koboshchan/pcbai/renders/full_stack_v2/full_stack_top.png

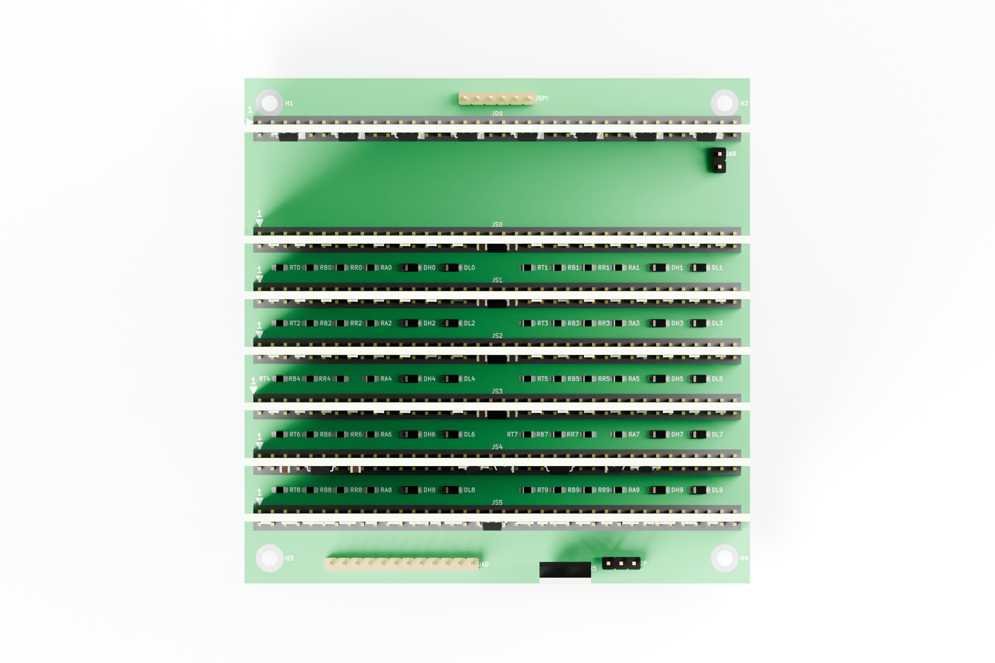
renders/full_stack_v2/full_stack_top.png
