koboshchan/pcbai/renders/ads_carrier/3d_top.png

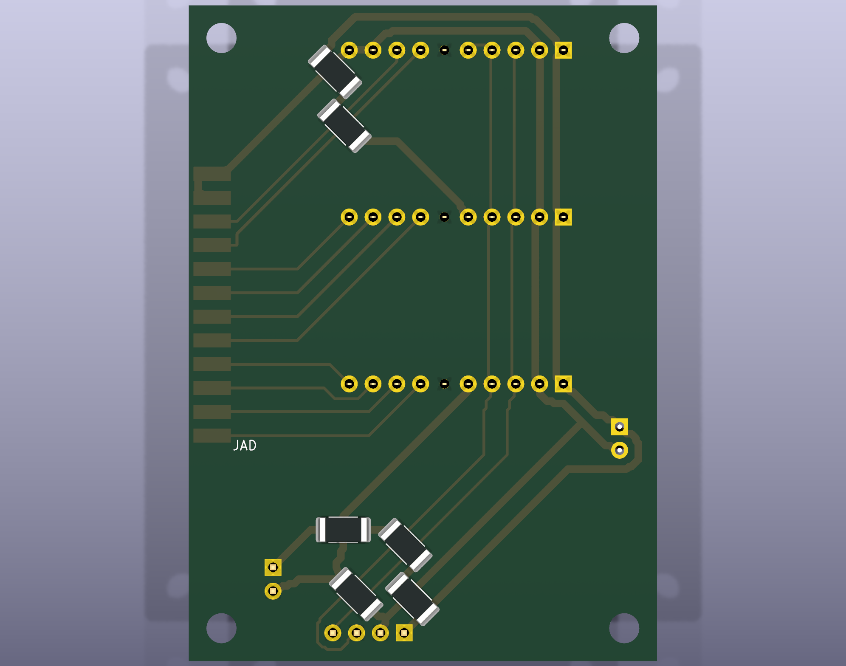
renders/ads_carrier/3d_top.png
