koboshchan/pcbai/training/fixed_model_basic/STATUS.md

Candidate complete. Official test94.54%, existing95.01%, rounded-only92.60%. All1034 resistors use21 Basic0805 values;0Extended. Save186USD assumed62x3USD Extended resistor setup fees. Fixed neural connectivity and component count unchanged. Old fixed_model and all PCB/routing files untouched. New value maps need CAD-owner integration and fresh audit, not automatic promotion. Static model only; rerun PWM dynamics and qualify real opamp/driver/regulator behavior before fabrication. See RESULT.md, metrics.json, checks.json and export_audit.json.
