koboshchan/pcbai/pdfs/motherboard_placement.pdf

# pcbai motherboard · TOP side (F.Cu), viewed from above

source post_crb.kicad_pcb sha256 4932b44c…d1ba · 76 parts on this side · board 100.0 × 100.0 mm · 1 mm = 4.66 pt Reminder: mandatory JS1 B7 → JS2 B7 bodge wire goes on the BOTTOM (see page 2).

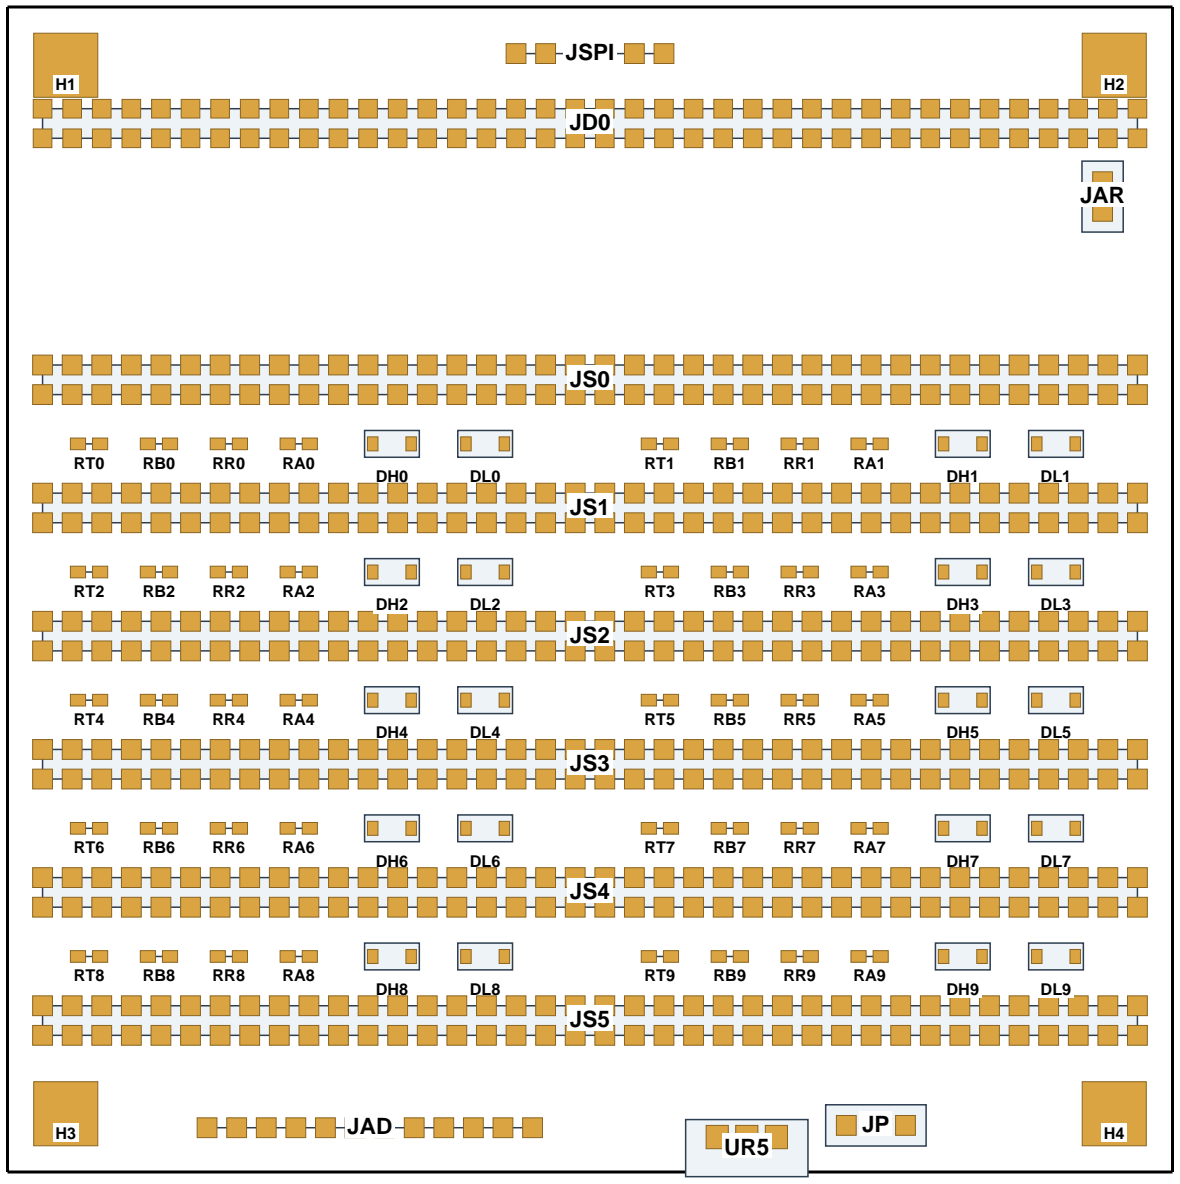
[picture p3: figure]
JAD; JAR; JSPI

pads (gold) and outlines from KiCad footprint pads/CrtYd/Fab geometry; no coordinates invented

# pcbai motherboard · BOTTOM side (B.Cu), MIRRORED: viewed from below

source post_crb.kicad_pcb sha256 4932b44c…d1ba · 9 parts on this side · board 100.0 × 100.0 mm · 1 mm = 4.66 pt
MANDATORY BOTTOM BODGE: wire JS1 pad B7 to JS2 pad B7 (red). Grey dashed = top-mounted THT parts, pins seen through.

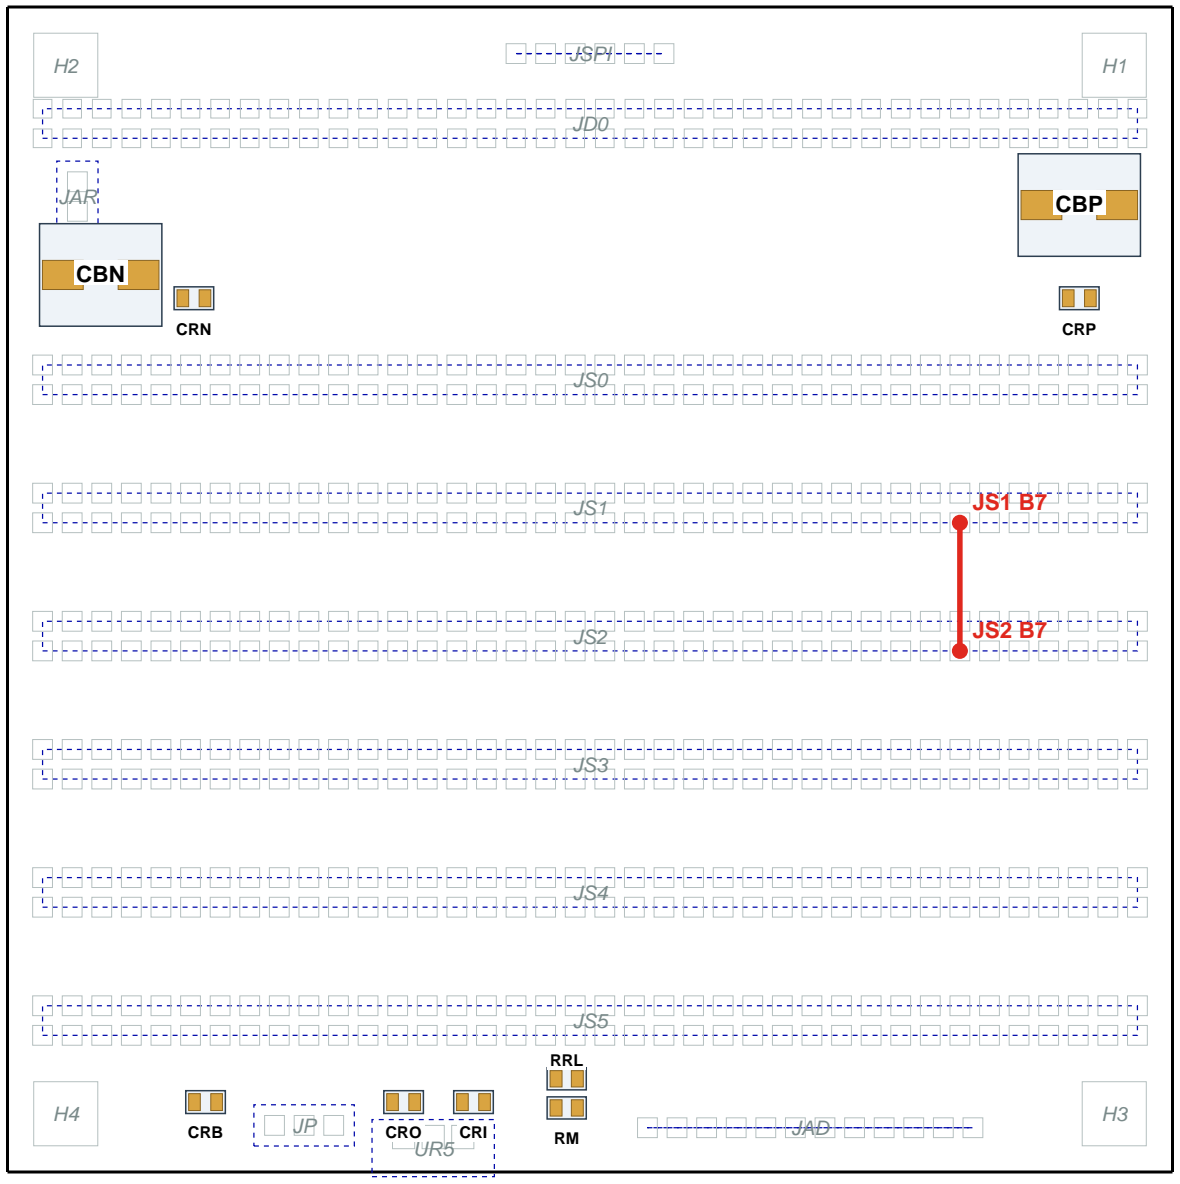
[picture p4: figure]
JAD; JAR; JSPI; RRL; CRP; CBP; CRI; CRN; CRB; CRO; CBN

Bodge endpoints (board mm, KiCad coords): JS1 B7 at (18.25, 44.27), JS2 B7 at (18.25, 55.27). Straight line shown is schematic; route the wire neatly. pads (gold) and outlines from KiCad footprint pads/CrtYd/Fab geometry; no coordinates invented
