koboshchan/pcbai/pdfs/ads_carrier_etch_mirrored_negative.pdf

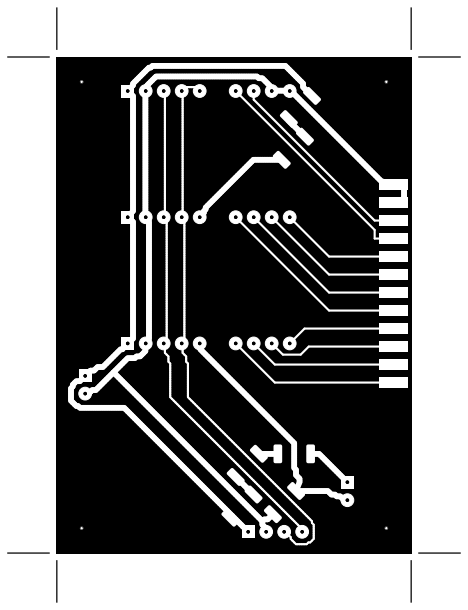
[picture p5: figure]

### SCALE CHECK: bar = exactly 10.0 mm | board = 50.0 x 70.0 mm

## MIRRORED NEGATIVE 1:1, print at 100% / no fit-to-page

ADS carrier v3 F.Cu | copper = clear/white, etch = black | dots = drill centers | src sha256 1405b457...bfd74
Note: 4 white 0.35 mm marks = 3.2 mm mounting-hole centers; they lie inside the drilled holes (intentional).
