koboshchan/pcbai/renders/ads_carrier/3d_bottom.png

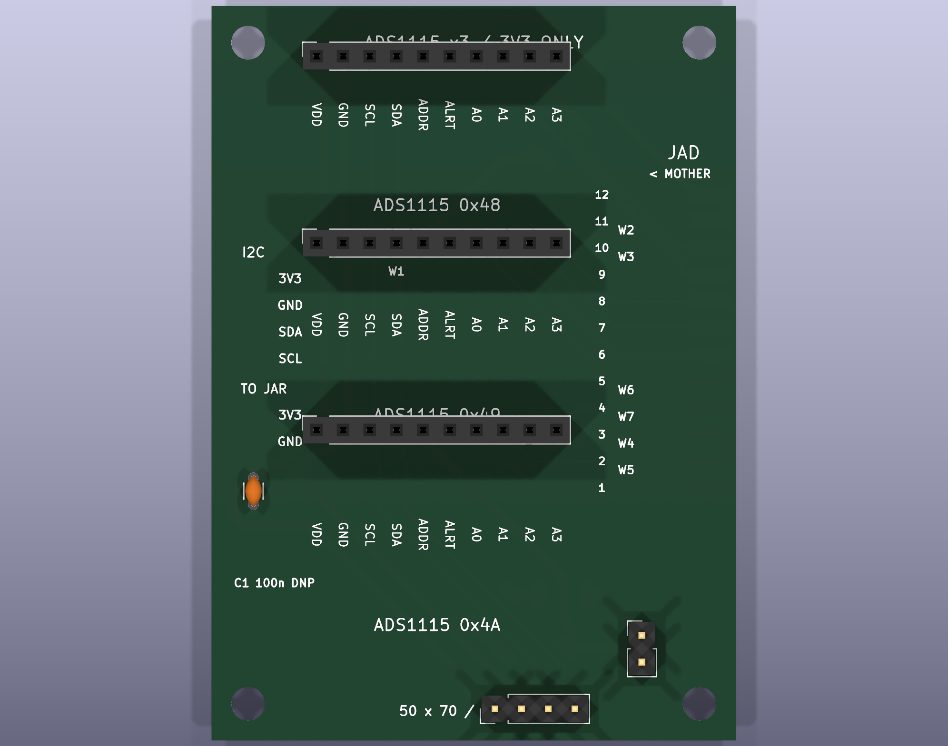
renders/ads_carrier/3d_bottom.png
