koboshchan/pcbai/renders/ads_carrier/copper.png

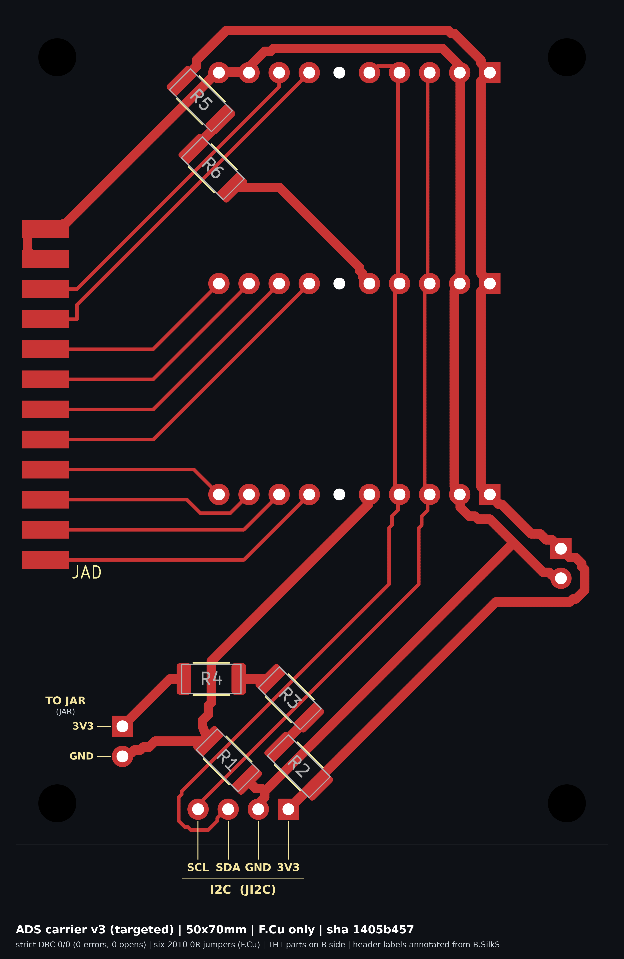
renders/ads_carrier/copper.png
