koboshchan/pcbai/renders/ads_carrier/etch_preview.png

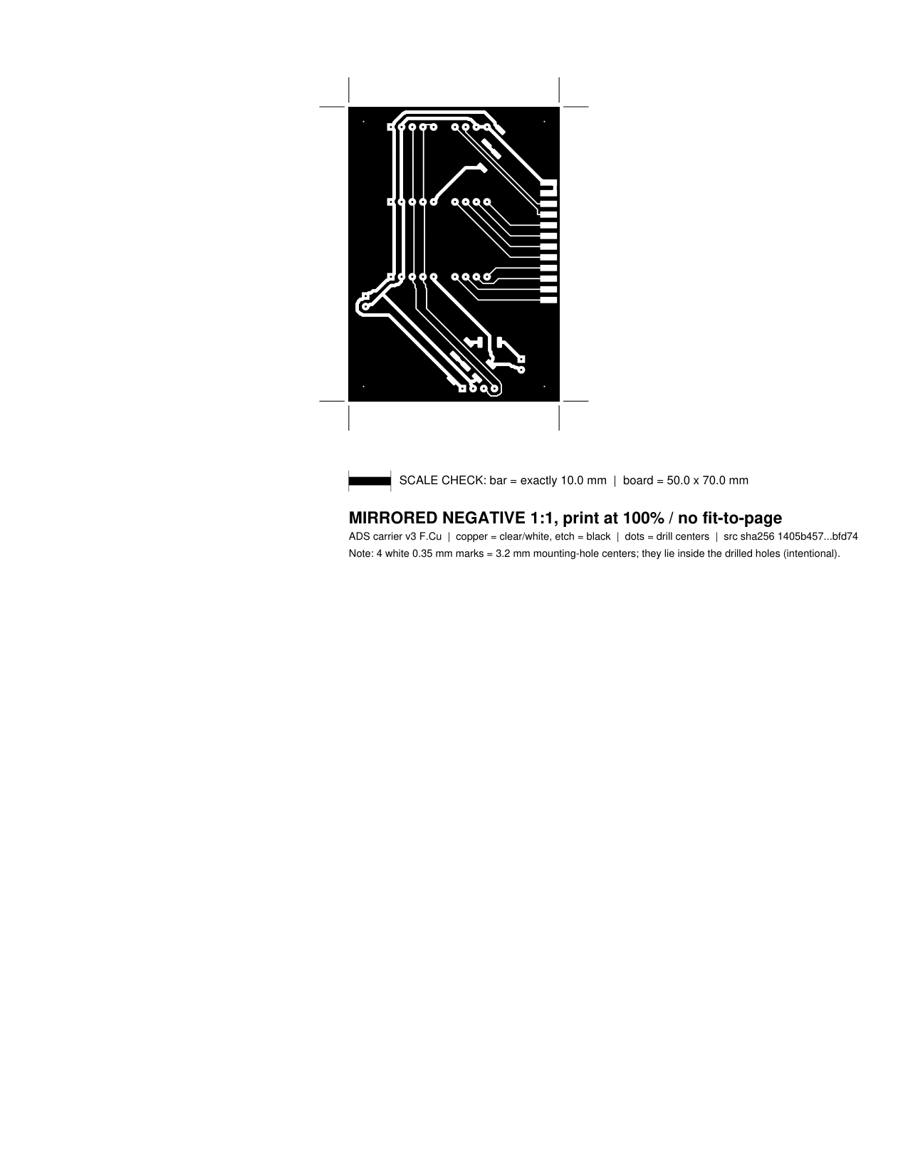
renders/ads_carrier/etch_preview.png
