koboshchan/pcbai/renders/dc0_v2_top.png

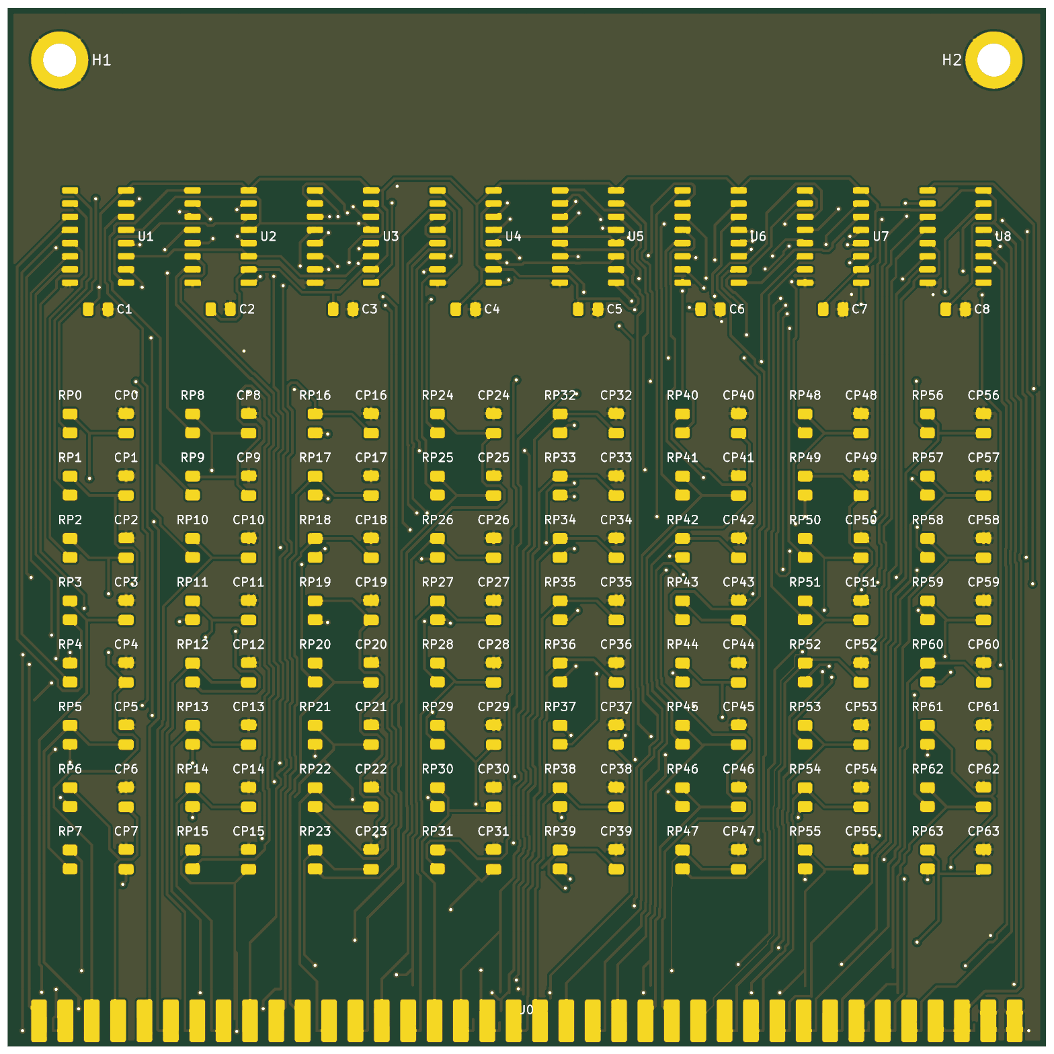
renders/dc0_v2_top.png
