koboshchan/pcbai/renders/dc1/dc1_final_in1_plane.png

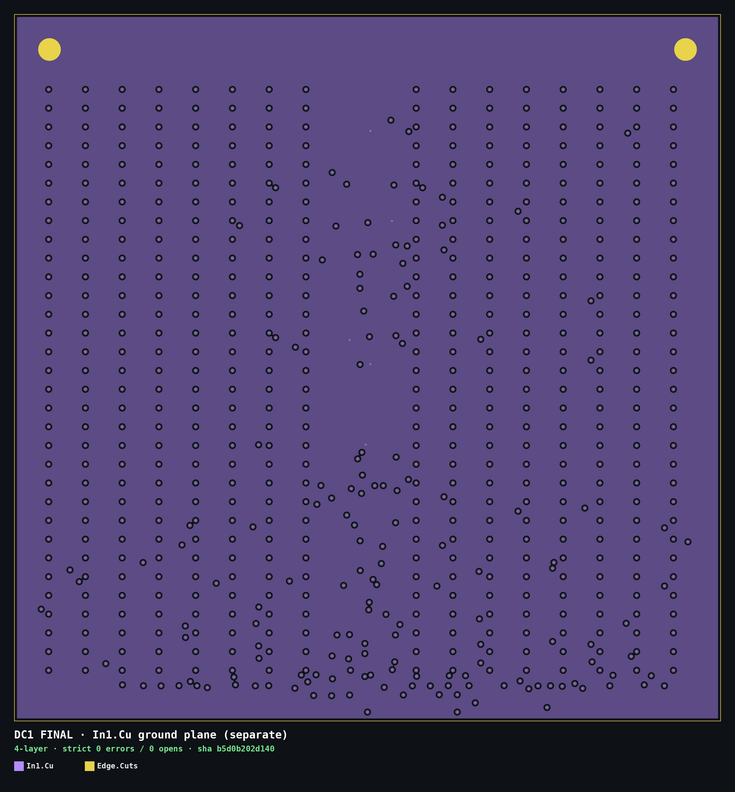
renders/dc1/dc1_final_in1_plane.png
