koboshchan/pcbai/renders/dc1/dc1_final_in2_overlay.png

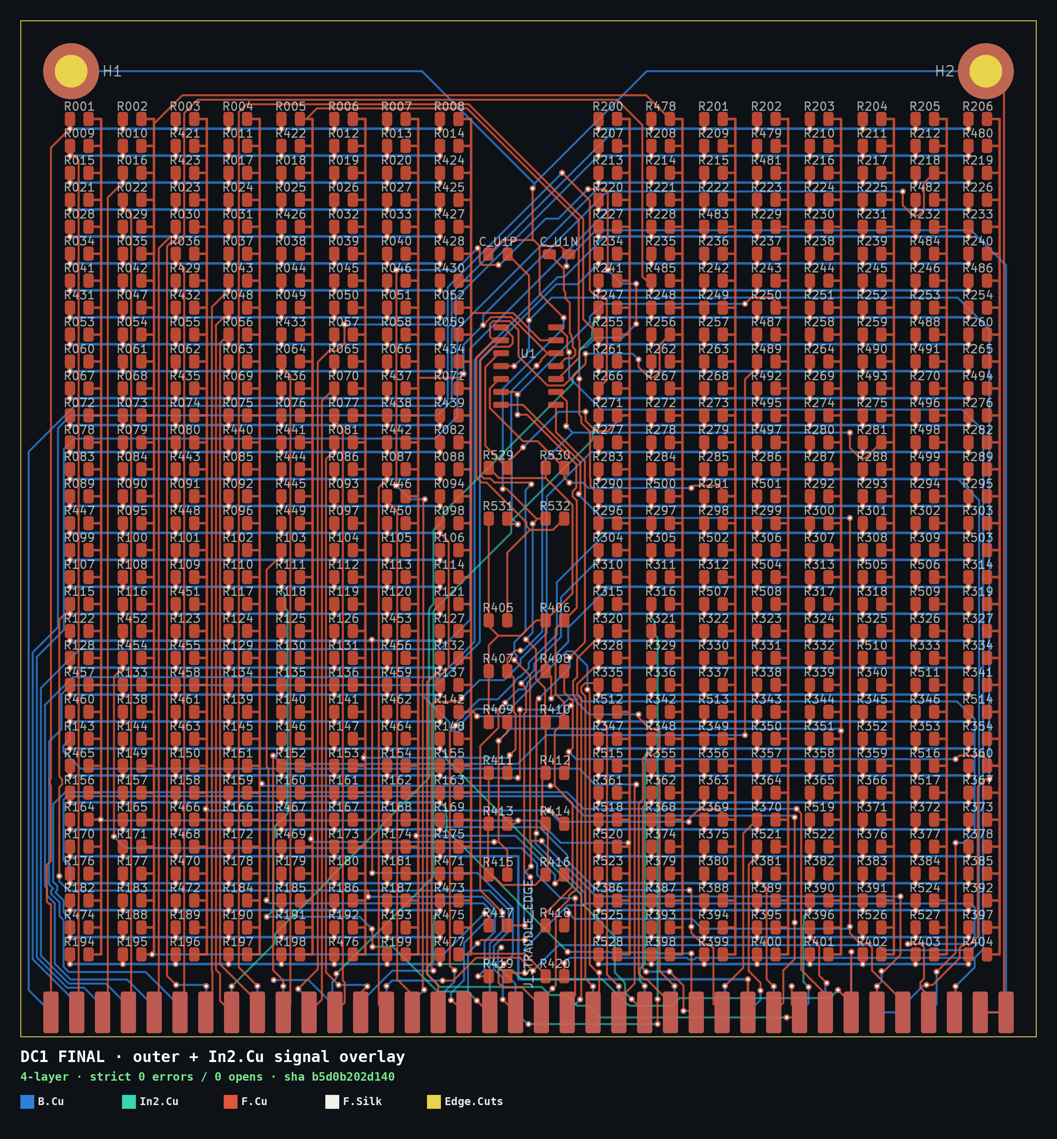
renders/dc1/dc1_final_in2_overlay.png
