koboshchan/pcbai/renders/dc1/dc1_final_outer.png

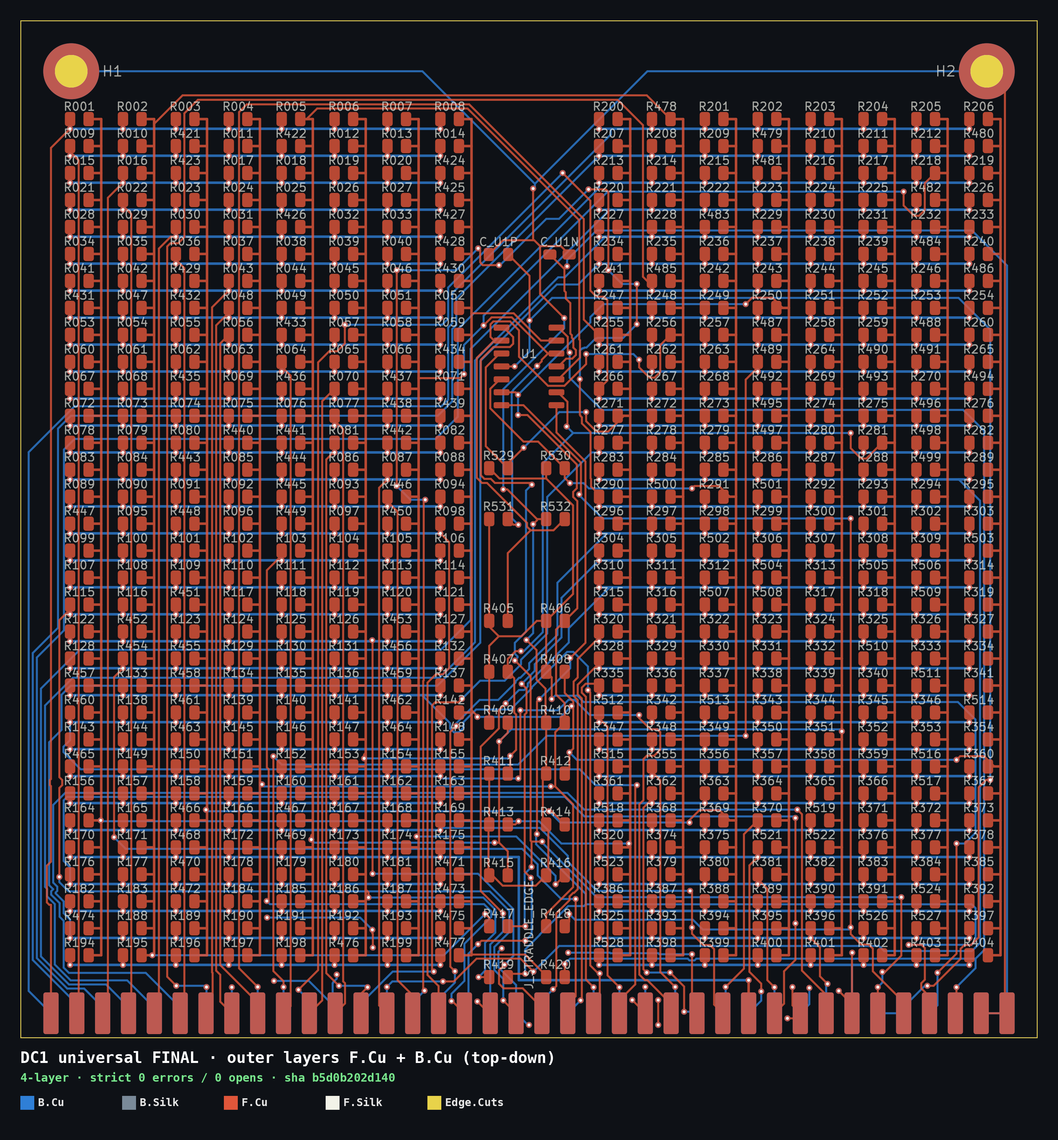
renders/dc1/dc1_final_outer.png
