koboshchan/pcbai/renders/dc3_v2_top.png

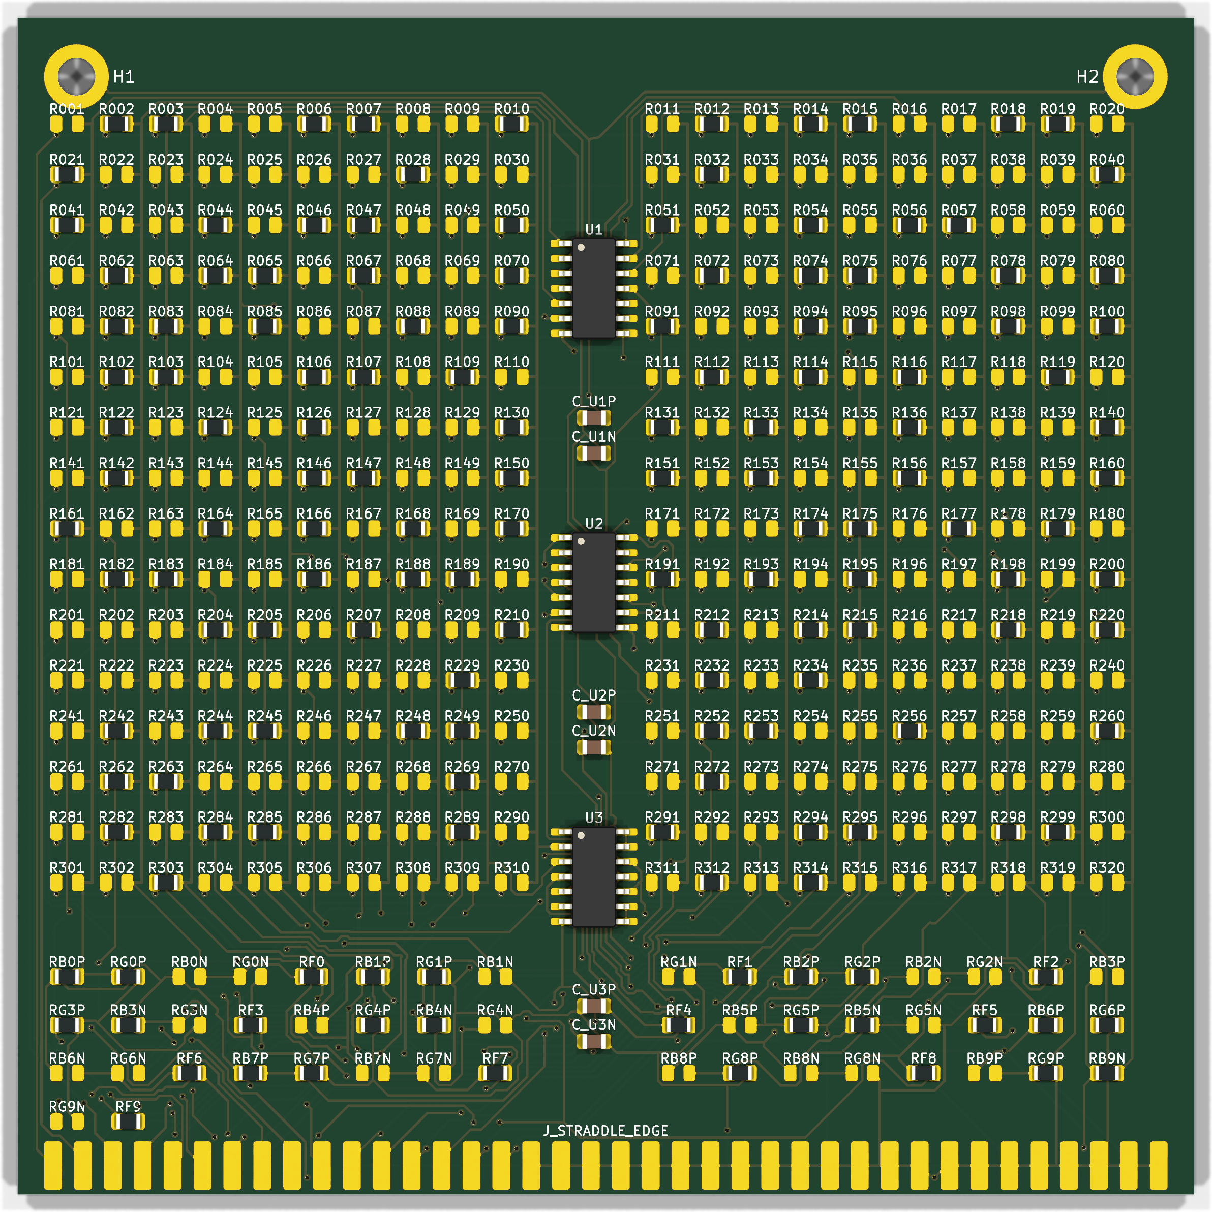
renders/dc3_v2_top.png
