koboshchan/pcbai/renders/full_stack_v2/full_stack_front.png

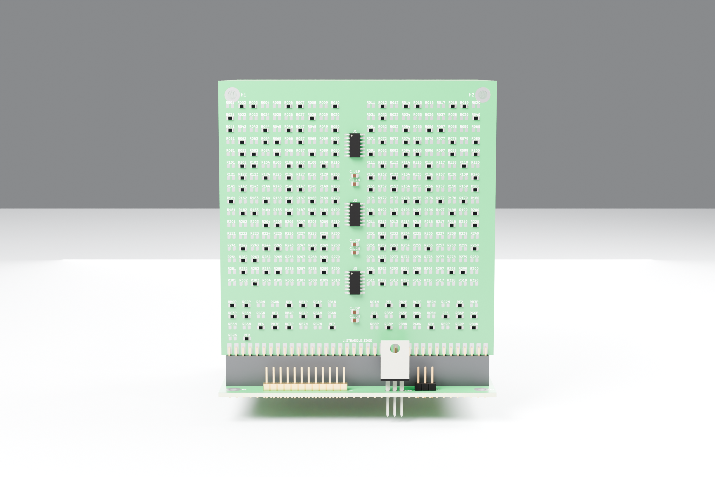
renders/full_stack_v2/full_stack_front.png
