koboshchan/pcbai/renders/full_stack_v2/full_stack_hero_34.png

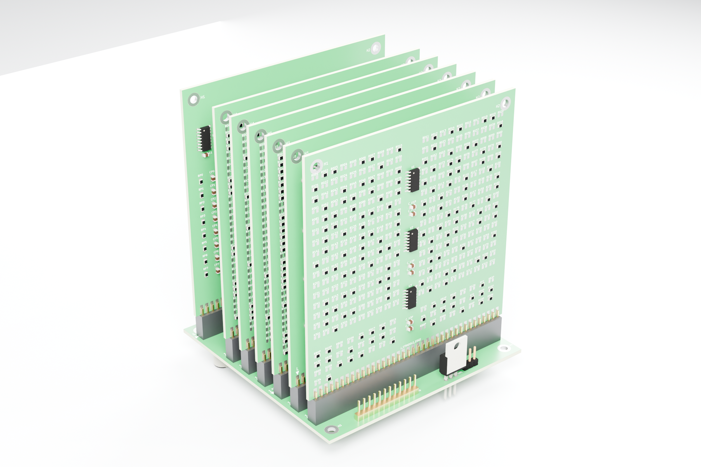
renders/full_stack_v2/full_stack_hero_34.png
