koboshchan/pcbai/renders/mb_v2_top.png

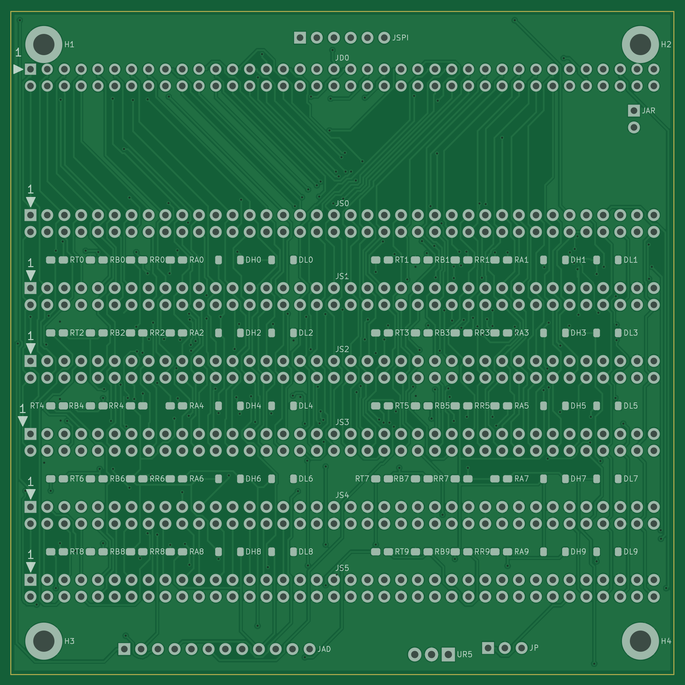
renders/mb_v2_top.png
