koboshchan/pcbai/boards/bom/DC2.csv

reference | value | package | footprint | side | status | tolerance_percent | x_mm | y_mm | source_value | original_reference
C_U1N | 0.1uF | C_0805_2012Metric | Capacitor_SMD:C_0805_2012Metric | F | FIT |  | 72.32 | 20.0 | 0.1uF
C_U1P | 0.1uF | C_0805_2012Metric | Capacitor_SMD:C_0805_2012Metric | F | FIT |  | 52.32 | 20.0 | 0.1uF
C_U2N | 0.1uF | C_0805_2012Metric | Capacitor_SMD:C_0805_2012Metric | F | FIT |  | 72.32 | 40.0 | 0.1uF
C_U2P | 0.1uF | C_0805_2012Metric | Capacitor_SMD:C_0805_2012Metric | F | FIT |  | 52.32 | 40.0 | 0.1uF
C_U3N | 0.1uF | C_0805_2012Metric | Capacitor_SMD:C_0805_2012Metric | F | FIT |  | 72.32 | 60.0 | 0.1uF
C_U3P | 0.1uF | C_0805_2012Metric | Capacitor_SMD:C_0805_2012Metric | F | FIT |  | 52.32 | 60.0 | 0.1uF
C_U4N | 0.1uF | C_0805_2012Metric | Capacitor_SMD:C_0805_2012Metric | F | FIT |  | 72.32 | 80.0 | 0.1uF
C_U4P | 0.1uF | C_0805_2012Metric | Capacitor_SMD:C_0805_2012Metric | F | FIT |  | 52.32 | 80.0 | 0.1uF
C_U_BUF1N | 0.1uF | C_0805_2012Metric | Capacitor_SMD:C_0805_2012Metric | F | FIT |  | 22.0 | 15.0 | 0.1uF
C_U_BUF1P | 0.1uF | C_0805_2012Metric | Capacitor_SMD:C_0805_2012Metric | F | FIT |  | 8.0 | 15.0 | 0.1uF
C_U_BUF2N | 0.1uF | C_0805_2012Metric | Capacitor_SMD:C_0805_2012Metric | F | FIT |  | 22.0 | 35.0 | 0.1uF
C_U_BUF2P | 0.1uF | C_0805_2012Metric | Capacitor_SMD:C_0805_2012Metric | F | FIT |  | 8.0 | 35.0 | 0.1uF
C_U_BUF3N | 0.1uF | C_0805_2012Metric | Capacitor_SMD:C_0805_2012Metric | F | FIT |  | 22.0 | 55.0 | 0.1uF
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
R_FB_11 | 10k | R_0805_2012Metric | Resistor_SMD:R_0805_2012Metric | F | FIT |  | 77.32 | 63.81 | 10k
R_FB_12 | 10k | R_0805_2012Metric | Resistor_SMD:R_0805_2012Metric | F | FIT |  | 47.32 | 76.19 | 10k
R_FB_13 | 10k | R_0805_2012Metric | Resistor_SMD:R_0805_2012Metric | F | FIT |  | 77.32 | 76.19 | 10k
R_FB_14 | 10k | R_0805_2012Metric | Resistor_SMD:R_0805_2012Metric | F | FIT |  | 47.32 | 83.81 | 10k
R_FB_15 | 10k | R_0805_2012Metric | Resistor_SMD:R_0805_2012Metric | F | FIT |  | 77.32 | 83.81 | 10k
R_IN_0 | 10k | R_0805_2012Metric | Resistor_SMD:R_0805_2012Metric | F | FIT |  | 43.32 | 16.19 | 10k
R_IN_1 | 10k | R_0805_2012Metric | Resistor_SMD:R_0805_2012Metric | F | FIT |  | 81.32 | 16.19 | 10k
R_IN_2 | 10k | R_0805_2012Metric | Resistor_SMD:R_0805_2012Metric | F | FIT |  | 43.32 | 23.81 | 10k
R_IN_3 | 10k | R_0805_2012Metric | Resistor_SMD:R_0805_2012Metric | F | FIT |  | 81.32 | 23.81 | 10k
R_IN_4 | 10k | R_0805_2012Metric | Resistor_SMD:R_0805_2012Metric | F | FIT |  | 43.32 | 36.19 | 10k
R_IN_5 | 10k | R_0805_2012Metric | Resistor_SMD:R_0805_2012Metric | F | FIT |  | 81.32 | 36.19 | 10k
R_IN_6 | 10k | R_0805_2012Metric | Resistor_SMD:R_0805_2012Metric | F | FIT |  | 43.32 | 43.81 | 10k
R_IN_7 | 10k | R_0805_2012Metric | Resistor_SMD:R_0805_2012Metric | F | FIT |  | 81.32 | 43.81 | 10k
R_IN_8 | 10k | R_0805_2012Metric | Resistor_SMD:R_0805_2012Metric | F | FIT |  | 43.32 | 56.19 | 10k
R_IN_9 | 10k | R_0805_2012Metric | Resistor_SMD:R_0805_2012Metric | F | FIT |  | 81.32 | 56.19 | 10k
R_IN_10 | 10k | R_0805_2012Metric | Resistor_SMD:R_0805_2012Metric | F | FIT |  | 43.32 | 63.81 | 10k
R_IN_11 | 10k | R_0805_2012Metric | Resistor_SMD:R_0805_2012Metric | F | FIT |  | 81.32 | 63.81 | 10k
R_IN_12 | 10k | R_0805_2012Metric | Resistor_SMD:R_0805_2012Metric | F | FIT |  | 43.32 | 76.19 | 10k
R_IN_13 | 10k | R_0805_2012Metric | Resistor_SMD:R_0805_2012Metric | F | FIT |  | 81.32 | 76.19 | 10k
R_IN_14 | 10k | R_0805_2012Metric | Resistor_SMD:R_0805_2012Metric | F | FIT |  | 43.32 | 83.81 | 10k
R_IN_15 | 10k | R_0805_2012Metric | Resistor_SMD:R_0805_2012Metric | F | FIT |  | 81.32 | 83.81 | 10k
U1 | TL074 | SOIC-14_3.9x8.7mm_P1.27mm | Package_SO:SOIC-14_3.9x8.7mm_P1.27mm | F | FIT |  | 62.32 | 20.0 | TL074
U2 | TL074 | SOIC-14_3.9x8.7mm_P1.27mm | Package_SO:SOIC-14_3.9x8.7mm_P1.27mm | F | FIT |  | 62.32 | 40.0 | TL074
U3 | TL074 | SOIC-14_3.9x8.7mm_P1.27mm | Package_SO:SOIC-14_3.9x8.7mm_P1.27mm | F | FIT |  | 62.32 | 60.0 | TL074
U4 | TL074 | SOIC-14_3.9x8.7mm_P1.27mm | Package_SO:SOIC-14_3.9x8.7mm_P1.27mm | F | FIT |  | 62.32 | 80.0 | TL074
U_BUF1 | TL074 | SOIC-14_3.9x8.7mm_P1.27mm | Package_SO:SOIC-14_3.9x8.7mm_P1.27mm | F | FIT |  | 15.0 | 15.0 | TL074
U_BUF2 | TL074 | SOIC-14_3.9x8.7mm_P1.27mm | Package_SO:SOIC-14_3.9x8.7mm_P1.27mm | F | FIT |  | 15.0 | 35.0 | TL074
U_BUF3 | TL074 | SOIC-14_3.9x8.7mm_P1.27mm | Package_SO:SOIC-14_3.9x8.7mm_P1.27mm | F | FIT |  | 15.0 | 55.0 | TL074
U_BUF4 | TL074 | SOIC-14_3.9x8.7mm_P1.27mm | Package_SO:SOIC-14_3.9x8.7mm_P1.27mm | F | FIT |  | 15.0 | 75.0 | TL074
