koboshchan/pcbai/boards/bom/motherboard_TOP.csv

reference | value | footprint | side | status | x_mm | y_mm
DH0 | 1N4148W | D_SOD-123 | F | FIT | 33.0 | 37.5
DH1 | 1N4148W | D_SOD-123 | F | FIT | 82.0 | 37.5
DH2 | 1N4148W | D_SOD-123 | F | FIT | 33.0 | 48.5
DH3 | 1N4148W | D_SOD-123 | F | FIT | 82.0 | 48.5
DH4 | 1N4148W | D_SOD-123 | F | FIT | 33.0 | 59.5
DH5 | 1N4148W | D_SOD-123 | F | FIT | 82.0 | 59.5
DH6 | 1N4148W | D_SOD-123 | F | FIT | 33.0 | 70.5
DH7 | 1N4148W | D_SOD-123 | F | FIT | 82.0 | 70.5
DH8 | 1N4148W | D_SOD-123 | F | FIT | 33.0 | 81.5
DH9 | 1N4148W | D_SOD-123 | F | FIT | 82.0 | 81.5
DL0 | 1N4148W | D_SOD-123 | F | FIT | 41.0 | 37.5
DL1 | 1N4148W | D_SOD-123 | F | FIT | 90.0 | 37.5
DL2 | 1N4148W | D_SOD-123 | F | FIT | 41.0 | 48.5
DL3 | 1N4148W | D_SOD-123 | F | FIT | 90.0 | 48.5
DL4 | 1N4148W | D_SOD-123 | F | FIT | 41.0 | 59.5
DL5 | 1N4148W | D_SOD-123 | F | FIT | 90.0 | 59.5
DL6 | 1N4148W | D_SOD-123 | F | FIT | 41.0 | 70.5
DL7 | 1N4148W | D_SOD-123 | F | FIT | 90.0 | 70.5
DL8 | 1N4148W | D_SOD-123 | F | FIT | 41.0 | 81.5
DL9 | 1N4148W | D_SOD-123 | F | FIT | 90.0 | 81.5
JAD | Scores_DIV_3V3_Out | Connector_PinHeader_2.54mm:PinHeader_1x12_P2.54mm_Vertical | F | FIT | 31.1 | 96.2
JAR | 3V3_GND_FROM_MCU | PinHeader_1x02_P2.54mm_Vertical | F | FIT | 94.0 | 15.0
JD0 | 2x38_2.54mm_GENERIC_MANUAL_SOCKET | DC0_Isolated:Socket2x38 | F | FIT | 50.0 | 10.0
JP | +15V_GND_-15V | PinHeader_1x03_P2.54mm_Vertical | F | FIT | 72.0 | 96.0
JS0 | Slot0: DC1A (L1 Neurons 0..3) | Connector_PinSocket_2.54mm:PinSocket_2x38_P2.54mm_Vertical | F | FIT | 50.0 | 32.0
JS1 | Slot1: DC1B (L1 Neurons 4..7) | Connector_PinSocket_2.54mm:PinSocket_2x38_P2.54mm_Vertical | F | FIT | 50.0 | 43.0
JS2 | Slot2: DC1C (L1 Neurons 8..11) | Connector_PinSocket_2.54mm:PinSocket_2x38_P2.54mm_Vertical | F | FIT | 50.0 | 54.0
JS3 | Slot3: DC1D (L1 Neurons 12..15) | Connector_PinSocket_2.54mm:PinSocket_2x38_P2.54mm_Vertical | F | FIT | 50.0 | 65.0
JS4 | Slot4: DC2 (16x Active Precision ReLU) | Connector_PinSocket_2.54mm:PinSocket_2x38_P2.54mm_Vertical | F | FIT | 50.0 | 76.0
JS5 | Slot5: DC3 (L2 Weights + 10-Way WTA) | Connector_PinSocket_2.54mm:PinSocket_2x38_P2.54mm_Vertical | F | FIT | 50.0 | 87.0
JSPI | MCU_3V3_SPI_PIN1_NC | Connector_PinHeader_2.54mm:PinHeader_1x06_P2.54mm_Vertical | F | FIT | 50.0 | 4.0
RA0 | 1k | Resistor_SMD:R_0805_2012Metric | F | FIT | 25.0 | 37.5
RA1 | 1k | Resistor_SMD:R_0805_2012Metric | F | FIT | 74.0 | 37.5
RA2 | 1k | Resistor_SMD:R_0805_2012Metric | F | FIT | 25.0 | 48.5
RA3 | 1k | Resistor_SMD:R_0805_2012Metric | F | FIT | 74.0 | 48.5
RA4 | 1k | Resistor_SMD:R_0805_2012Metric | F | FIT | 25.0 | 59.5
RA5 | 1k | Resistor_SMD:R_0805_2012Metric | F | FIT | 74.0 | 59.5
RA6 | 1k | Resistor_SMD:R_0805_2012Metric | F | FIT | 25.0 | 70.5
RA7 | 1k | Resistor_SMD:R_0805_2012Metric | F | FIT | 74.0 | 70.5
RA8 | 1k | Resistor_SMD:R_0805_2012Metric | F | FIT | 25.0 | 81.5
RA9 | 1k | Resistor_SMD:R_0805_2012Metric | F | FIT | 74.0 | 81.5
RB0 | 22k | Resistor_SMD:R_0805_2012Metric | F | FIT | 13.0 | 37.5
RB1 | 22k | Resistor_SMD:R_0805_2012Metric | F | FIT | 62.0 | 37.5
RB2 | 22k | Resistor_SMD:R_0805_2012Metric | F | FIT | 13.0 | 48.5
RB3 | 22k | Resistor_SMD:R_0805_2012Metric | F | FIT | 62.0 | 48.5
RB4 | 22k | Resistor_SMD:R_0805_2012Metric | F | FIT | 13.0 | 59.5
RB5 | 22k | Resistor_SMD:R_0805_2012Metric | F | FIT | 62.0 | 59.5
RB6 | 22k | Resistor_SMD:R_0805_2012Metric | F | FIT | 13.0 | 70.5
RB7 | 22k | Resistor_SMD:R_0805_2012Metric | F | FIT | 62.0 | 70.5
RB8 | 22k | Resistor_SMD:R_0805_2012Metric | F | FIT | 13.0 | 81.5
RB9 | 22k | Resistor_SMD:R_0805_2012Metric | F | FIT | 62.0 | 81.5
RR0 | 22k | Resistor_SMD:R_0805_2012Metric | F | FIT | 19.0 | 37.5
RR1 | 22k | Resistor_SMD:R_0805_2012Metric | F | FIT | 68.0 | 37.5
RR2 | 22k | Resistor_SMD:R_0805_2012Metric | F | FIT | 19.0 | 48.5
RR3 | 22k | Resistor_SMD:R_0805_2012Metric | F | FIT | 68.0 | 48.5
RR4 | 22k | Resistor_SMD:R_0805_2012Metric | F | FIT | 19.0 | 59.5
RR5 | 22k | Resistor_SMD:R_0805_2012Metric | F | FIT | 68.0 | 59.5
RR6 | 22k | Resistor_SMD:R_0805_2012Metric | F | FIT | 19.0 | 70.5
RR7 | 22k | Resistor_SMD:R_0805_2012Metric | F | FIT | 68.0 | 70.5
RR8 | 22k | Resistor_SMD:R_0805_2012Metric | F | FIT | 19.0 | 81.5
RR9 | 22k | Resistor_SMD:R_0805_2012Metric | F | FIT | 68.0 | 81.5
RT0 | 220k | Resistor_SMD:R_0805_2012Metric | F | FIT | 7.0 | 37.5
RT1 | 220k | Resistor_SMD:R_0805_2012Metric | F | FIT | 56.0 | 37.5
RT2 | 220k | Resistor_SMD:R_0805_2012Metric | F | FIT | 7.0 | 48.5
RT3 | 220k | Resistor_SMD:R_0805_2012Metric | F | FIT | 56.0 | 48.5
RT4 | 220k | Resistor_SMD:R_0805_2012Metric | F | FIT | 7.0 | 59.5
RT5 | 220k | Resistor_SMD:R_0805_2012Metric | F | FIT | 56.0 | 59.5
RT6 | 220k | Resistor_SMD:R_0805_2012Metric | F | FIT | 7.0 | 70.5
RT7 | 220k | Resistor_SMD:R_0805_2012Metric | F | FIT | 56.0 | 70.5
RT8 | 220k | Resistor_SMD:R_0805_2012Metric | F | FIT | 7.0 | 81.5
RT9 | 220k | Resistor_SMD:R_0805_2012Metric | F | FIT | 56.0 | 81.5
UR5 | L7805CV | TO-220-3_Vertical | F | FIT | 66.0 | 97.0
