koboshchan/pcbai/training/fixed_model_basic/RESULT.md

Basic-only resistor candidate, not promoted to CAD or fabrication.

The official 10,000-image MNIST test gives 94.54% (9,454 correct), versus the existing 95.01% (9,501 correct). This loses 0.47 percentage points. Simply rounding the old circuit to nearest Basic values without retraining gives 92.60% (9,260 correct).

Retrained 1,000-board Monte Carlo, with all 10,000 images on each physical realization, gives 94.39979% mean and 93.92% worst at the historical 5% weight/filter tolerance stress. At 1% weight/filter tolerance, matching the selected resistor specifications, mean is 94.46549% and worst is 94.05%. Feedback, balance, rectifier ratios and ADC parts remain 1% in both cases. Components are independently drawn uniformly once per board; correlated source loading and shared components are retained. Rounded-only comparison gives 92.46074% mean / 91.28% worst at 5%, and 92.56772% mean / 91.46% worst at 1%. Existing 5% baseline mean/worst was 94.90848% / 94.47%.

There are 1,034 resistor placements, 21 unique values, and zero Extended resistors in the exported complete resistor map. 799 values change, with all 896 neural component placements, reference names, signs, balance legs and exact pad nets preserved. Existing motherboard and rectifier resistors are also covered. Every part is Basic, 0805 and individually API-verified in stock; stock exceeds complete-board quantities with 10% margin. The requested 62 Extended resistor types at $3/type therefore save $186 USD in assumed setup fees. Other Extended IC/capacitor fees, assembly labor, PCB price, shipping, taxes and part-price changes are not included in that saving.

The catalog query returned 57 in-stock Basic 0805 resistor values, all specified ±1%, including 0Ω. Its maximum is 1MΩ. High-value old weights up to 6.2MΩ necessarily change. The only non-neural change is regulator minimum-load R_REG_MINLOAD from 820Ω to 680Ω. At 5V it draws 7.353mA and dissipates 36.765mW, below its selected 125mW rating; at 15V input the regulator dissipation increases approximately 12.554mW. This is not a rail/thermal hardware qualification.

Training directly optimizes physical log-resistances with straight-through nearest-log-value snapping. The architecture stays 64 grayscale 6-bit PWM inputs with 10k/1uF RC, 16 signed summers, precision ReLU and followers, ten L2 score summers, 12-bit ADC and MCU argmax. No analog WTA. RF is fixed at 100k. Input source is 10,050Ω, ideal summer clip is ±13.5V, ReLU clip is 12.7V and rails are ±15V. Training uses 55,000 samples and validation uses 5,000 with the original seed42064 split and original crop/BOX8x8 preprocessing. Best validation accuracy is 94.32%. The 320-epoch schedule and checkpoint were selected using validation only. The official test was first read after training completed and is not used for epoch selection.

NumPy and float64 CUDA agree on nominal and three seeded physical realizations. Exported physical scores and float32 QAT scores agree within 24.402uV. Conservative 10V-swing nominal accuracy is 94.41%, versus rounded-only 92.62%. ADC divider corners, unchanged from the existing design, are 0.75614..2.38679V at ±15V scores with 1% resistor corners and ±5% 3V3. Power-off possible clamp/backfeed is 62.973uA per pin. External silicon clamps do not establish ADC absolute-voltage guarantees; MCU3V3/GND first, analog last remains required.

The static ideal model is not a loaded TL074 output-swing, commonmode, current or transient guarantee. PWM ripple/settling must be rerun for the new conductances before hardware acceptance. Nominal test-set driver peak is 0.20738mA per input and ACT follower load peak is 0.88633mA. No KiCad board, routed board, authoritative old model, router directory or shared placement was changed. These files are a candidate value map, not a fabrication release.

Use circuit.json and desired_netlist.json for the proposed electrical values. value_map.json covers every resistor, value_changes.csv and value_changes.json list old/new values, basic_resistor_bom.json groups the 21 values with LCSC IDs, and basic_catalog.json records the verified palette. metrics.json includes rounded/trained results and baseline provenance; checks.json and export_audit.json record independent checks. train_basic.py, evaluate.py, export.py, checks.py and catalog.py reproduce the workflow in the repo. Dataset cache remains in the unchanged fixed_model/data folder on kat-box. best.pt is a small checkpoint. Evaluation ran on NVIDIA GeForce RTX 4070 SUPER.
