koboshchan/pcbai/training/hct_vs_ahct/RESULT.md

Genuine 74HCT595 is acceptable for this candidate's analog input drive. There is no meaningful modeled accuracy penalty versus AHCT. This is conditional engineering approval of the logic family, not authentication of the cheap AliExpress chips or a complete board qualification. Ordinary 74HC595 is not an equivalent 3.3V-input substitute at 5V.

The official 10000-example test is unchanged. Every Monte Carlo entry uses 1000 physical boards and the same 10000 examples, seed51005, with paired physical resistor draws between driver cases. Weight/bias and input-filter resistors vary uniformly by the listed tolerance. Feedback, balancing, rectifier and ADC resistors remain1%. No network retraining, CAD, routing, BOM or cart modifications occurred. Historical50ohm simulation is reproduced and checked against the existing evaluator.

| Driver | High/low resistance ohms | Official | 5% MC mean | 5% MC worst | 1% MC mean | 1% MC worst |
| --- | --- | --- | --- | --- | --- | --- |
| ideal | 0/0 | 94.55% | 94.40184% | 93.92% | 94.46770% | 94.06% |
| historical_50ohm | 50/50 | 94.54% | 94.39979% | 93.92% | 94.46549% | 94.05% |
| AHCT_typ_estimate | 50/17 | 94.52% | 94.40183% | 93.92% | 94.46727% | 94.07% |
| AHCT_worst_secant | 87.5/55 | 94.52% | 94.40070% | 93.92% | 94.46644% | 94.05% |
| HCT_typ_graph | 28/29 | 94.54% | 94.40072% | 93.91% | 94.46665% | 94.06% |
| HCT_worst_secant | 110/55 | 94.52% | 94.40138% | 93.93% | 94.46697% | 94.05% |
| Diodes_AHCT_worst_secant | 100/68.75 | 94.52% | not run | not run | not run | not run |

The model solves the shared 64-input KCL, including coupling through positive summer legs, rather than attenuating pixels independently. Each pin drives one 10k series resistor, then one1uF capacitor to ground and the post-filter L1 fanout. There are 8 to 14 L1 resistor branches per filtered input. Those branches do not multiply the output load by their count because the same10k input filter is in series with the whole network. The1uF is not directly connected to the595 output. Source output load is set primarily by10k, so even100ohm driver impedance only changes it by about1%.

For duty d, the averaged output term is g=d/(Rf+Rh)+(1-d)/(Rf+Rl), and its forcing term is d*VCC/(Rf+Rh). High/low asymmetry therefore changes both effective source voltage and impedance. The implementation uses three small fixed-point corrections against a low-state KCL solve, checks residuals below1e-7V, and verifies asymmetric nodes against direct NumPy solves. Driver values are fixed and coherent across64 pins for each case; they are not additional random per-pin draws.

TI HCT at4.5V and6mA specifies minimum VOH3.98V and maximum VOL0.26V at25C, and3.84V/0.33V over-40..125C. Full-temperature secants are110ohm high and55ohm low. Figure6-2/6-3 around4mA gives approximately28ohm high and29ohm low at25C, used for the typical HCT run. TI's current HCT datasheet lists a TSSOP package, not the anonymous cheap SOP16 product, so use this as a family comparison until the actual vendor is known.

TI AHCT at4.5V and8mA specifies minimum VOH3.94V and maximum VOL0.36V at25C, and3.80V/0.44V over-40..125C. Full-temperature secants are87.5ohm high and55ohm low. TI's5V typical low-state graph suggests about17ohm. Its high-state typical curve is not supplied here, so the AHCT typical case is explicitly an estimate retaining the existing conservative50ohm high assumption, not a measured manufacturer typical50ohm value. It is intentionally not a claim that AHCT has weaker typical high drive than HCT.

Diodes74AHCT595 has the same25C3.94V/0.36V points but over-40..125C specifies3.70V/0.55V at8mA, yielding100ohm/68.75ohm secants. This additional nominal case is included because that manufacturer was originally approved. The secant-derived worst cases are sensitivity models, NOT guaranteed sub-mA output resistance or rigorous worst-case accuracy bounds. Extrapolation is stated explicitly; real nonlinear I/V and pin variation require bench measurement.

At5.5V with10k-5%=9.5k, a capacitor initially at the opposite rail gives at most0.5789mA per pin, and4.6316mA for all8 pins on one chip. This conservative charging/discharging bound assumes the RC node remains between ground and VCC during normal powered operation. It does not bound power sequencing, faults, switching shoot-through, or an unpowered opamp feeding the RC node. The source branch current bypasses the uncertainty about detailed fanout and remains far below6mA HCT characterization current and8mA AHCT recommended current.

TI HCT absolute maximum is35mA per output and70mA through VCC/GND. The above analog load uses1.65% of the per-pin maximum and6.62% of the rail maximum, leaving34.421mA and65.368mA respectively before the IC's own consumption. TI/Diodes AHCT limits are25mA and75mA, leaving24.421mA per pin and70.368mA on the supply rail. These absolute maximum margins are stress comparisons, not operating targets.

Across the official test, HCT worst-secant nominal averaged branch peak is0.2069mA. Hypothetical high-phase and low-phase peaks using the averaged RC node are0.4925mA and0.4357mA. Per-eight-input-group average source peaks in mA are[0.7827811465443483, 1.1767489131546234, 1.2418558531907196, 1.0846531477199812, 1.1200734457312613, 1.1221409778385187, 1.1603367174280594, 0.6559029839872895]; sink peaks are[0.6779938747234404, 0.7188794372081229, 0.6194163619820316, 0.6925188262491485, 0.6971343050035321, 0.6879528567695735, 0.6958181921810922, 0.6722350268972156]. The generator maps U_SR1..8 to group starts0,8,16,24,56,48,40,32, so the last four current groups correspond to U_SR8,7,6,5, not U_SR5,6,7,8. QH' only drives the next SER logic input, not another analog channel.

IC supply consumption is additional to output load. TI HCT lists80uA rail-input quiescent ICC plus up to2.9mA per input under its unfavorable0.5V/2.4V test condition. With SER,SRCLK,RCLK,OE conservatively treated as four MCU-level inputs, this illustrative static budget is16.312mA, still below70mA. This2.9mA point is not a guaranteed3.3V supply-current bound. TI AHCT gives40uA ICC and1.5mA per input at3.4V, Diodes gives80uA and1.5mA atVCC-2.1V. Actual clock-frequency-dependent dynamic current must also be allowed for. The tiny analog load is not the reason to select AHCT, and a complete all-condition supply-current guarantee cannot be extracted for anonymous chips from these specs alone.

Both families have2.0V VIH and0.8V VIL at their stated5V operating conditions, so3.3V Pico logic is compatible. HCT is slower. The TI HCT datasheet gives25MHz full-temperature clock characterization at4.5V plus20ns minimum clock/latch pulse widths. Do not silently reuse an AHCT-rate firmware clock above the actual HCT vendor's guaranteed chained-register timing. Capacitor settling, actual PWM frequency, startup, simultaneous switching, PCB supply noise and TL074 nonidealities remain outside this static family comparison.

Rail sensitivity uses common595 VCC and BOTH layers'5V-referenced bias terms together, while retaining3.3V ADC reference. It covers4.5,4.75,5.0,5.25,5.5V on nominal resistors rather than incorrectly moving only the pixels while holding the bias reference fixed. The full results are in metrics.json. This is a sensitivity sweep, not an assertion that the regulator has10% tolerance.

Sources are https://www.ti.com/lit/gpn/SN74HCT595 pages4,5,8; https://www.ti.com/lit/gpn/SN74AHCT595 pages4,5,7; and https://www.diodes.com/datasheet/download/74AHCT595.pdf page4. Manufacturer documents were retrieved and read directly.

Reproduce on a CUDA machine with NumPy and PyTorch using OPENBLAS_NUM_THREADS=1 python3 two_layer/hct_vs_ahct/evaluate.py --boards 1000. Run python3 two_layer/hct_vs_ahct/report.py after evaluation. The project candidate and official dataset must be present. The recorded circuit SHA256 isfeee09c5f0c0d7bbf1811672390111615ae2f70df384ad71d0942f1b8033d278 and test archive SHA256 is798e36a021bca440a162a51b461b9b72c68eb376ec20f743925ef0f53e22cc45.

The plain decision is to use genuine HCT if the cheap listing really contains HCT in the correct footprint and the firmware clock respects its timing. AHCT's higher price is not justified by modeled accuracy or analog current headroom on this10k-filtered design. No cart change or fabrication approval is made by this report.
