koboshchan/pcbai/pdfs/pcbai_value_overlay_overview.pdf

# pcbai value overlay assembly guide

Values shown directly on footprints, exact source precision (not rounded purchase values).

Each board side: full overview page, then 2x2 zoomed tiles (50 x 50 mm each) for printing.

DC1: four population variants a/b/c/d on identical bare PCB. Only fitted parts get values; DNP dimmed.

DC3: DNP sites dimmed. Back sides are MIRRORED (as seen when you flip the board over).

Motherboard: MANDATORY red bodge wire JS1 B7 (18.25, 44.27) to JS2 B7 (18.25, 55.27), back side.

DC0: source value 74AHCT595S16-13; the part actually ordered is 74HCT595 (5V-tolerant HCT, works as drop-in).

Source hashes: DC0_v2 899da15d, DC1 b5d0b202, DC2 04167d23, DC3_v2 d7c2393f, motherboard_v2 4932b44c

# DC0 v2 TOP overview

## source sha 899da15d | 145 fitted | board 100.05 x 100.05 mm

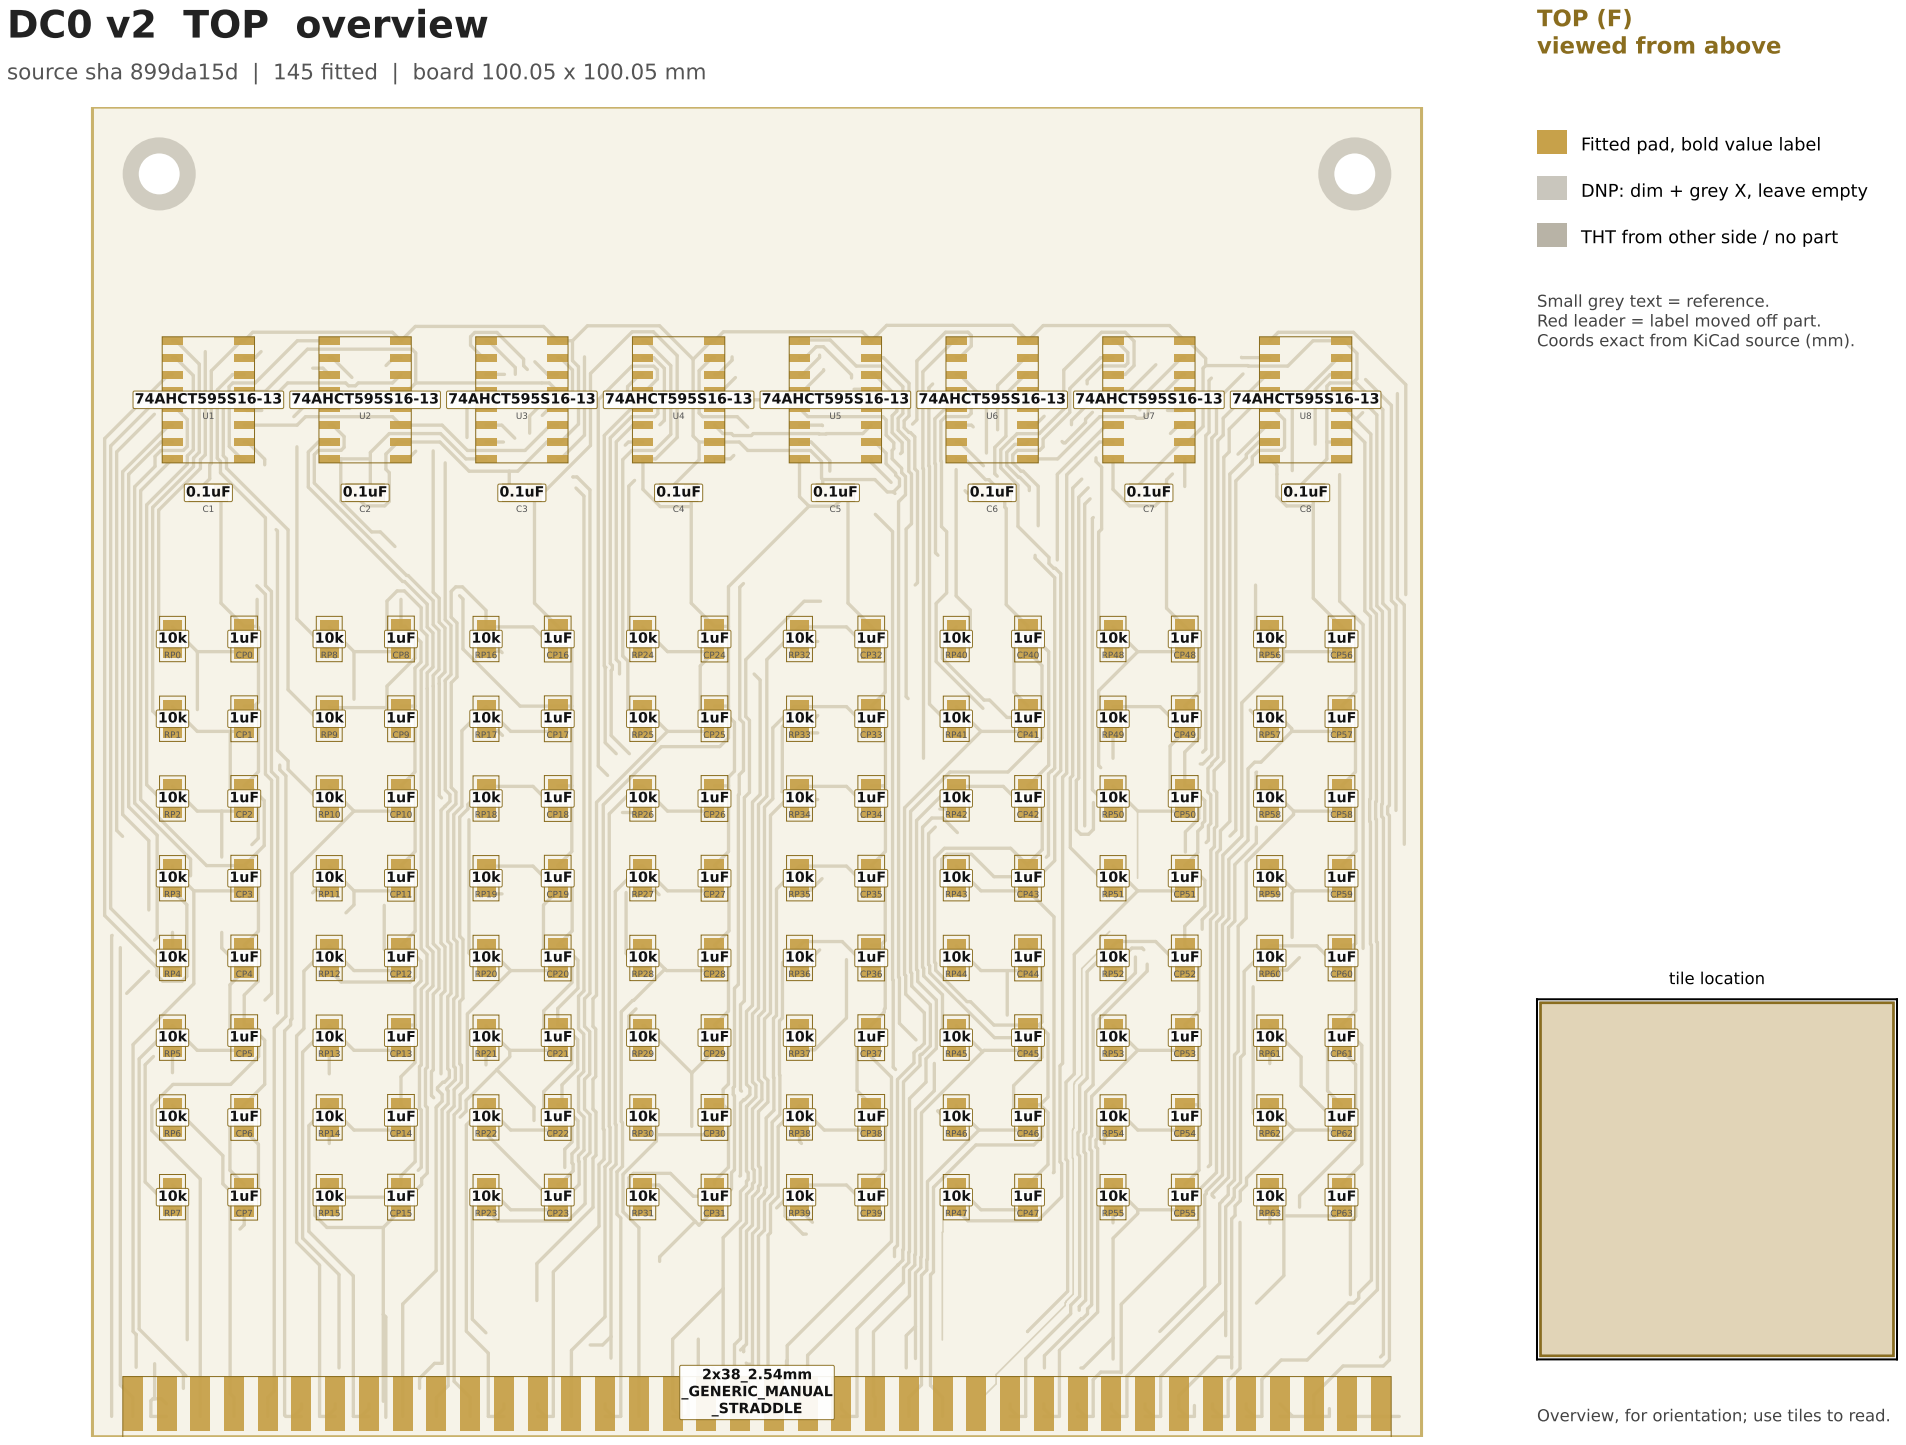
[picture p17: page 2]

Fitted pad, bold value label

DNP: dim + grey X, leave empty

THT from other side / no part

Small grey text = reference.
Red leader = label moved off part.
Coords exact from KiCad source (mm).

Overview, for orientation; use tiles to read.

# DC1 variant a TOP overview

## source sha b5d0b202 | 195 fitted, 341 DNP | board 100.15 x 100.15 mm

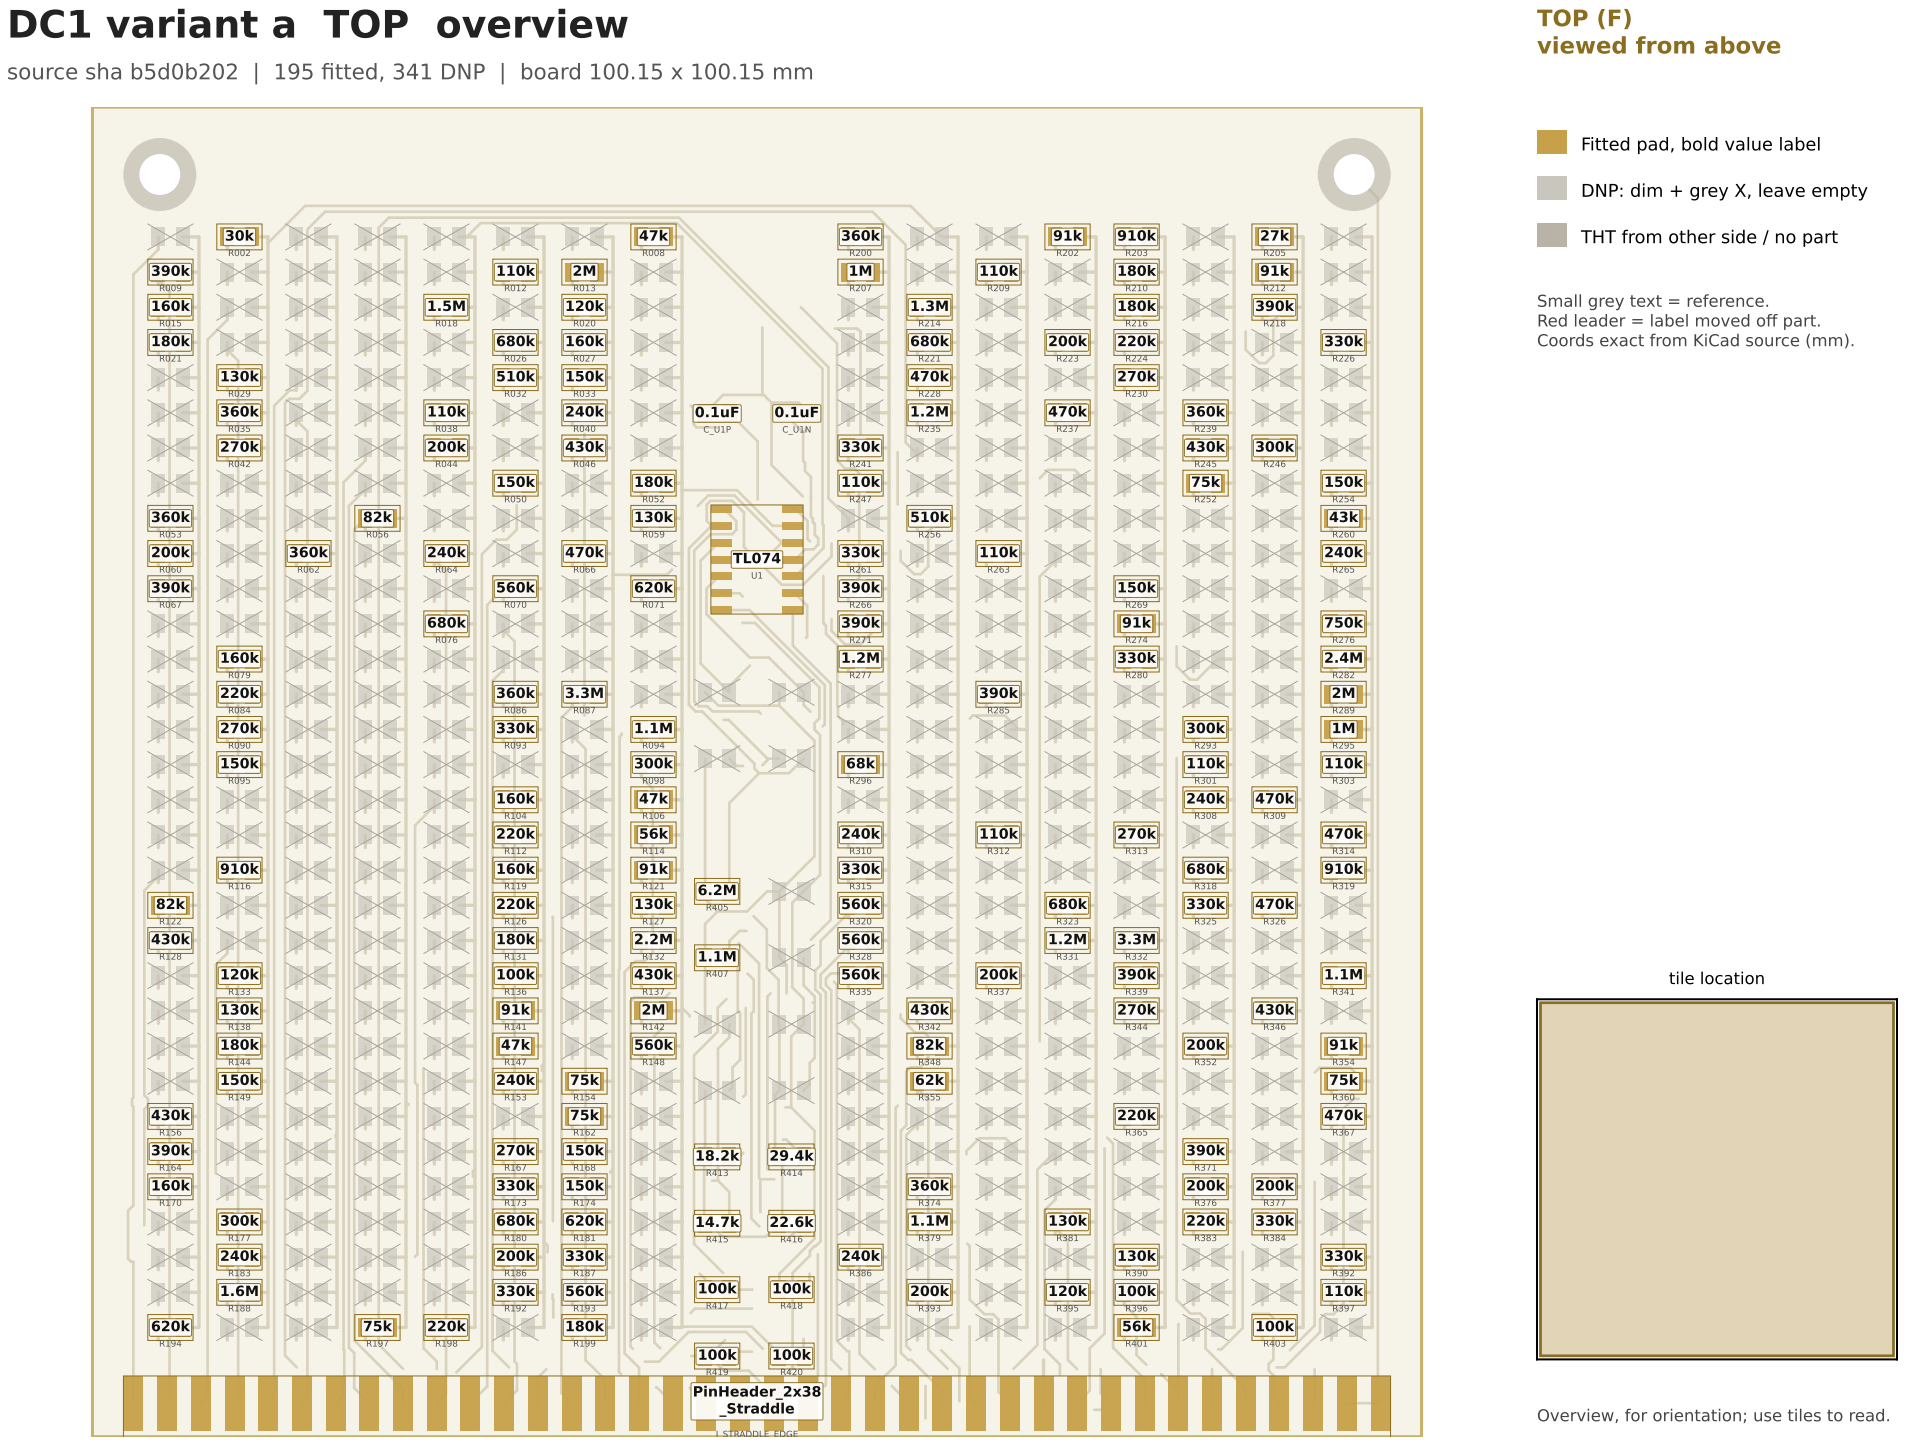
[picture p18: page 3]

Fitted pad, bold value label

DNP: dim + grey X, leave empty

THT from other side / no part

Small grey text = reference.
Red leader = label moved off part.
Coords exact from KiCad source (mm).

# DC1 variant b TOP overview

## source sha b5d0b202 | 234 fitted, 302 DNP | board 100.15 x 100.15 mm

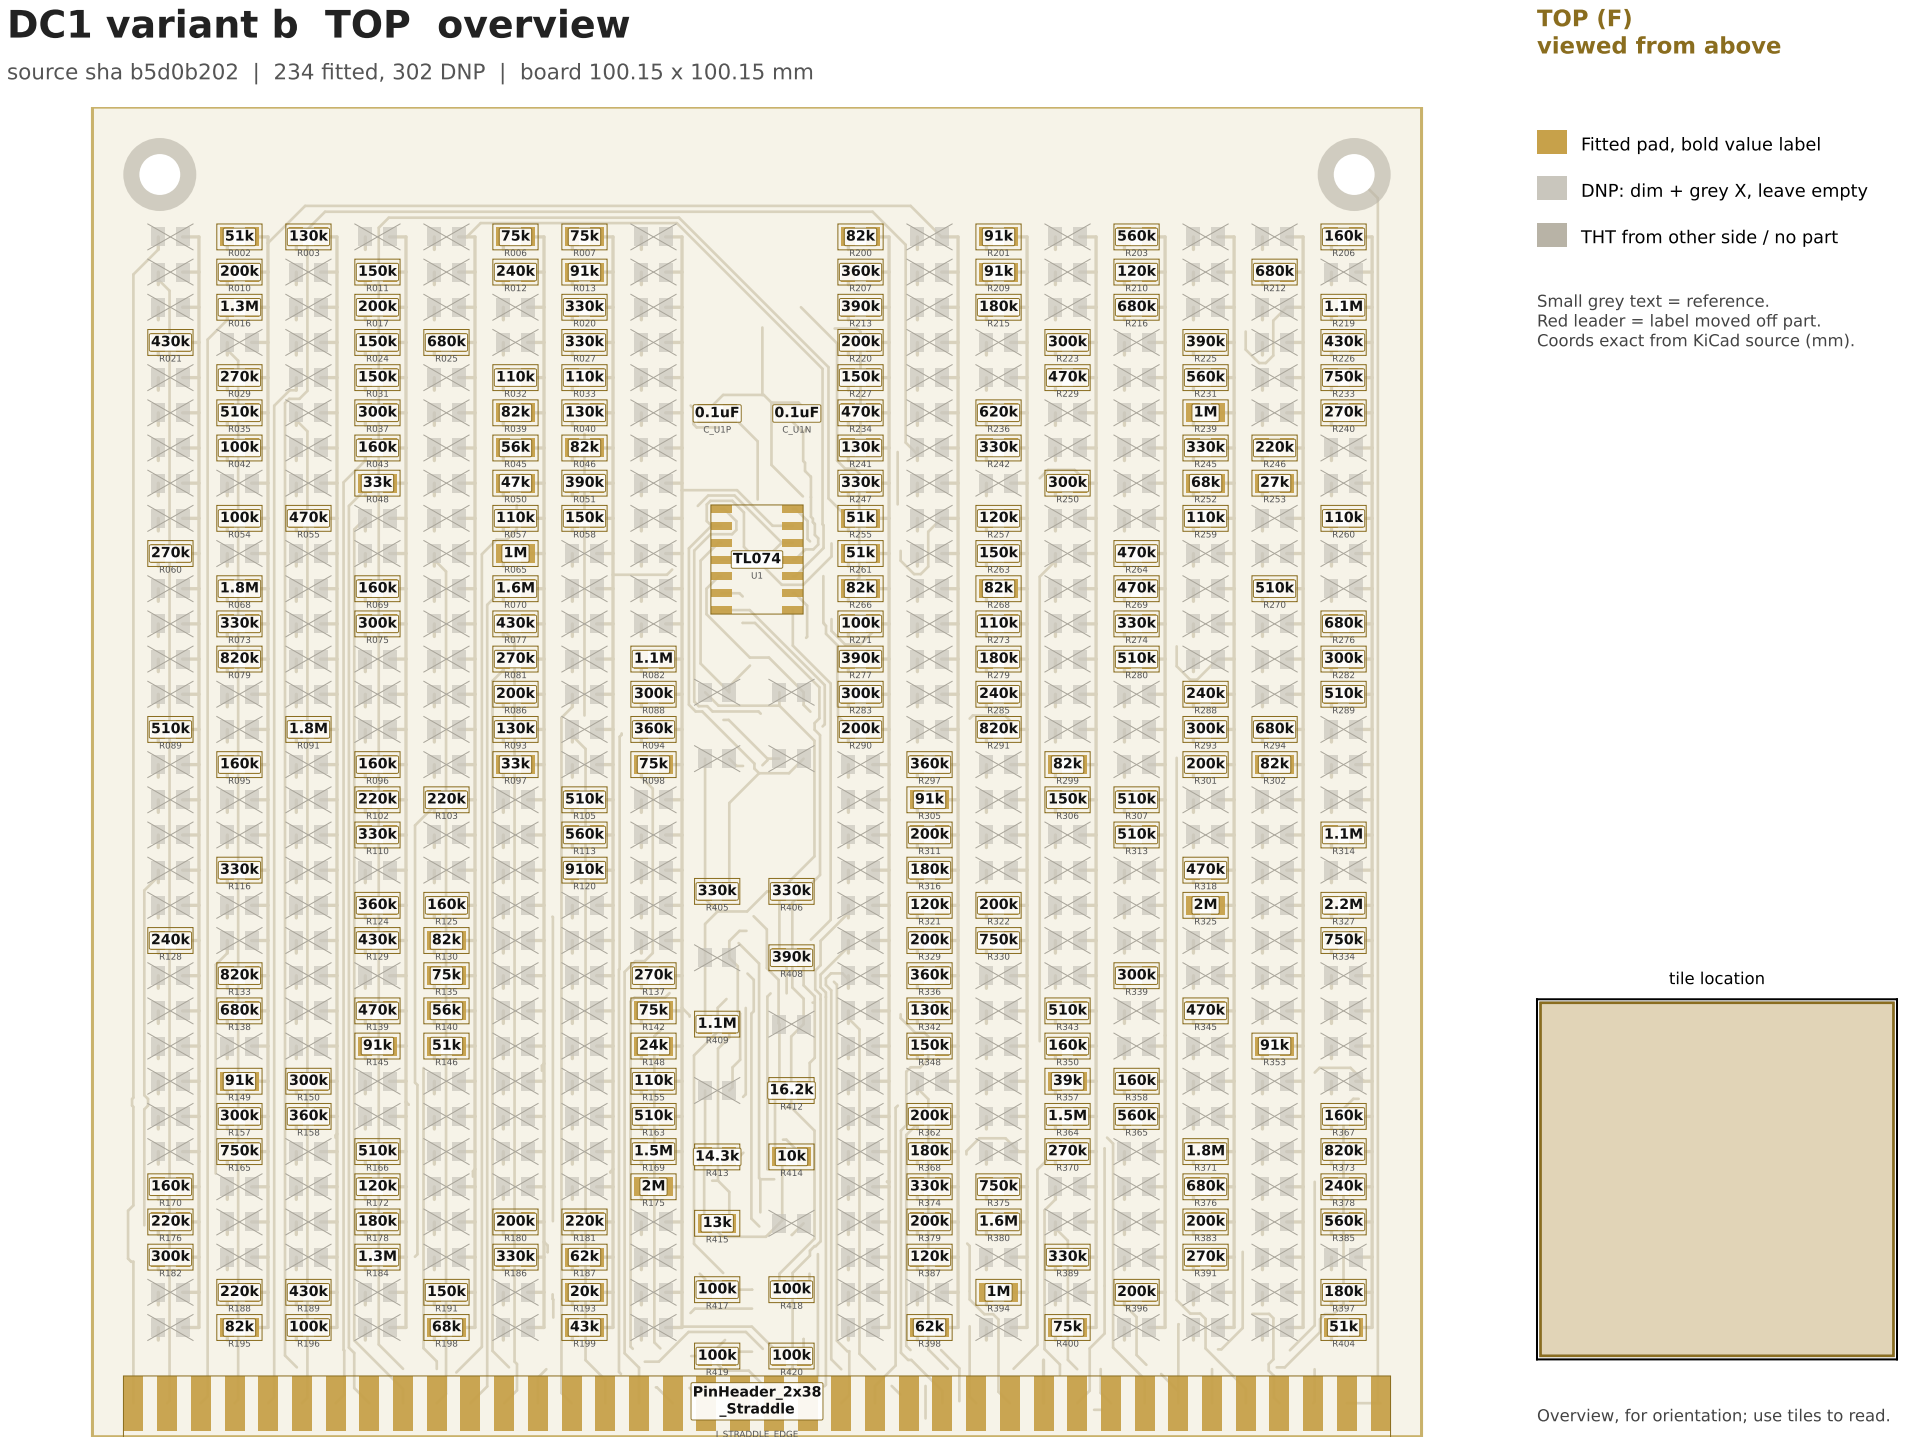
[picture p19: page 4]

Fitted pad, bold value label

DNP: dim + grey X, leave empty

THT from other side / no part

Small grey text = reference.
Red leader = label moved off part.
Coords exact from KiCad source (mm).

# DC1 variant c TOP overview

## source sha b5d0b202 | 185 fitted, 351 DNP | board 100.15 x 100.15 mm

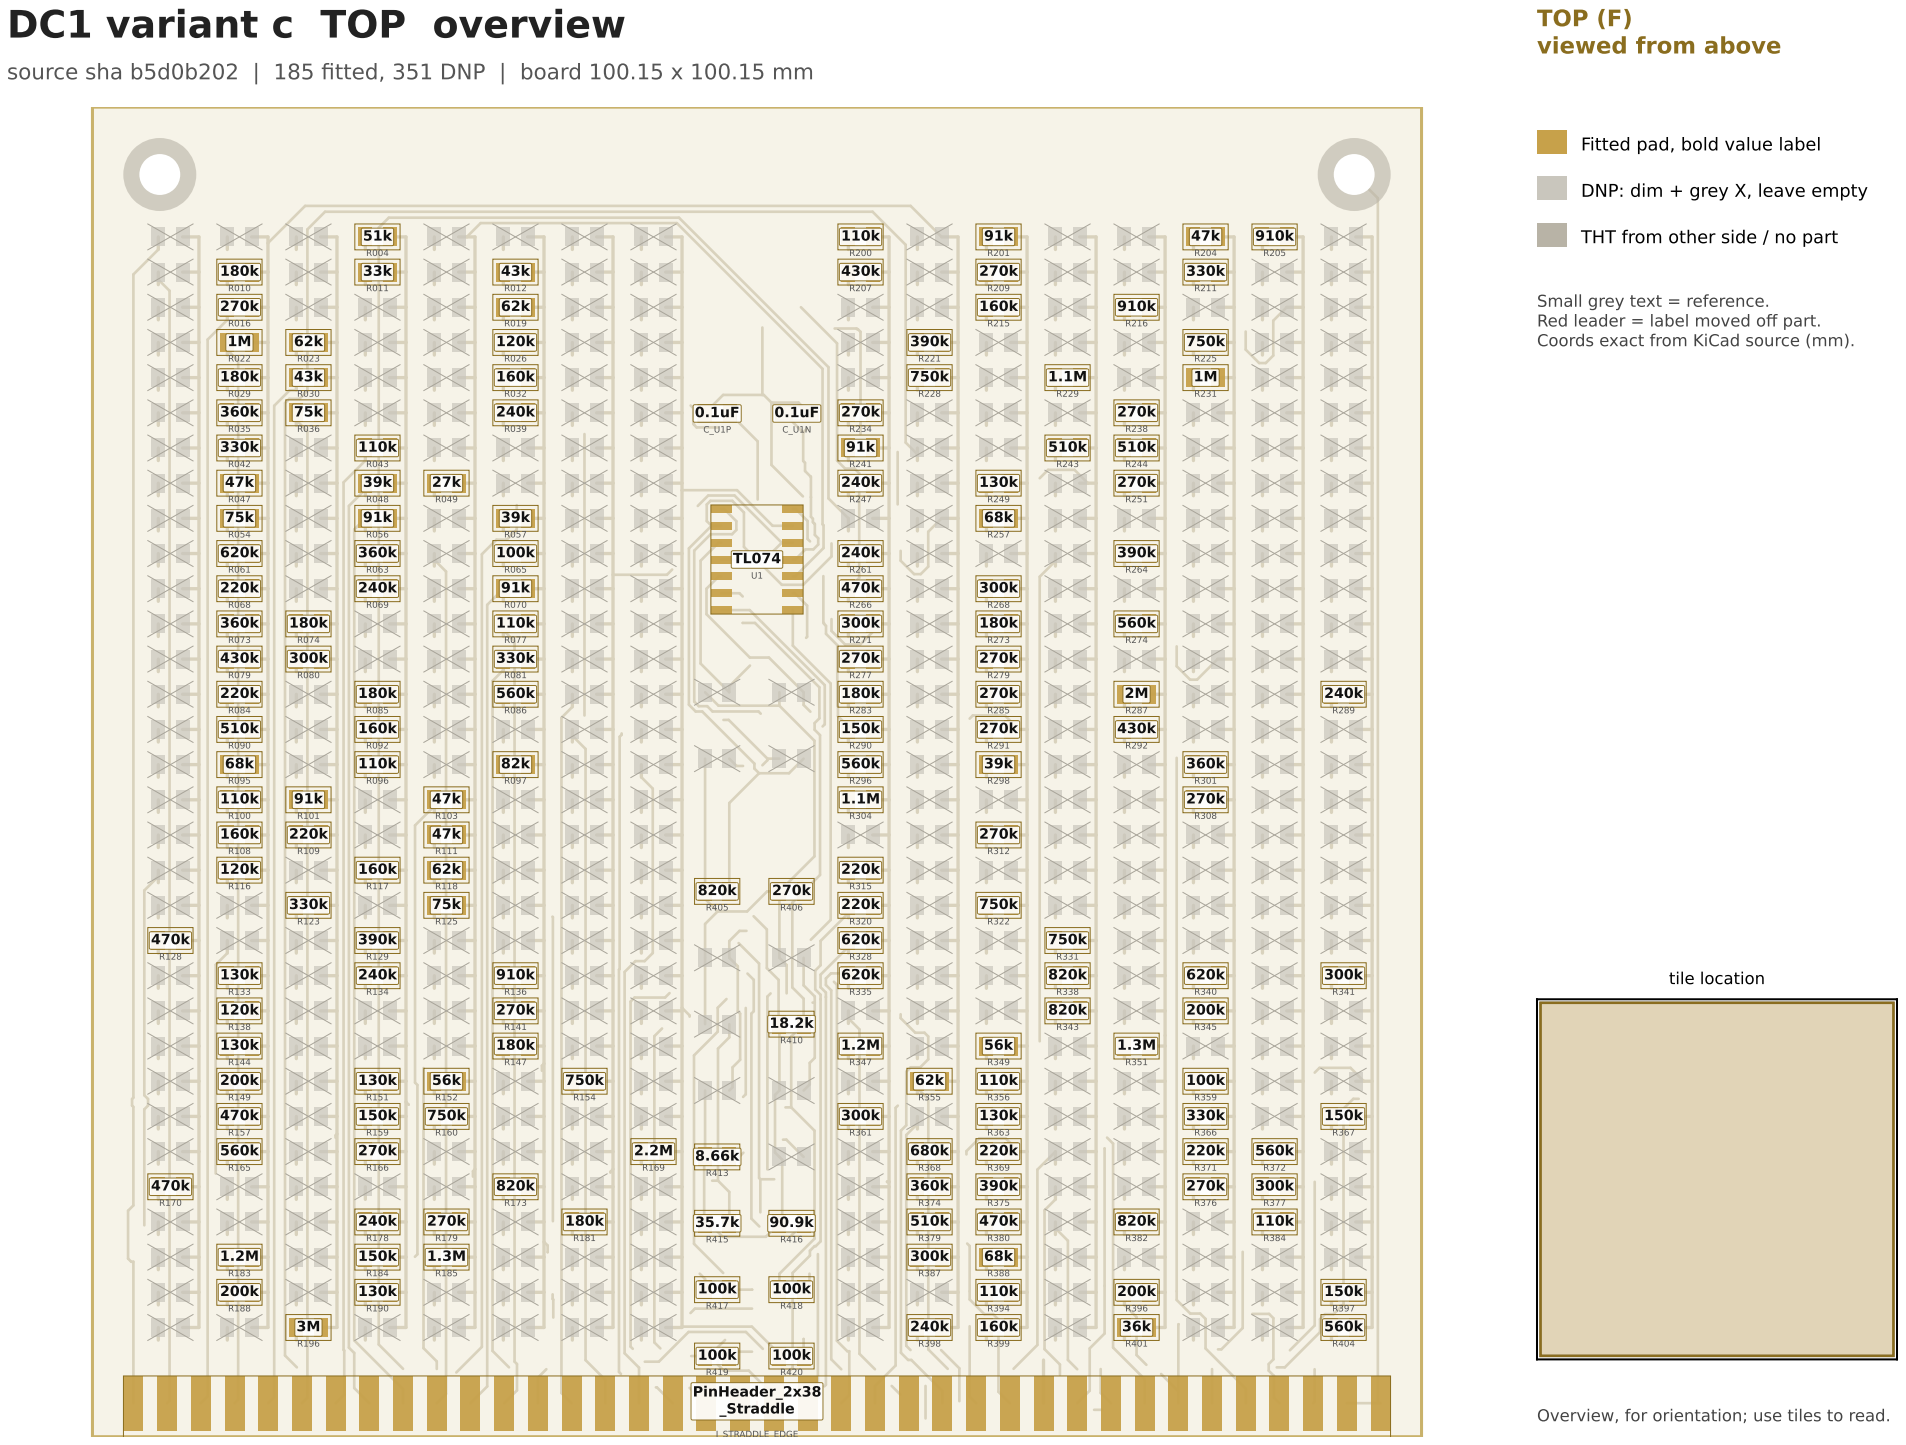
[picture p20: page 5]

Fitted pad, bold value label

DNP: dim + grey X, leave empty

THT from other side / no part

Small grey text = reference.
Red leader = label moved off part.
Coords exact from KiCad source (mm).

# DC1 variant d TOP overview

## source sha b5d0b202 | 145 fitted, 391 DNP | board 100.15 x 100.15 mm

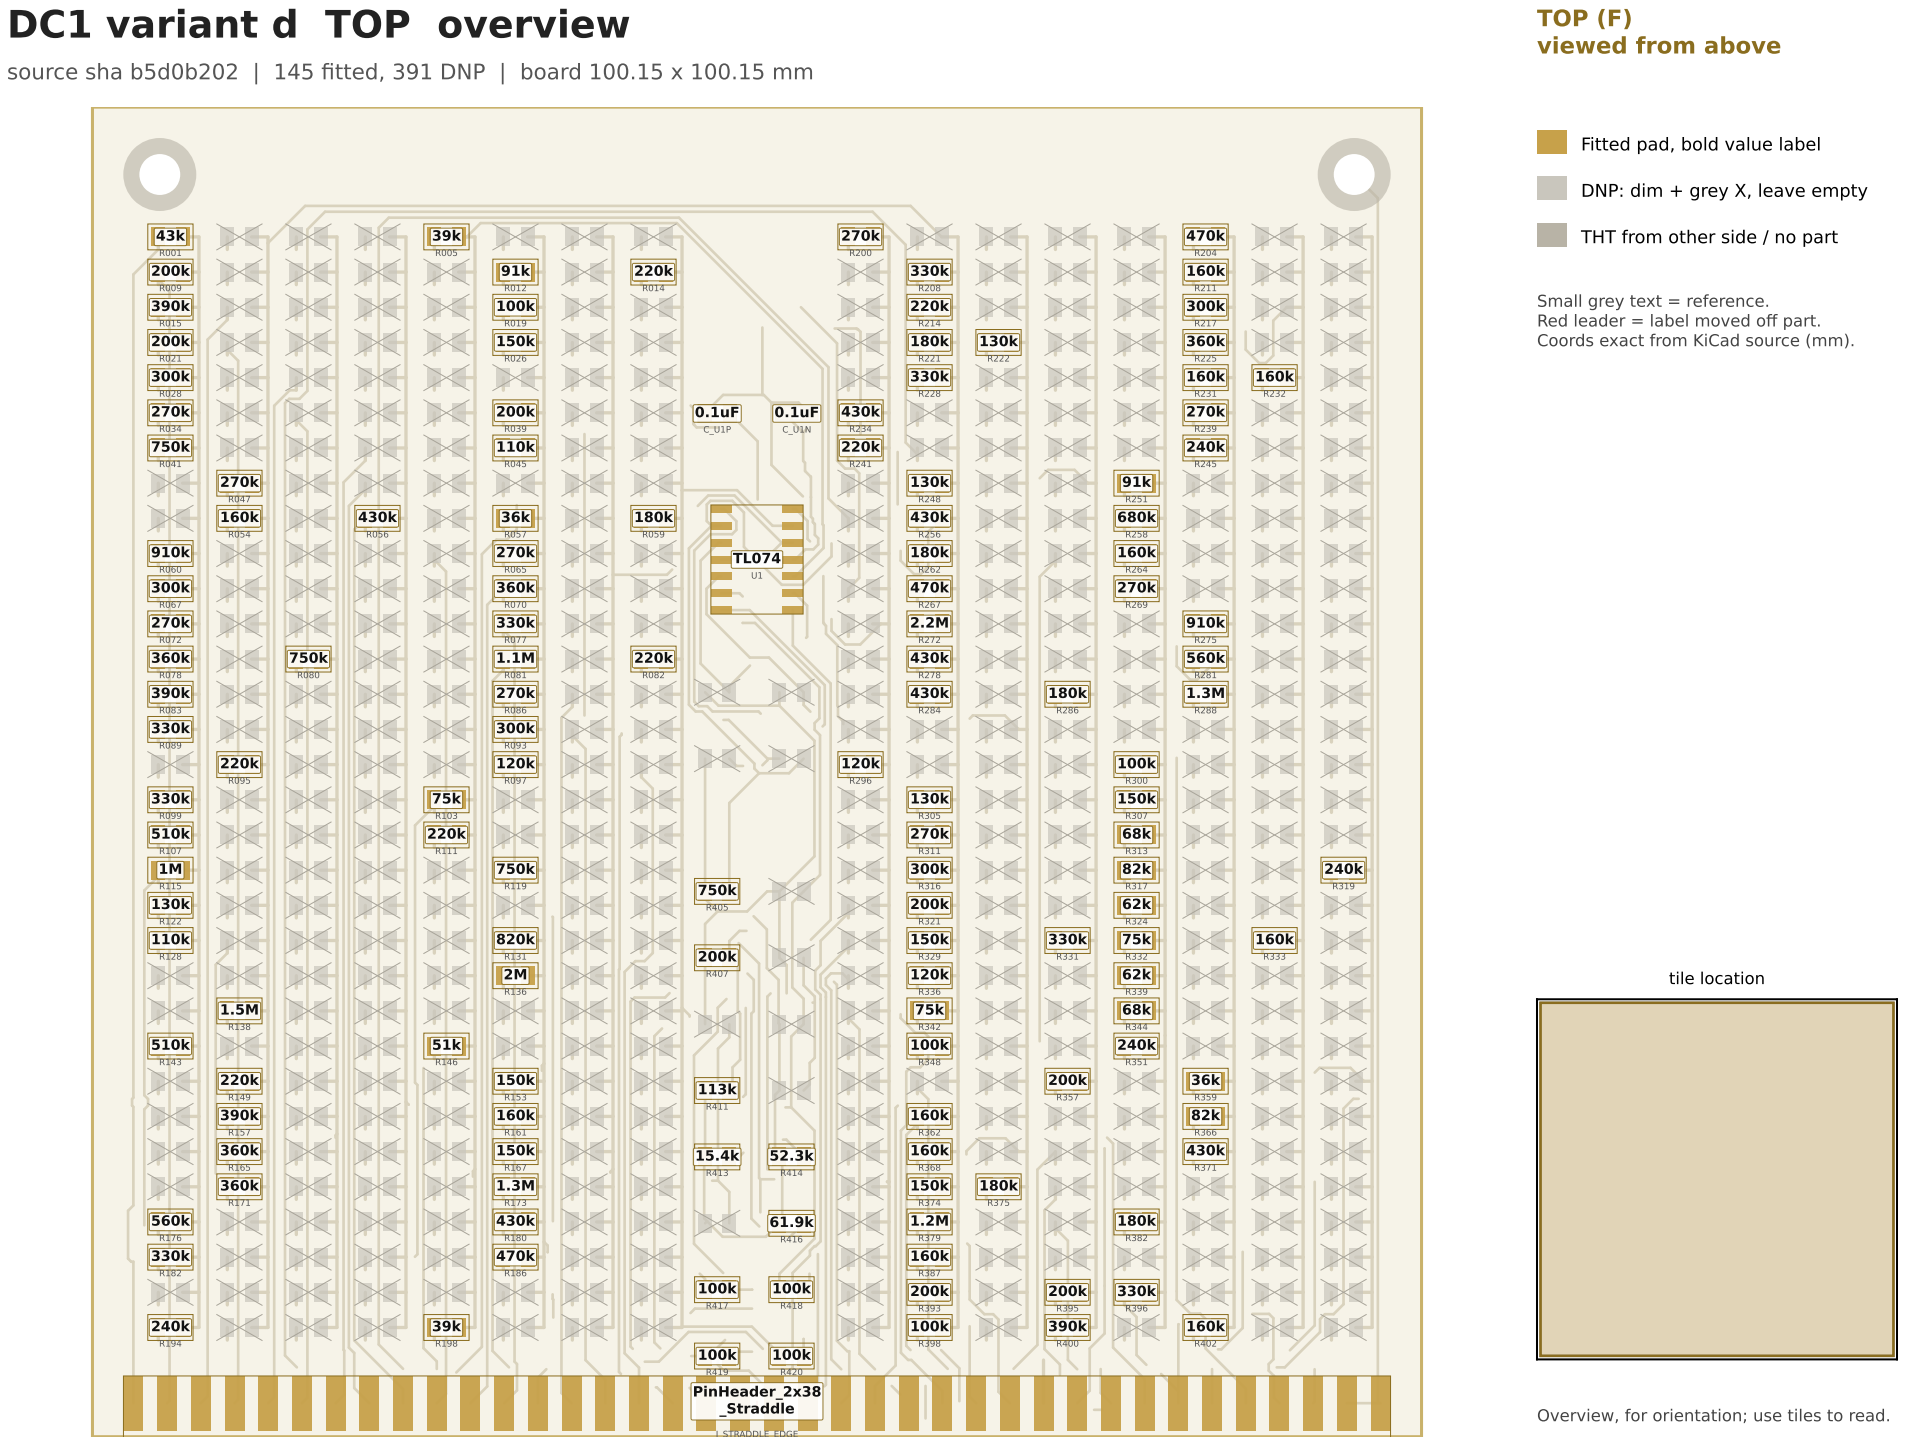
[picture p21: page 6]

Fitted pad, bold value label

DNP: dim + grey X, leave empty

THT from other side / no part

Small grey text = reference.
Red leader = label moved off part.
Coords exact from KiCad source (mm).

# DC2 TOP overview

## source sha 04167d23 | 89 fitted | board 100.15 x 100.15 mm

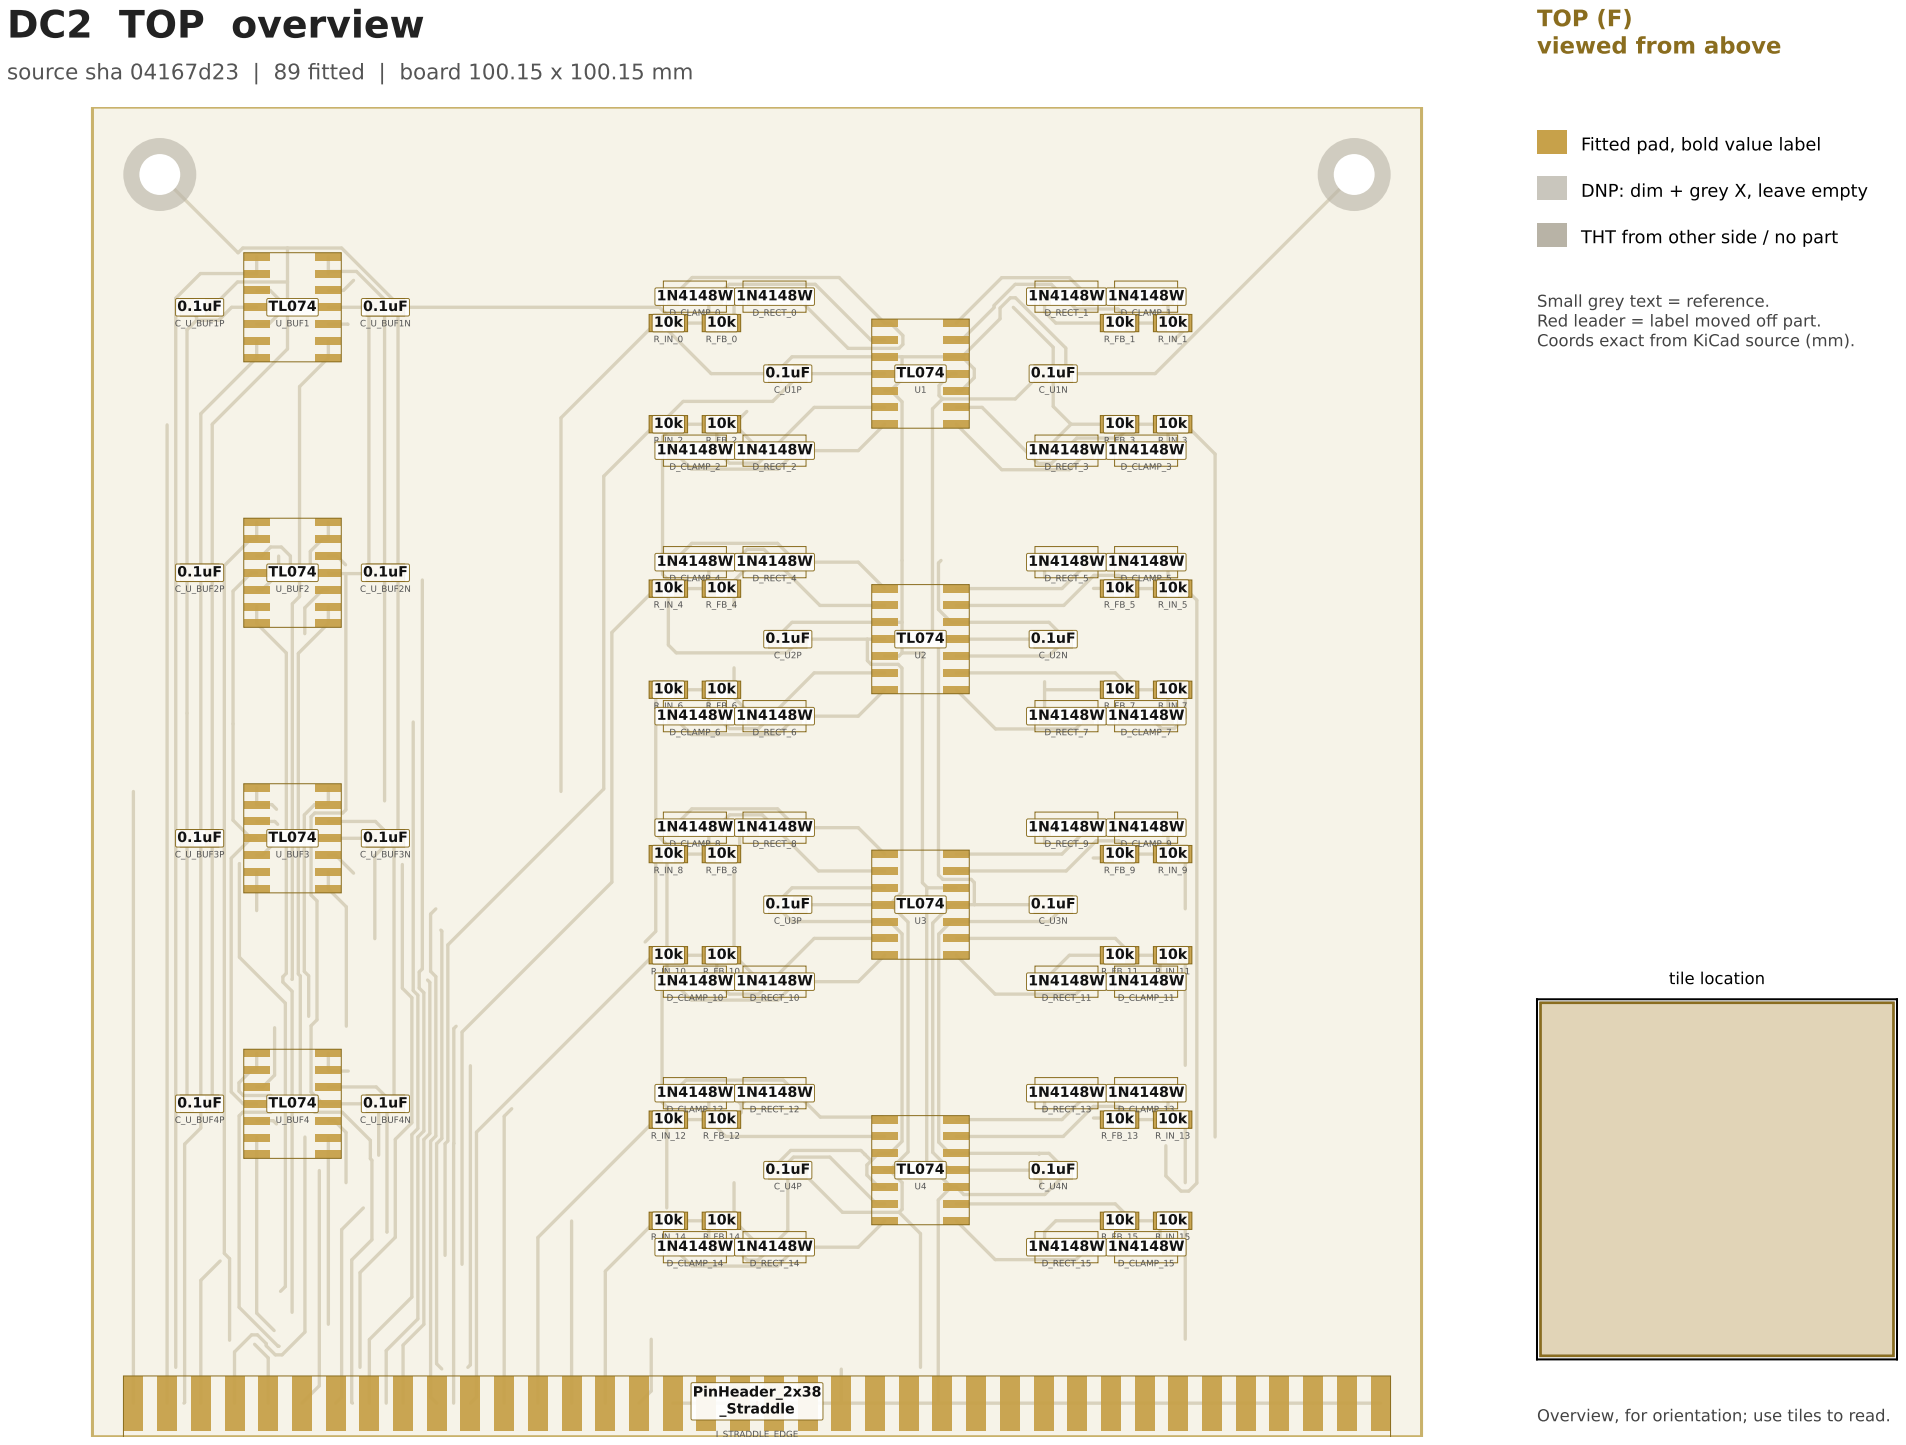
[picture p22: page 7]
C_U_BUF1P; C_U_BUF2P; C_U_BUF3P; C_U_BUF4P; U_BUF1; U_BUF2; U_BUF3; U_BUF4; C_U_BUF1N; C_U_BUF2N; C_U_BUF3N; C_U_BUF4N; D_CLAMP_0; D_CLAMP_2; D_CLAMP_4; D_CLAMP_6; D_CLAMP_8; D_CLAMP_10; D_CLAMP_12; D_CLAMP_14; D_RECT_0; D_RECT_2; D_RECT_4; D_RECT_6; D_RECT_8; D_RECT_10; D_RECT_12; D_RECT_14; D_RECT_1; D_RECT_3; D_RECT_5; D_RECT_7; D_RECT_9; D_RECT_11; D_RECT_13; D_RECT_15; D_CLAMP_1; D_CLAMP_3; D_CLAMP_5; D_CLAMP_7; D_CLAMP_9; D_CLAMP_11; D_CLAMP_13; D_CLAMP_15; tile location

Fitted pad, bold value label

DNP: dim + grey X, leave empty

THT from other side / no part

Small grey text = reference.
Red leader = label moved off part.
Coords exact from KiCad source (mm).

# DC3 v2 TOP overview

## source sha d7c2393f | 163 fitted, 217 DNP | board 100.15 x 100.15 mm

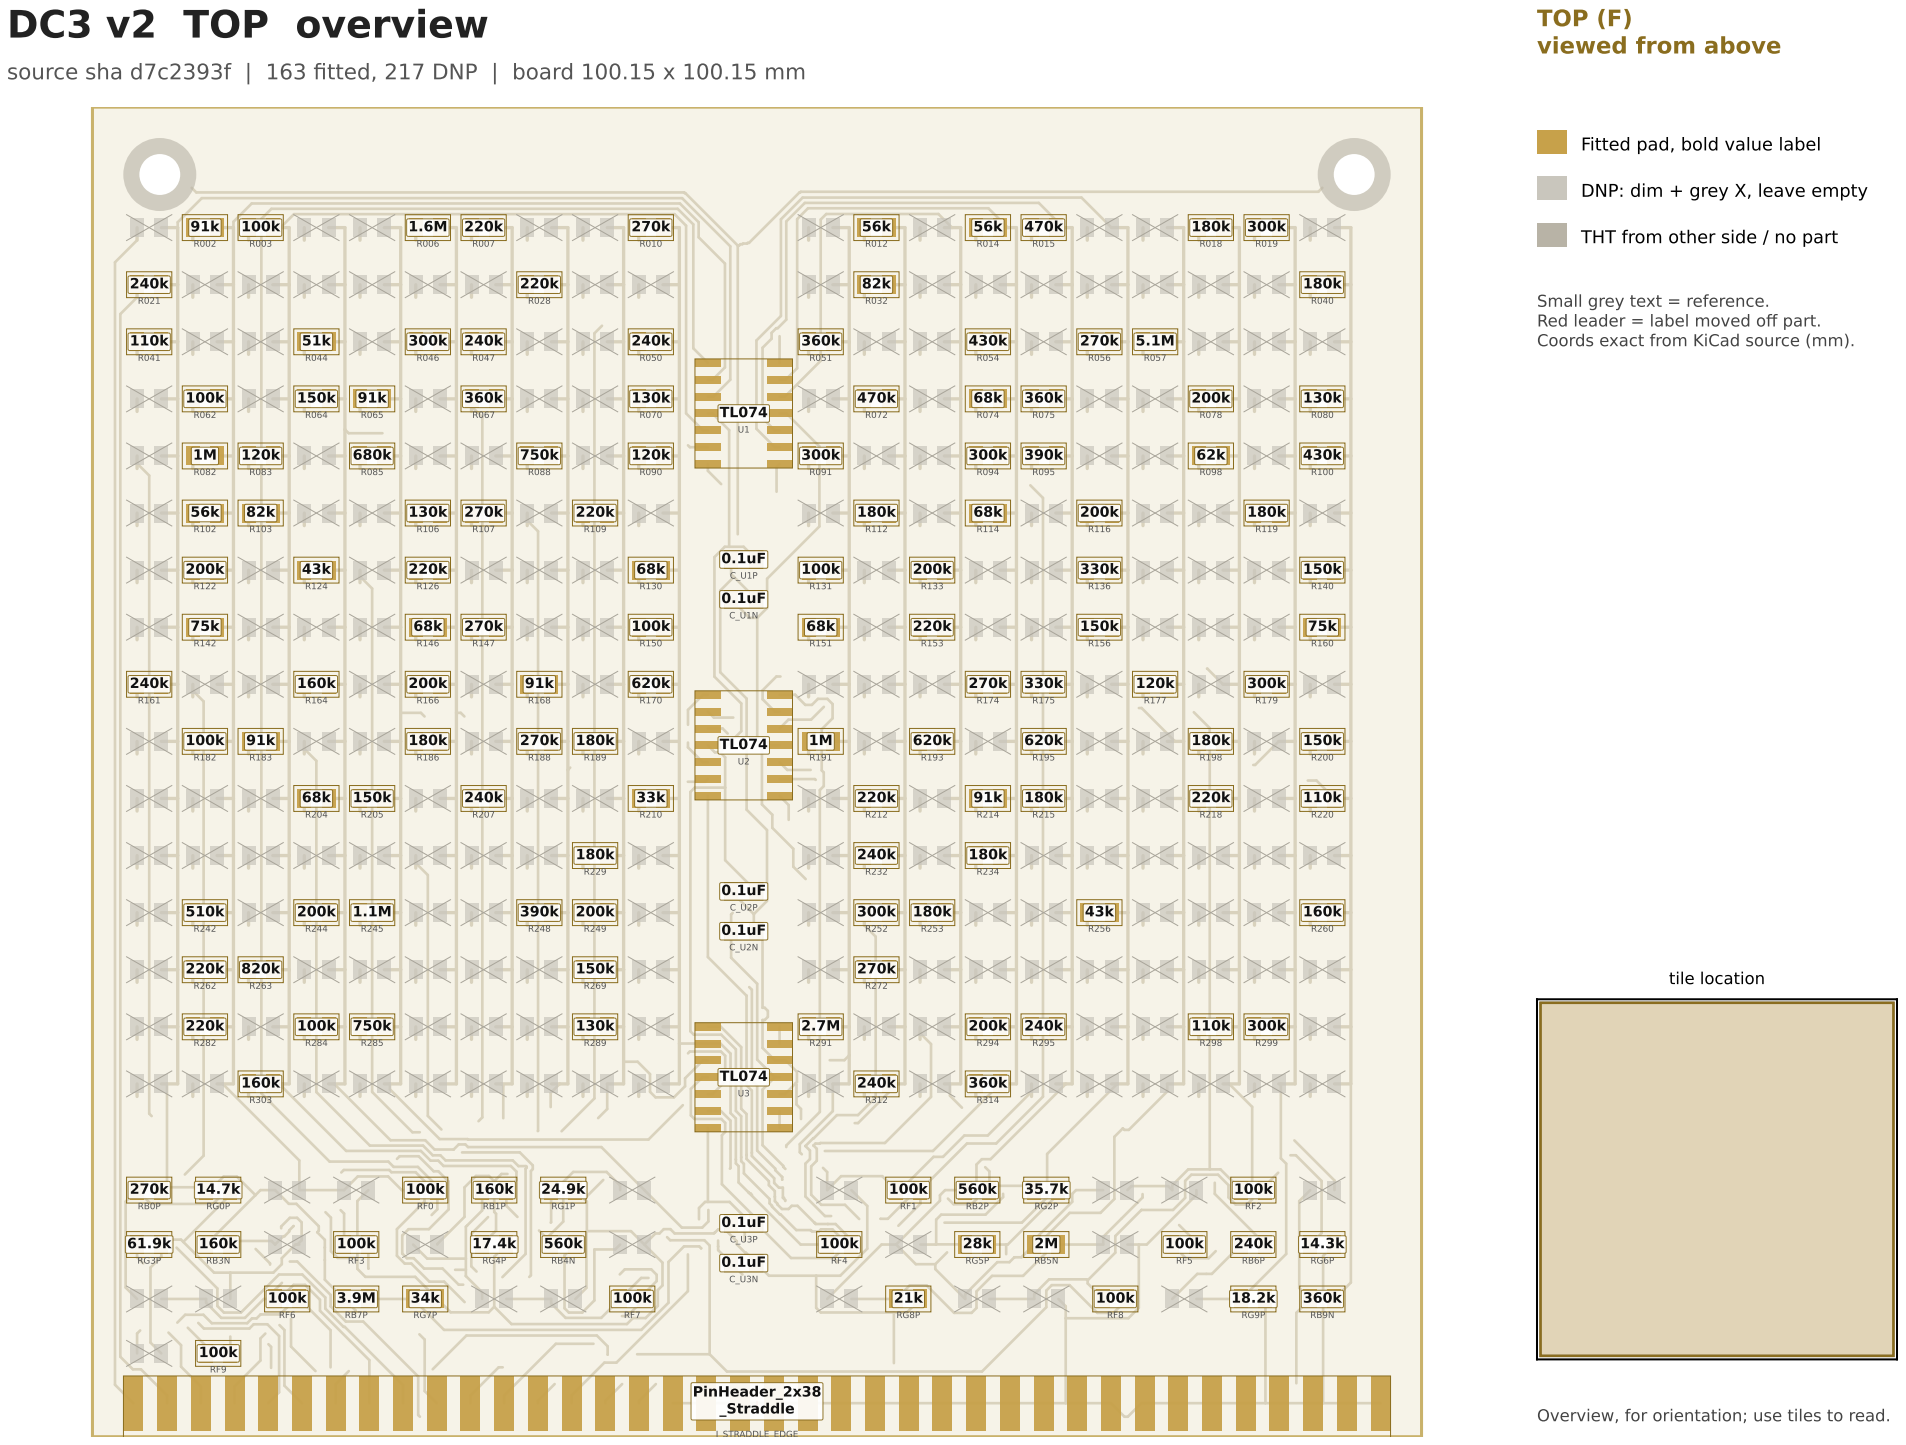
[picture p23: page 8]

Fitted pad, bold value label

DNP: dim + grey X, leave empty

THT from other side / no part

Small grey text = reference.
Red leader = label moved off part.
Coords exact from KiCad source (mm).

# Motherboard v2 TOP overview

## source sha 4932b44c | 81 fitted | board 100.15 x 100.15 mm

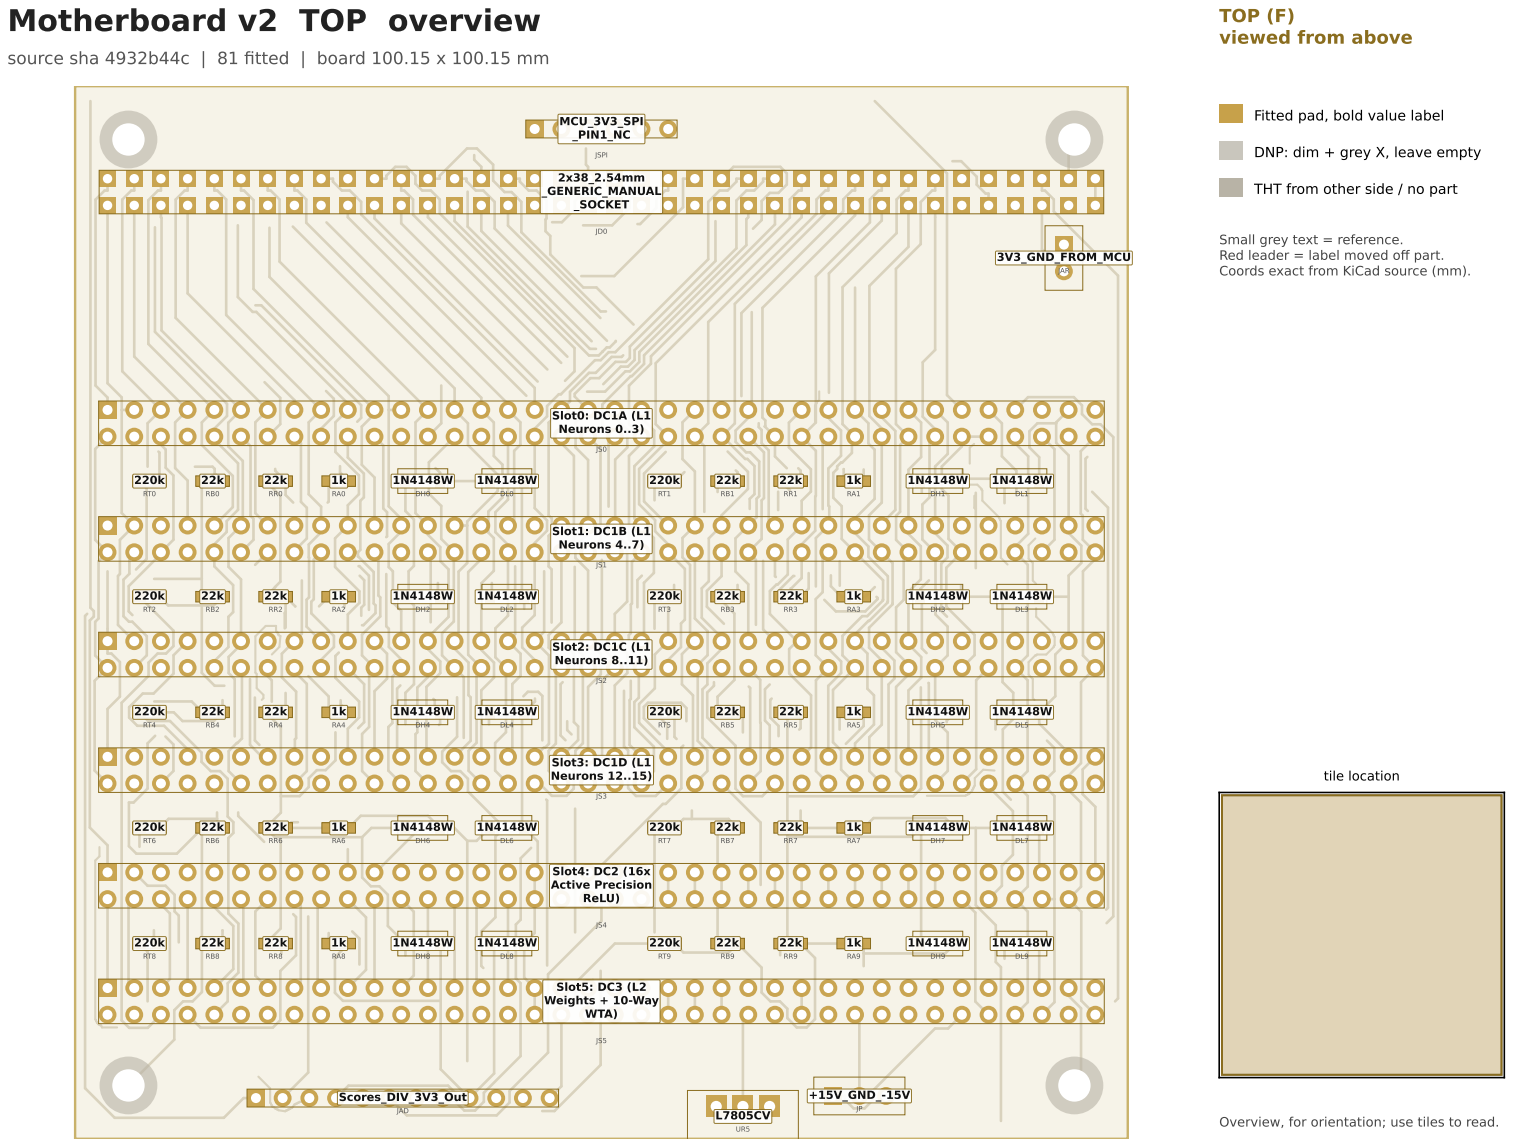
[picture p24: page 9]
JAD; JSPI; JAR; Scores_DIV_3V3_Out; MCU_3V3_SPI _PIN1_NC; 2x38_2.54mm _GENERIC_MANUAL _SOCKET; Slot0: DC1A; Neurons 0..3); Slot1: DC1B; Neurons 4..7); Slot2: DC1C (L1 Neurons 8..11); Slot3: DC1D; Neurons 12..15); Slot4: DC2 (16x Active Precision ReLU); Slot5:; Weights; 10-Way; WTA); +15V_GND_-15V; 3V3_GND_FROM_MCU; tile location

Fitted pad, bold value label

DNP: dim + grey X, leave empty

THT from other side / no part

Small grey text = reference.
Red leader = label moved off part.
Coords exact from KiCad source (mm).

# Motherboard v2 BACK overview

## source sha 4932b44c | 81 fitted | board 100.15 x 100.15 mm

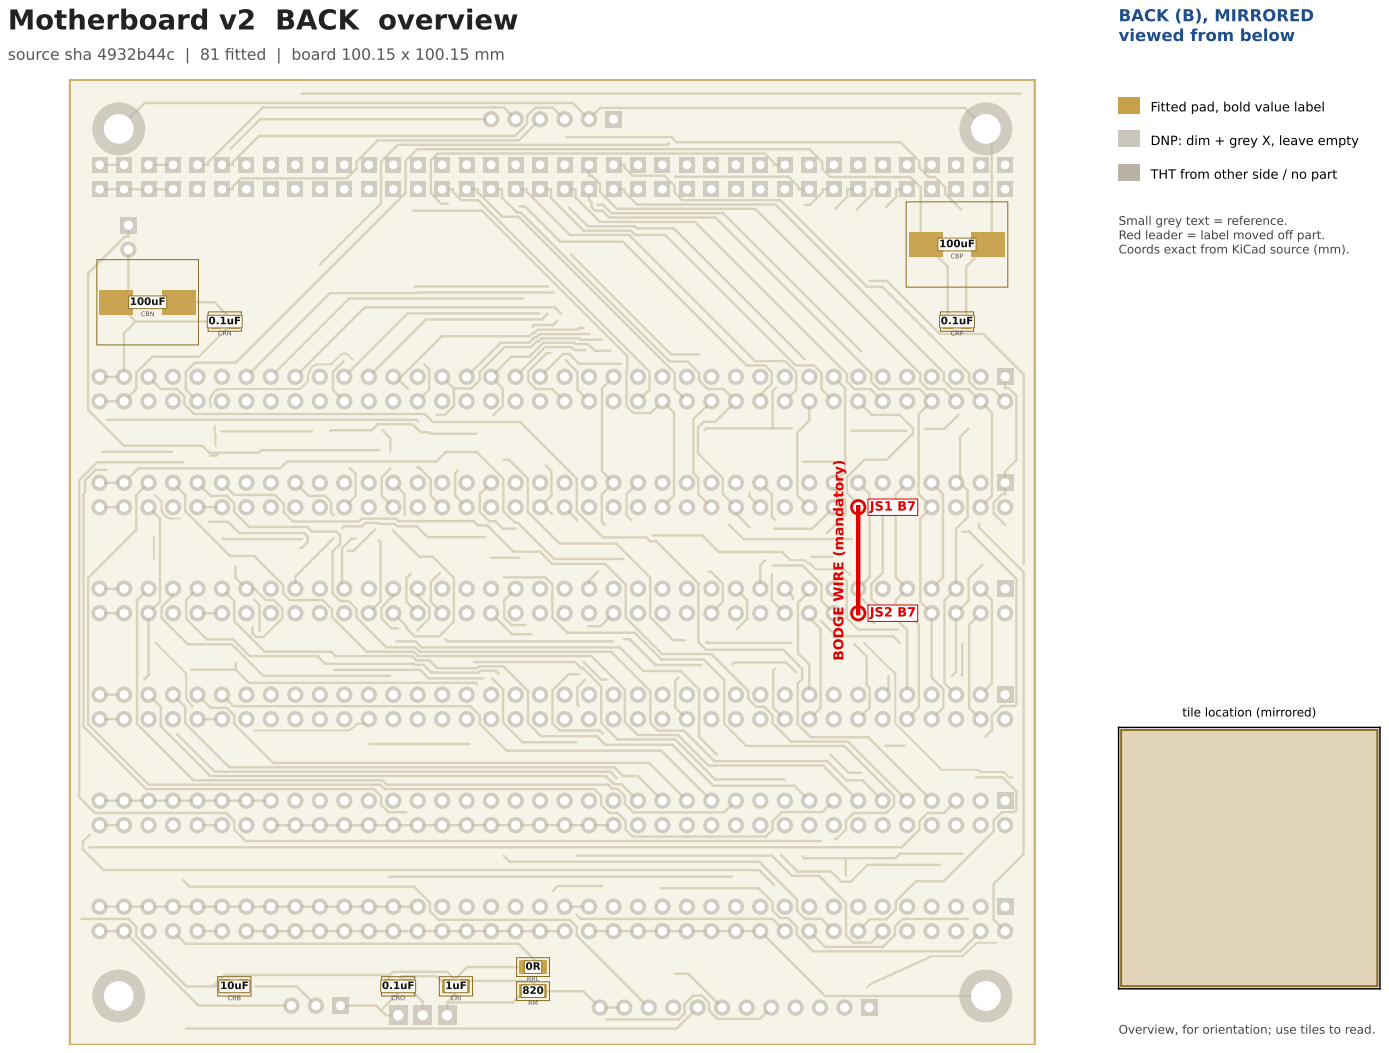
[picture p25: page 10]
CBN; CRN; CRB; CRO; CRI; RRL; CBP; CRP

BACK (B), MIRRORED
viewed from below

Fitted pad, bold value label

DNP: dim + grey X, leave empty

THT from other side / no part

Small grey text = reference.
Red leader = label moved off part.
Coords exact from KiCad source (mm).

BODGE WIRE (mandatory)

tile location (mirrored)
