koboshchan/pcbai/two_layer/dc1_universal/dc1_universal_unrouted.kicad_pcb

## KiCad design two_layer/dc1_universal/dc1_universal_unrouted.kicad_pcb (2026-10-09)

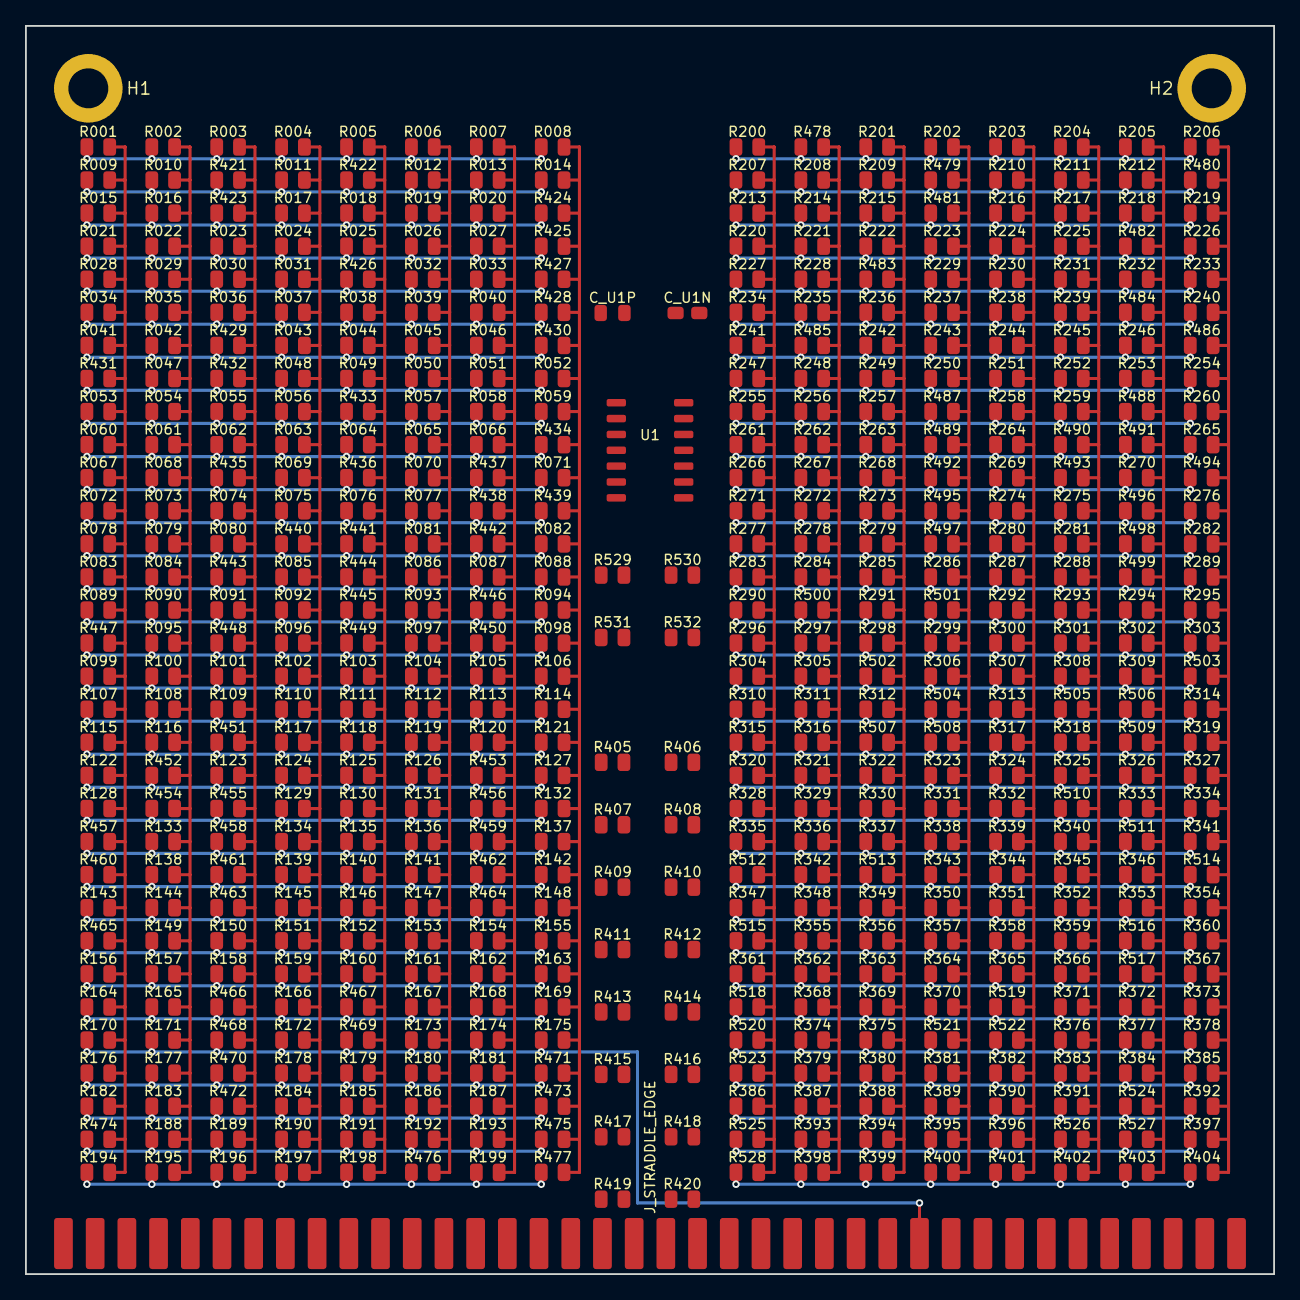
[picture p35: board dc1_universal_unrouted.kicad_pcb from above]

Board: 2 copper layers, 100.0 x 100.0 mm, 538 parts (0 on the bottom side), 80 nets.

Parts:
C_U1N, C_U1P: 0.1uF; C_0805_2012Metric
H1, H2: MountingHole; MountingHole_3.2mm_M3_Pad
J_STRADDLE_EDGE: PinHeader_2x38_Straddle; PinHeader_2x38_Straddle_P2.54mm
R001, R002, R003, R004, R005, R006, R007, R008, R009, R010, R011, R012, R013, R014, R015, R016, R017, R018, R019, R020, R021, R022, R023, R024, R025, R026, R027, R028, R029, R030, R031, R032, R033, R034, R035, R036, R037, R038, R039, R040, R041, R042, R043, R044, R045, R046, R047, R048, R049, R050, R051, R052, R053, R054, R055, R056, R057, R058, R059, R060, R061, R062, R063, R064, R065, R066, R067, R068, R069, R070, R071, R072, R073, R074, R075, R076, R077, R078, R079, R080, R081, R082, R083, R084, R085, R086, R087, R088, R089, R090, R091, R092, R093, R094, R095, R096, R097, R098, R099, R100, R101, R102, R103, R104, R105, R106, R107, R108, R109, R110, R111, R112, R113, R114, R115, R116, R117, R118, R119, R120, R121, R122, R123, R124, R125, R126, R127, R128, R129, R130, R131, R132, R133, R134, R135, R136, R137, R138, R139, R140, R141, R142, R143, R144, R145, R146, R147, R148, R149, R150, R151, R152, R153, R154, R155, R156, R157, R158, R159, R160, R161, R162, R163, R164, R165, R166, R167, R168, R169, R170, R171, R172, R173, R174, R175, R176, R177, R178, R179, R180, R181, R182, R183, R184, R185, R186, R187, R188, R189, R190, R191, R192, R193, R194, R195, R196, R197, R198, R199, R200, R201, R202, R203, R204, R205, R206, R207, R208, R209, R210, R211, R212, R213, R214, R215, R216, R217, R218, R219, R220, R221, R222, R223, R224, R225, R226, R227, R228, R229, R230, R231, R232, R233, R234, R235, R236, R237, R238, R239, R240, R241, R242, R243, R244, R245, R246, R247, R248, R249, R250, R251, R252, R253, R254, R255, R256, R257, R258, R259, R260, R261, R262, R263, R264, R265, R266, R267, R268, R269, R270, R271, R272, R273, R274, R275, R276, R277, R278, R279, R280, R281, R282, R283, R284, R285, R286, R287, R288, R289, R290, R291, R292, R293, R294, R295, R296, R297, R298, R299, R300, R301, R302, R303, R304, R305, R306, R307, R308, R309, R310, R311, R312, R313, R314, R315, R316, R317, R318, R319, R320, R321, R322, R323, R324, R325, R326, R327, R328, R329, R330, R331, R332, R333, R334, R335, R336, R337, R338, R339, R340, R341, R342, R343, R344, R345, R346, R347, R348, R349, R350, R351, R352, R353, R354, R355, R356, R357, R358, R359, R360, R361, R362, R363, R364, R365, R366, R367, R368, R369, R370, R371, R372, R373, R374, R375, R376, R377, R378, R379, R380, R381, R382, R383, R384, R385, R386, R387, R388, R389, R390, R391, R392, R393, R394, R395, R396, R397, R398, R399, R400, R401, R402, R403, R404, R405, R406, R407, R408, R409, R410, R411, R412, R413, R414, R415, R416, R417, R418, R419, R420, R421, R422, R423, R424, R425, R426, R427, R428, R429, R430, R431, R432, R433, R434, R435, R436, R437, R438, R439, R440, R441, R442, R443, R444, R445, R446, R447, R448, R449, R450, R451, R452, R453, R454, R455, R456, R457, R458, R459, R460, R461, R462, R463, R464, R465, R466, R467, R468, R469, R470, R471, R472, R473, R474, R475, R476, R477, R478, R479, R480, R481, R482, R483, R484, R485, R486, R487, R488, R489, R490, R491, R492, R493, R494, R495, R496, R497, R498, R499, R500, R501, R502, R503, R504, R505, R506, R507, R508, R509, R510, R511, R512, R513, R514, R515, R516, R517, R518, R519, R520, R521, R522, R523, R524, R525, R526, R527, R528, R529, R530, R531, R532: POPULATION; R_0805_2012Metric
U1: TL074; SOIC-14_3.9x8.7mm_P1.27mm

Connections:
+5V_REF: J_STRADDLE_EDGE.B35, R405.1, R406.1, R407.1, R408.1, R409.1, R529.1, R530.1, R531.1
+15V: C_U1P.2, J_STRADDLE_EDGE.B33, J_STRADDLE_EDGE.B34, U1.4
-15V: C_U1N.1, J_STRADDLE_EDGE.B37, J_STRADDLE_EDGE.B38, U1.11
GND: C_U1N.2, C_U1P.1, H1.1, H2.1, J_STRADDLE_EDGE.A37, J_STRADDLE_EDGE.A38, R410.1, R411.1, R412.1, R413.1, R414.1, R415.1, R416.1, R532.1
INV_N0: R002.2, R010.2, R016.2, R022.2, R029.2, R035.2, R042.2, R047.2, R054.2, R061.2, R068.2, R073.2, R079.2, R084.2, R090.2, R095.2, R100.2, R108.2, R116.2, R133.2, R138.2, R144.2, R149.2, R157.2, R165.2, R171.2, R177.2, R183.2, R188.2, R195.2, R208.2, R214.2, R221.2, R228.2, R235.2, R248.2, R256.2, R262.2, R267.2, R272.2, R278.2, R284.2, R297.2, R305.2, R311.2, R316.2, R321.2, R329.2, R336.2, R342.2, R348.2, R355.2, R362.2, R368.2, R374.2, R379.2, R387.2, R393.2, R398.2, R405.2, R417.1, R452.2, R454.2, R478.2, R485.2, R500.2, R532.2, U1.2
INV_N1: R004.2, R011.2, R017.2, R024.2, R031.2, R037.2, R043.2, R048.2, R056.2, R063.2, R069.2, R075.2, R085.2, R092.2, R096.2, R102.2, R110.2, R117.2, R124.2, R129.2, R134.2, R139.2, R145.2, R151.2, R159.2, R166.2, R172.2, R178.2, R184.2, R190.2, R197.2, R202.2, R223.2, R229.2, R237.2, R243.2, R250.2, R286.2, R299.2, R306.2, R323.2, R331.2, R338.2, R343.2, R350.2, R357.2, R364.2, R370.2, R381.2, R389.2, R395.2, R400.2, R406.2, R410.2, R418.1, R440.2, R479.2, R481.2, R487.2, R489.2, R492.2, R495.2, R497.2, R501.2, R504.2, R508.2, R521.2, U1.6
INV_N2: R006.2, R012.2, R019.2, R026.2, R032.2, R039.2, R045.2, R050.2, R057.2, R065.2, R070.2, R077.2, R081.2, R086.2, R093.2, R097.2, R104.2, R112.2, R119.2, R126.2, R131.2, R136.2, R141.2, R147.2, R153.2, R161.2, R167.2, R173.2, R180.2, R186.2, R192.2, R204.2, R211.2, R217.2, R225.2, R231.2, R239.2, R245.2, R252.2, R259.2, R275.2, R281.2, R288.2, R293.2, R301.2, R308.2, R318.2, R325.2, R340.2, R345.2, R352.2, R359.2, R366.2, R371.2, R376.2, R383.2, R391.2, R402.2, R407.2, R411.2, R419.1, R476.2, R490.2, R493.2, R505.2, R510.2, R526.2, U1.9
INV_N3: R008.2, R014.2, R052.2, R059.2, R071.2, R082.2, R088.2, R094.2, R098.2, R106.2, R114.2, R121.2, R127.2, R132.2, R137.2, R142.2, R148.2, R155.2, R163.2, R169.2, R175.2, R206.2, R219.2, R226.2, R233.2, R240.2, R254.2, R260.2, R265.2, R276.2, R282.2, R289.2, R295.2, R303.2, R314.2, R319.2, R327.2, R334.2, R341.2, R354.2, R360.2, R367.2, R373.2, R378.2, R385.2, R392.2, R397.2, R404.2, R408.2, R412.2, R420.1, R424.2, R425.2, R427.2, R428.2, R430.2, R434.2, R439.2, R471.2, R473.2, R475.2, R477.2, R480.2, R486.2, R494.2, R503.2, R514.2, U1.13
IN_0: J_STRADDLE_EDGE.A1, R001.1, R002.1, R003.1, R004.1, R005.1, R006.1, R007.1, R008.1
IN_1: J_STRADDLE_EDGE.A2, R009.1, R010.1, R011.1, R012.1, R013.1, R014.1, R421.1, R422.1
IN_2: J_STRADDLE_EDGE.A3, R015.1, R016.1, R017.1, R018.1, R019.1, R020.1, R423.1, R424.1
IN_3: J_STRADDLE_EDGE.A4, R021.1, R022.1, R023.1, R024.1, R025.1, R026.1, R027.1, R425.1
IN_4: J_STRADDLE_EDGE.A5, R028.1, R029.1, R030.1, R031.1, R032.1, R033.1, R426.1, R427.1
IN_5: J_STRADDLE_EDGE.A6, R034.1, R035.1, R036.1, R037.1, R038.1, R039.1, R040.1, R428.1
IN_6: J_STRADDLE_EDGE.A7, R041.1, R042.1, R043.1, R044.1, R045.1, R046.1, R429.1, R430.1
IN_7: J_STRADDLE_EDGE.A8, R047.1, R048.1, R049.1, R050.1, R051.1, R052.1, R431.1, R432.1
IN_8: J_STRADDLE_EDGE.A9, R053.1, R054.1, R055.1, R056.1, R057.1, R058.1, R059.1, R433.1
IN_9: J_STRADDLE_EDGE.A10, R060.1, R061.1, R062.1, R063.1, R064.1, R065.1, R066.1, R434.1
IN_10: J_STRADDLE_EDGE.A11, R067.1, R068.1, R069.1, R070.1, R071.1, R435.1, R436.1, R437.1
IN_11: J_STRADDLE_EDGE.A12, R072.1, R073.1, R074.1, R075.1, R076.1, R077.1, R438.1, R439.1
IN_12: J_STRADDLE_EDGE.A13, R078.1, R079.1, R080.1, R081.1, R082.1, R440.1, R441.1, R442.1
IN_13: J_STRADDLE_EDGE.A14, R083.1, R084.1, R085.1, R086.1, R087.1, R088.1, R443.1, R444.1
IN_14: J_STRADDLE_EDGE.A15, R089.1, R090.1, R091.1, R092.1, R093.1, R094.1, R445.1, R446.1
IN_15: J_STRADDLE_EDGE.A16, R095.1, R096.1, R097.1, R098.1, R447.1, R448.1, R449.1, R450.1
IN_16: J_STRADDLE_EDGE.A17, R099.1, R100.1, R101.1, R102.1, R103.1, R104.1, R105.1, R106.1
IN_17: J_STRADDLE_EDGE.A18, R107.1, R108.1, R109.1, R110.1, R111.1, R112.1, R113.1, R114.1
IN_18: J_STRADDLE_EDGE.A19, R115.1, R116.1, R117.1, R118.1, R119.1, R120.1, R121.1, R451.1
IN_19: J_STRADDLE_EDGE.A20, R122.1, R123.1, R124.1, R125.1, R126.1, R127.1, R452.1, R453.1
IN_20: J_STRADDLE_EDGE.A21, R128.1, R129.1, R130.1, R131.1, R132.1, R454.1, R455.1, R456.1
IN_21: J_STRADDLE_EDGE.A22, R133.1, R134.1, R135.1, R136.1, R137.1, R457.1, R458.1, R459.1
IN_22: J_STRADDLE_EDGE.A23, R138.1, R139.1, R140.1, R141.1, R142.1, R460.1, R461.1, R462.1
IN_23: J_STRADDLE_EDGE.A24, R143.1, R144.1, R145.1, R146.1, R147.1, R148.1, R463.1, R464.1
IN_24: J_STRADDLE_EDGE.A25, R149.1, R150.1, R151.1, R152.1, R153.1, R154.1, R155.1, R465.1
IN_25: J_STRADDLE_EDGE.A26, R156.1, R157.1, R158.1, R159.1, R160.1, R161.1, R162.1, R163.1
IN_26: J_STRADDLE_EDGE.A27, R164.1, R165.1, R166.1, R167.1, R168.1, R169.1, R466.1, R467.1
IN_27: J_STRADDLE_EDGE.A28, R170.1, R171.1, R172.1, R173.1, R174.1, R175.1, R468.1, R469.1
IN_28: J_STRADDLE_EDGE.A29, R176.1, R177.1, R178.1, R179.1, R180.1, R181.1, R470.1, R471.1
IN_29: J_STRADDLE_EDGE.A30, R182.1, R183.1, R184.1, R185.1, R186.1, R187.1, R472.1, R473.1
IN_30: J_STRADDLE_EDGE.A31, R188.1, R189.1, R190.1, R191.1, R192.1, R193.1, R474.1, R475.1
IN_31: J_STRADDLE_EDGE.A32, R194.1, R195.1, R196.1, R197.1, R198.1, R199.1, R476.1, R477.1
IN_32: J_STRADDLE_EDGE.B1, R200.1, R201.1, R202.1, R203.1, R204.1, R205.1, R206.1, R478.1
IN_33: J_STRADDLE_EDGE.B2, R207.1, R208.1, R209.1, R210.1, R211.1, R212.1, R479.1, R480.1
IN_34: J_STRADDLE_EDGE.B3, R213.1, R214.1, R215.1, R216.1, R217.1, R218.1, R219.1, R481.1
IN_35: J_STRADDLE_EDGE.B4, R220.1, R221.1, R222.1, R223.1, R224.1, R225.1, R226.1, R482.1
IN_36: J_STRADDLE_EDGE.B5, R227.1, R228.1, R229.1, R230.1, R231.1, R232.1, R233.1, R483.1
IN_37: J_STRADDLE_EDGE.B6, R234.1, R235.1, R236.1, R237.1, R238.1, R239.1, R240.1, R484.1
IN_38: J_STRADDLE_EDGE.B7, R241.1, R242.1, R243.1, R244.1, R245.1, R246.1, R485.1, R486.1
IN_39: J_STRADDLE_EDGE.B8, R247.1, R248.1, R249.1, R250.1, R251.1, R252.1, R253.1, R254.1
IN_40: J_STRADDLE_EDGE.B9, R255.1, R256.1, R257.1, R258.1, R259.1, R260.1, R487.1, R488.1
IN_41: J_STRADDLE_EDGE.B10, R261.1, R262.1, R263.1, R264.1, R265.1, R489.1, R490.1, R491.1
IN_42: J_STRADDLE_EDGE.B11, R266.1, R267.1, R268.1, R269.1, R270.1, R492.1, R493.1, R494.1
IN_43: J_STRADDLE_EDGE.B12, R271.1, R272.1, R273.1, R274.1, R275.1, R276.1, R495.1, R496.1
IN_44: J_STRADDLE_EDGE.B13, R277.1, R278.1, R279.1, R280.1, R281.1, R282.1, R497.1, R498.1
IN_45: J_STRADDLE_EDGE.B14, R283.1, R284.1, R285.1, R286.1, R287.1, R288.1, R289.1, R499.1
IN_46: J_STRADDLE_EDGE.B15, R290.1, R291.1, R292.1, R293.1, R294.1, R295.1, R500.1, R501.1
IN_47: J_STRADDLE_EDGE.B16, R296.1, R297.1, R298.1, R299.1, R300.1, R301.1, R302.1, R303.1
IN_48: J_STRADDLE_EDGE.B17, R304.1, R305.1, R306.1, R307.1, R308.1, R309.1, R502.1, R503.1
IN_49: J_STRADDLE_EDGE.B18, R310.1, R311.1, R312.1, R313.1, R314.1, R504.1, R505.1, R506.1
IN_50: J_STRADDLE_EDGE.B19, R315.1, R316.1, R317.1, R318.1, R319.1, R507.1, R508.1, R509.1
IN_51: J_STRADDLE_EDGE.B20, R320.1, R321.1, R322.1, R323.1, R324.1, R325.1, R326.1, R327.1
IN_52: J_STRADDLE_EDGE.B21, R328.1, R329.1, R330.1, R331.1, R332.1, R333.1, R334.1, R510.1
IN_53: J_STRADDLE_EDGE.B22, R335.1, R336.1, R337.1, R338.1, R339.1, R340.1, R341.1, R511.1
IN_54: J_STRADDLE_EDGE.B23, R342.1, R343.1, R344.1, R345.1, R346.1, R512.1, R513.1, R514.1
IN_55: J_STRADDLE_EDGE.B24, R347.1, R348.1, R349.1, R350.1, R351.1, R352.1, R353.1, R354.1
IN_56: J_STRADDLE_EDGE.B25, R355.1, R356.1, R357.1, R358.1, R359.1, R360.1, R515.1, R516.1
IN_57: J_STRADDLE_EDGE.B26, R361.1, R362.1, R363.1, R364.1, R365.1, R366.1, R367.1, R517.1
IN_58: J_STRADDLE_EDGE.B27, R368.1, R369.1, R370.1, R371.1, R372.1, R373.1, R518.1, R519.1
IN_59: J_STRADDLE_EDGE.B28, R374.1, R375.1, R376.1, R377.1, R378.1, R520.1, R521.1, R522.1
IN_60: J_STRADDLE_EDGE.B29, R379.1, R380.1, R381.1, R382.1, R383.1, R384.1, R385.1, R523.1
IN_61: J_STRADDLE_EDGE.B30, R386.1, R387.1, R388.1, R389.1, R390.1, R391.1, R392.1, R524.1
IN_62: J_STRADDLE_EDGE.B31, R393.1, R394.1, R395.1, R396.1, R397.1, R525.1, R526.1, R527.1
IN_63: J_STRADDLE_EDGE.B32, R398.1, R399.1, R400.1, R401.1, R402.1, R403.1, R404.1, R528.1
POS_N0: R001.2, R009.2, R015.2, R021.2, R028.2, R034.2, R041.2, R053.2, R060.2, R067.2, R072.2, R078.2, R083.2, R089.2, R099.2, R107.2, R115.2, R122.2, R128.2, R143.2, R156.2, R164.2, R170.2, R176.2, R182.2, R194.2, R200.2, R207.2, R213.2, R220.2, R227.2, R234.2, R241.2, R247.2, R255.2, R261.2, R266.2, R271.2, R277.2, R283.2, R290.2, R296.2, R304.2, R310.2, R315.2, R320.2, R328.2, R335.2, R347.2, R361.2, R386.2, R413.2, R431.2, R447.2, R457.2, R460.2, R465.2, R474.2, R512.2, R515.2, R518.2, R520.2, R523.2, R525.2, R528.2, R529.2, U1.3
POS_N1: R003.2, R023.2, R030.2, R036.2, R055.2, R062.2, R074.2, R080.2, R091.2, R101.2, R109.2, R123.2, R150.2, R158.2, R189.2, R196.2, R201.2, R209.2, R215.2, R222.2, R236.2, R242.2, R249.2, R257.2, R263.2, R268.2, R273.2, R279.2, R285.2, R291.2, R298.2, R312.2, R322.2, R330.2, R337.2, R349.2, R356.2, R363.2, R369.2, R375.2, R380.2, R388.2, R394.2, R399.2, R414.2, R421.2, R423.2, R429.2, R432.2, R435.2, R443.2, R448.2, R451.2, R455.2, R458.2, R461.2, R463.2, R466.2, R468.2, R470.2, R472.2, R483.2, R502.2, R507.2, R513.2, R530.2, U1.5
POS_N2: R005.2, R018.2, R025.2, R038.2, R044.2, R049.2, R064.2, R076.2, R103.2, R111.2, R118.2, R125.2, R130.2, R135.2, R140.2, R146.2, R152.2, R160.2, R179.2, R185.2, R191.2, R198.2, R203.2, R210.2, R216.2, R224.2, R230.2, R238.2, R244.2, R251.2, R258.2, R264.2, R269.2, R274.2, R280.2, R287.2, R292.2, R300.2, R307.2, R313.2, R317.2, R324.2, R332.2, R339.2, R344.2, R351.2, R358.2, R365.2, R382.2, R390.2, R396.2, R401.2, R409.2, R415.2, R422.2, R426.2, R433.2, R436.2, R441.2, R444.2, R445.2, R449.2, R467.2, R469.2, R519.2, R522.2, U1.10
POS_N3: R007.2, R013.2, R020.2, R027.2, R033.2, R040.2, R046.2, R051.2, R058.2, R066.2, R087.2, R105.2, R113.2, R120.2, R154.2, R162.2, R168.2, R174.2, R181.2, R187.2, R193.2, R199.2, R205.2, R212.2, R218.2, R232.2, R246.2, R253.2, R270.2, R294.2, R302.2, R309.2, R326.2, R333.2, R346.2, R353.2, R372.2, R377.2, R384.2, R403.2, R416.2, R437.2, R438.2, R442.2, R446.2, R450.2, R453.2, R456.2, R459.2, R462.2, R464.2, R482.2, R484.2, R488.2, R491.2, R496.2, R498.2, R499.2, R506.2, R509.2, R511.2, R516.2, R517.2, R524.2, R527.2, R531.2, U1.12
V_SUM_0: J_STRADDLE_EDGE.A33, R417.2, U1.1
V_SUM_1: J_STRADDLE_EDGE.A34, R418.2, U1.7
V_SUM_2: J_STRADDLE_EDGE.A35, R419.2, U1.8
V_SUM_3: J_STRADDLE_EDGE.A36, R420.2, U1.14
