koboshchan/pcbai/boards/dc2/daughtercard2_relu_l1_buffered_repaired.kicad_pcb

## KiCad design boards/dc2/daughtercard2_relu_l1_buffered_repaired.kicad_pcb (2026-10-05)

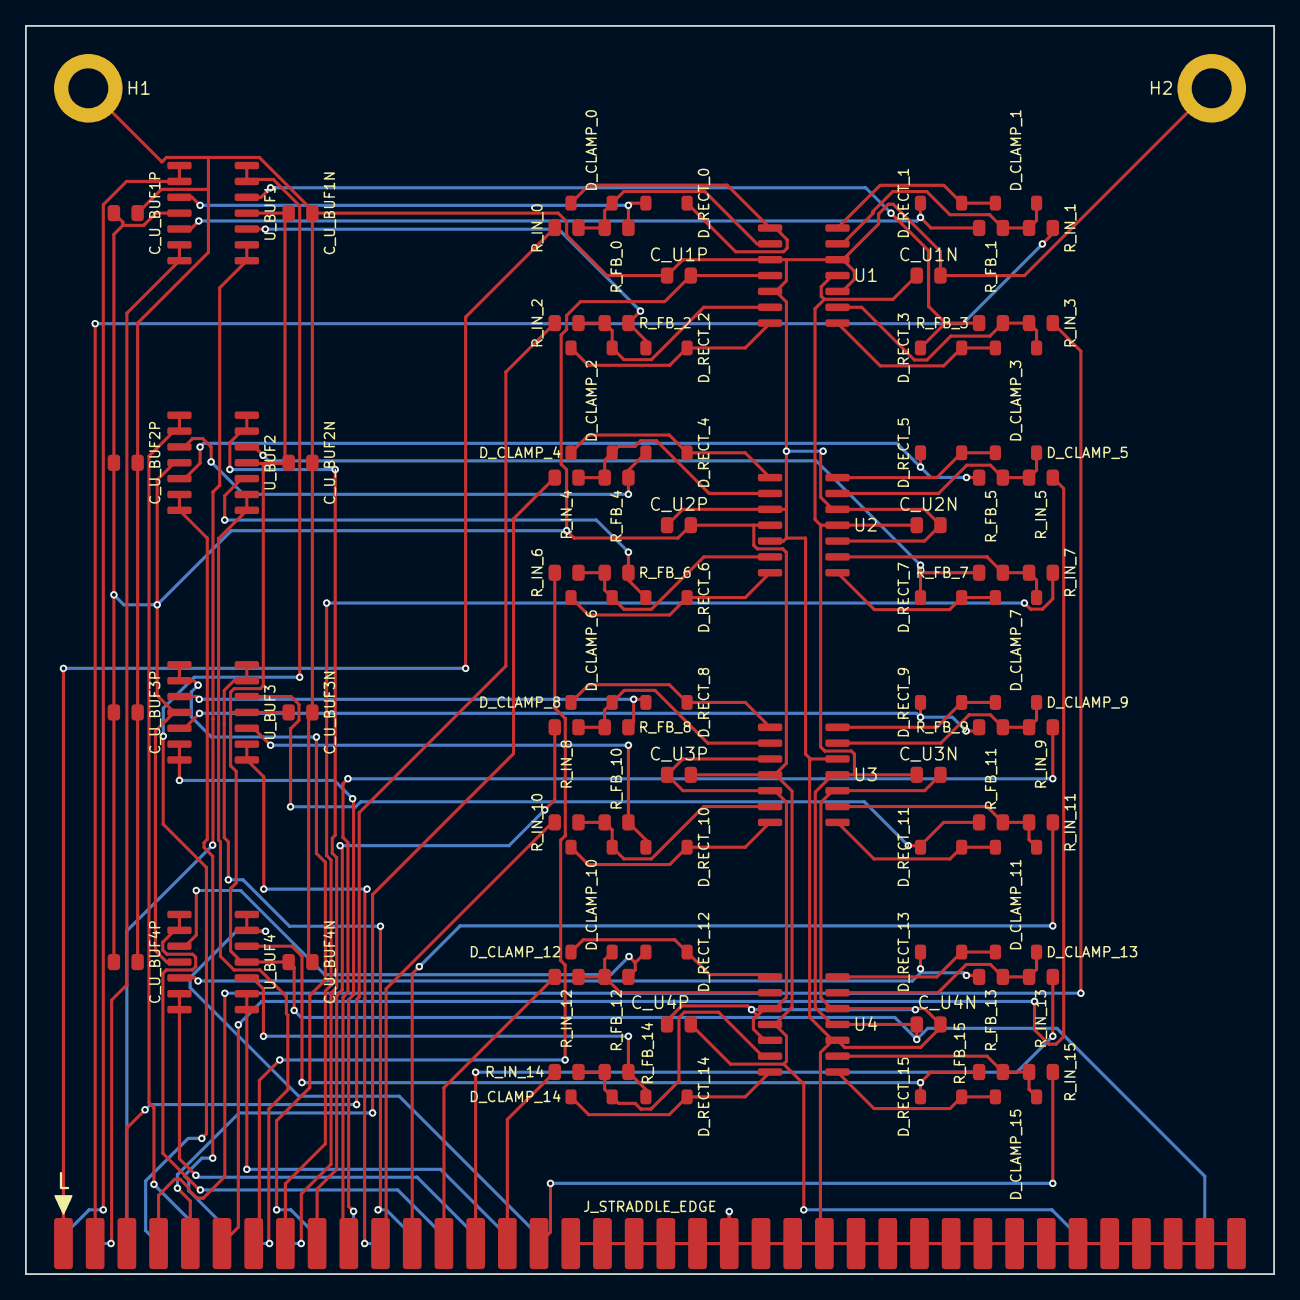
[picture p36: board daughtercard2_relu_l1_buffered_repaired.kicad_pcb from above]

Board: 2 copper layers, 100.0 x 100.0 mm, 91 parts (0 on the bottom side), 83 nets.

Parts:
C_U1N, C_U1P, C_U2N, C_U2P, C_U3N, C_U3P, C_U4N, C_U4P: 0.1uF; C_0805_2012Metric
C_U_BUF1N, C_U_BUF1P, C_U_BUF2N, C_U_BUF2P, C_U_BUF3N, C_U_BUF3P, C_U_BUF4N, C_U_BUF4P: 0.1uF; C_0805_2012Metric
D_CLAMP_0, D_CLAMP_1, D_CLAMP_2, D_CLAMP_3, D_CLAMP_4, D_CLAMP_5, D_CLAMP_6, D_CLAMP_7, D_CLAMP_8, D_CLAMP_9, D_CLAMP_10, D_CLAMP_11, D_CLAMP_12, D_CLAMP_13, D_CLAMP_14, D_CLAMP_15: 1N4148W; D_SOD-123
D_RECT_0, D_RECT_1, D_RECT_2, D_RECT_3, D_RECT_4, D_RECT_5, D_RECT_6, D_RECT_7, D_RECT_8, D_RECT_9, D_RECT_10, D_RECT_11, D_RECT_12, D_RECT_13, D_RECT_14, D_RECT_15: 1N4148W; D_SOD-123
H1, H2: MountingHole; MountingHole_3.2mm_M3_Pad
J_STRADDLE_EDGE: PinHeader_2x38_Straddle; PinHeader_2x38_Straddle_P2.54mm
R_FB_0, R_FB_1, R_FB_2, R_FB_3, R_FB_4, R_FB_5, R_FB_6, R_FB_7, R_FB_8, R_FB_9, R_FB_10, R_FB_11, R_FB_12, R_FB_13, R_FB_14, R_FB_15: 10k; R_0805_2012Metric
R_IN_0, R_IN_1, R_IN_2, R_IN_3, R_IN_4, R_IN_5, R_IN_6, R_IN_7, R_IN_8, R_IN_9, R_IN_10, R_IN_11, R_IN_12, R_IN_13, R_IN_14, R_IN_15: 10k; R_0805_2012Metric
U1, U2, U3, U4: TL074; SOIC-14_3.9x8.7mm_P1.27mm
U_BUF1, U_BUF2, U_BUF3, U_BUF4: TL074; SOIC-14_3.9x8.7mm_P1.27mm

Connections:
+15V: C_U1P.2, C_U2P.2, C_U3P.2, C_U4P.2, C_U_BUF1P.1, C_U_BUF2P.1, C_U_BUF3P.1, C_U_BUF4P.1, J_STRADDLE_EDGE.B33, J_STRADDLE_EDGE.B34, U1.4, U2.4, U3.4, U4.4, U_BUF1.4, U_BUF2.4, U_BUF3.4, U_BUF4.4
-15V: C_U1N.1, C_U2N.1, C_U3N.1, C_U4N.1, C_U_BUF1N.1, C_U_BUF2N.1, C_U_BUF3N.1, C_U_BUF4N.1, J_STRADDLE_EDGE.B37, J_STRADDLE_EDGE.B38, U1.11, U2.11, U3.11, U4.11, U_BUF1.11, U_BUF2.11, U_BUF3.11, U_BUF4.11
ACT_0: J_STRADDLE_EDGE.B1, U_BUF1.1, U_BUF1.2
ACT_1: J_STRADDLE_EDGE.B2, U_BUF1.6, U_BUF1.7
ACT_2: J_STRADDLE_EDGE.B3, U_BUF1.8, U_BUF1.9
ACT_3: J_STRADDLE_EDGE.B4, U_BUF1.13, U_BUF1.14
ACT_4: J_STRADDLE_EDGE.B5, U_BUF2.1, U_BUF2.2
ACT_5: J_STRADDLE_EDGE.B6, U_BUF2.6, U_BUF2.7
ACT_6: J_STRADDLE_EDGE.B7, U_BUF2.8, U_BUF2.9
ACT_7: J_STRADDLE_EDGE.B8, U_BUF2.13, U_BUF2.14
ACT_8: J_STRADDLE_EDGE.B9, U_BUF3.1, U_BUF3.2
ACT_9: J_STRADDLE_EDGE.B10, U_BUF3.6, U_BUF3.7
ACT_10: J_STRADDLE_EDGE.B11, U_BUF3.8, U_BUF3.9
ACT_11: J_STRADDLE_EDGE.B12, U_BUF3.13, U_BUF3.14
ACT_12: J_STRADDLE_EDGE.B13, U_BUF4.1, U_BUF4.2
ACT_13: J_STRADDLE_EDGE.B14, U_BUF4.6, U_BUF4.7
ACT_14: J_STRADDLE_EDGE.B15, U_BUF4.8, U_BUF4.9
ACT_15: J_STRADDLE_EDGE.B16, U_BUF4.13, U_BUF4.14
GND: C_U1N.2, C_U1P.1, C_U2N.2, C_U2P.1, C_U3N.2, C_U3P.1, C_U4N.2, C_U4P.1, C_U_BUF1N.2, C_U_BUF1P.2, C_U_BUF2N.2, C_U_BUF2P.2, C_U_BUF3N.2, C_U_BUF3P.2, C_U_BUF4N.2, C_U_BUF4P.2, H1.1, H2.1, J_STRADDLE_EDGE.A17, J_STRADDLE_EDGE.A18, J_STRADDLE_EDGE.A19, J_STRADDLE_EDGE.A20, J_STRADDLE_EDGE.A21, J_STRADDLE_EDGE.A22, J_STRADDLE_EDGE.A23, J_STRADDLE_EDGE.A24, J_STRADDLE_EDGE.A25, J_STRADDLE_EDGE.A26, J_STRADDLE_EDGE.A27, J_STRADDLE_EDGE.A28, J_STRADDLE_EDGE.A29, J_STRADDLE_EDGE.A30, J_STRADDLE_EDGE.A31, J_STRADDLE_EDGE.A32, J_STRADDLE_EDGE.A33, J_STRADDLE_EDGE.A34, J_STRADDLE_EDGE.A35, J_STRADDLE_EDGE.A36, J_STRADDLE_EDGE.A37, J_STRADDLE_EDGE.A38, J_STRADDLE_EDGE.B17, J_STRADDLE_EDGE.B18, J_STRADDLE_EDGE.B19, J_STRADDLE_EDGE.B20, J_STRADDLE_EDGE.B21, J_STRADDLE_EDGE.B22, J_STRADDLE_EDGE.B23, J_STRADDLE_EDGE.B24, J_STRADDLE_EDGE.B25, J_STRADDLE_EDGE.B26, J_STRADDLE_EDGE.B27, J_STRADDLE_EDGE.B28, J_STRADDLE_EDGE.B29, J_STRADDLE_EDGE.B30, J_STRADDLE_EDGE.B31, J_STRADDLE_EDGE.B32, U1.3, U1.5, U1.10, U1.12, U2.3, U2.5, U2.10, U2.12, U3.3, U3.5, U3.10, U3.12, U4.3, U4.5, U4.10, U4.12
INV_RELU_0: D_CLAMP_0.2, R_FB_0.1, R_IN_0.2, U1.2
INV_RELU_1: D_CLAMP_1.2, R_FB_1.2, R_IN_1.1, U1.13
INV_RELU_2: D_CLAMP_2.2, R_FB_2.1, R_IN_2.2, U1.6
INV_RELU_3: D_CLAMP_3.2, R_FB_3.2, R_IN_3.1, U1.9
INV_RELU_4: D_CLAMP_4.2, R_FB_4.1, R_IN_4.2, U2.2
INV_RELU_5: D_CLAMP_5.2, R_FB_5.2, R_IN_5.1, U2.13
INV_RELU_6: D_CLAMP_6.2, R_FB_6.1, R_IN_6.2, U2.6
INV_RELU_7: D_CLAMP_7.2, R_FB_7.2, R_IN_7.1, U2.9
INV_RELU_8: D_CLAMP_8.2, R_FB_8.1, R_IN_8.2, U3.2
INV_RELU_9: D_CLAMP_9.2, R_FB_9.2, R_IN_9.1, U3.13
INV_RELU_10: D_CLAMP_10.2, R_FB_10.1, R_IN_10.2, U3.6
INV_RELU_11: D_CLAMP_11.2, R_FB_11.2, R_IN_11.1, U3.9
INV_RELU_12: D_CLAMP_12.2, R_FB_12.1, R_IN_12.2, U4.2
INV_RELU_13: D_CLAMP_13.2, R_FB_13.2, R_IN_13.1, U4.13
INV_RELU_14: D_CLAMP_14.2, R_FB_14.1, R_IN_14.2, U4.6
INV_RELU_15: D_CLAMP_15.2, R_FB_15.2, R_IN_15.1, U4.9
OP_OUT_0: D_CLAMP_0.1, D_RECT_0.2, U1.1
OP_OUT_1: D_CLAMP_1.1, D_RECT_1.2, U1.14
OP_OUT_2: D_CLAMP_2.1, D_RECT_2.2, U1.7
OP_OUT_3: D_CLAMP_3.1, D_RECT_3.2, U1.8
OP_OUT_4: D_CLAMP_4.1, D_RECT_4.2, U2.1
OP_OUT_5: D_CLAMP_5.1, D_RECT_5.2, U2.14
OP_OUT_6: D_CLAMP_6.1, D_RECT_6.2, U2.7
OP_OUT_7: D_CLAMP_7.1, D_RECT_7.2, U2.8
OP_OUT_8: D_CLAMP_8.1, D_RECT_8.2, U3.1
OP_OUT_9: D_CLAMP_9.1, D_RECT_9.2, U3.14
OP_OUT_10: D_CLAMP_10.1, D_RECT_10.2, U3.7
OP_OUT_11: D_CLAMP_11.1, D_RECT_11.2, U3.8
OP_OUT_12: D_CLAMP_12.1, D_RECT_12.2, U4.1
OP_OUT_13: D_CLAMP_13.1, D_RECT_13.2, U4.14
OP_OUT_14: D_CLAMP_14.1, D_RECT_14.2, U4.7
OP_OUT_15: D_CLAMP_15.1, D_RECT_15.2, U4.8
RECT_0: D_RECT_0.1, R_FB_0.2, U_BUF1.3
RECT_1: D_RECT_1.1, R_FB_1.1, U_BUF1.5
RECT_2: D_RECT_2.1, R_FB_2.2, U_BUF1.10
RECT_3: D_RECT_3.1, R_FB_3.1, U_BUF1.12
RECT_4: D_RECT_4.1, R_FB_4.2, U_BUF2.3
RECT_5: D_RECT_5.1, R_FB_5.1, U_BUF2.5
RECT_6: D_RECT_6.1, R_FB_6.2, U_BUF2.10
RECT_7: D_RECT_7.1, R_FB_7.1, U_BUF2.12
RECT_8: D_RECT_8.1, R_FB_8.2, U_BUF3.3
RECT_9: D_RECT_9.1, R_FB_9.1, U_BUF3.5
RECT_10: D_RECT_10.1, R_FB_10.2, U_BUF3.10
RECT_11: D_RECT_11.1, R_FB_11.1, U_BUF3.12
RECT_12: D_RECT_12.1, R_FB_12.2, U_BUF4.3
RECT_13: D_RECT_13.1, R_FB_13.1, U_BUF4.5
RECT_14: D_RECT_14.1, R_FB_14.2, U_BUF4.10
RECT_15: D_RECT_15.1, R_FB_15.1, U_BUF4.12
V_SUM_0: J_STRADDLE_EDGE.A1, R_IN_0.1
V_SUM_1: J_STRADDLE_EDGE.A2, R_IN_1.2
V_SUM_2: J_STRADDLE_EDGE.A3, R_IN_2.1
V_SUM_3: J_STRADDLE_EDGE.A4, R_IN_3.2
V_SUM_4: J_STRADDLE_EDGE.A5, R_IN_4.1
V_SUM_5: J_STRADDLE_EDGE.A6, R_IN_5.2
V_SUM_6: J_STRADDLE_EDGE.A7, R_IN_6.1
V_SUM_7: J_STRADDLE_EDGE.A8, R_IN_7.2
V_SUM_8: J_STRADDLE_EDGE.A9, R_IN_8.1
V_SUM_9: J_STRADDLE_EDGE.A10, R_IN_9.2
V_SUM_10: J_STRADDLE_EDGE.A11, R_IN_10.1
V_SUM_11: J_STRADDLE_EDGE.A12, R_IN_11.2
V_SUM_12: J_STRADDLE_EDGE.A13, R_IN_12.1
V_SUM_13: J_STRADDLE_EDGE.A14, R_IN_13.2
V_SUM_14: J_STRADDLE_EDGE.A15, R_IN_14.1
V_SUM_15: J_STRADDLE_EDGE.A16, R_IN_15.2
