koboshchan/pcbai/boards/dc3/dc3_universal.kicad_pcb

## KiCad design boards/dc3/dc3_universal.kicad_pcb (2026-10-05)

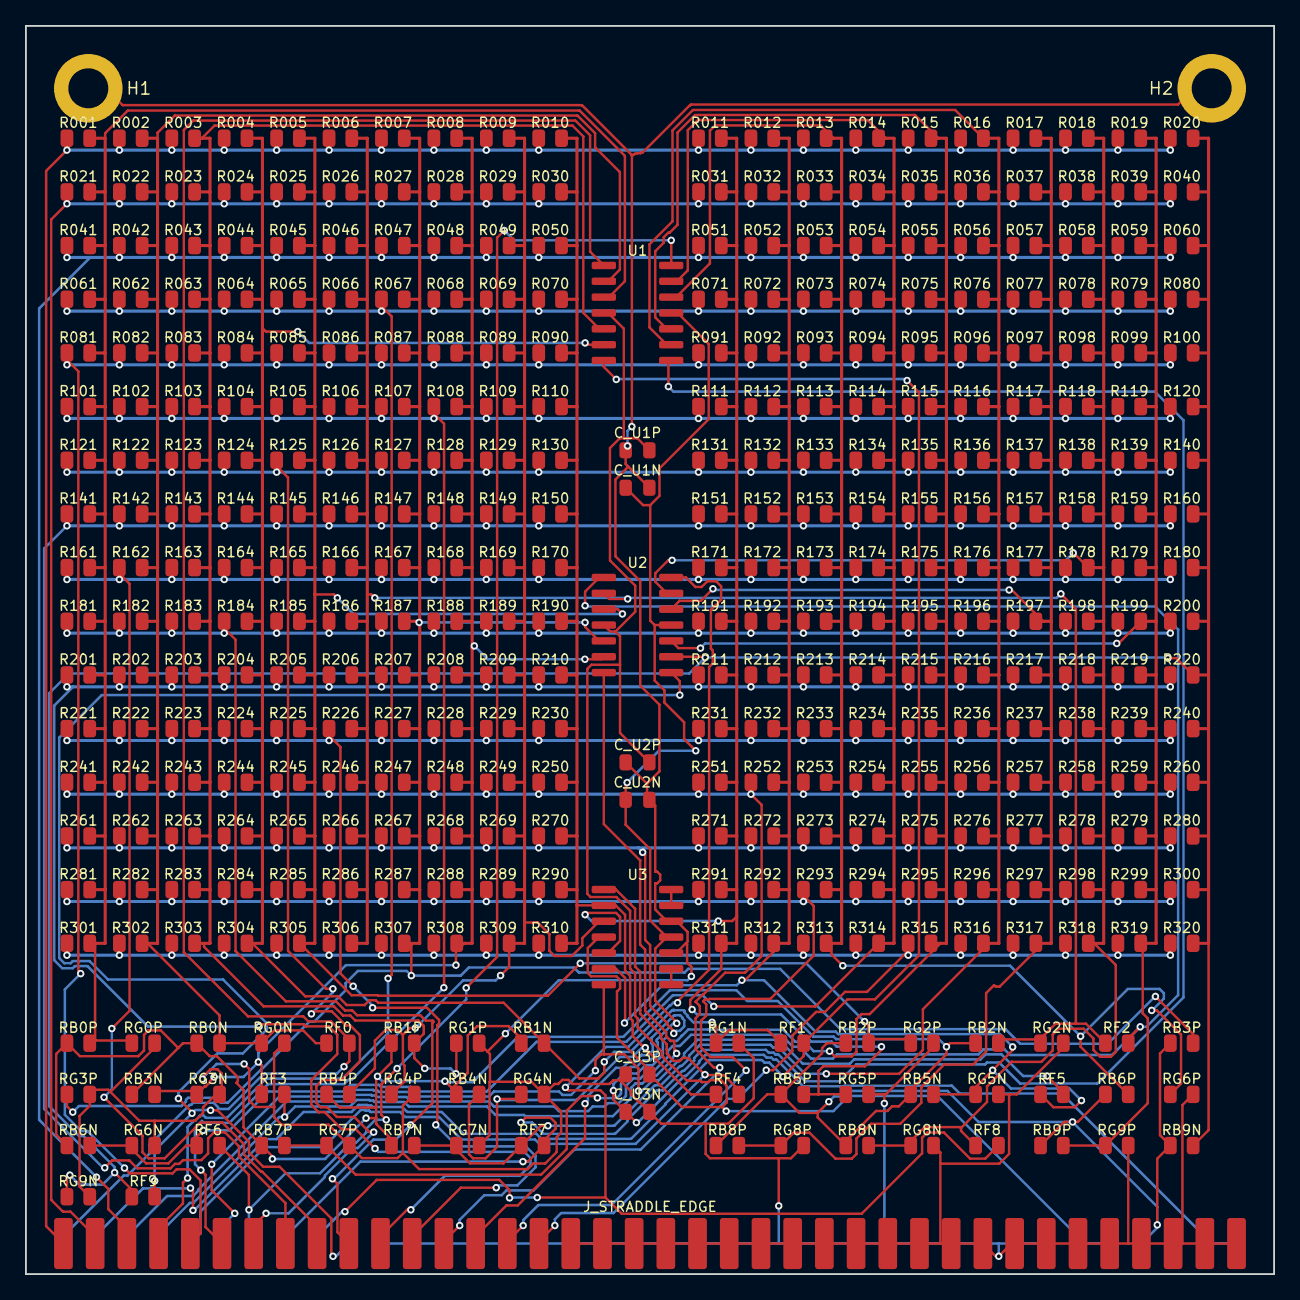
[picture p37: board dc3_universal.kicad_pcb from above]

Board: 2 copper layers, 100.0 x 100.0 mm, 382 parts (0 on the bottom side), 52 nets.

Parts:
C_U1N, C_U1P, C_U2N, C_U2P, C_U3N, C_U3P: 0.1uF; C_0805_2012Metric
H1, H2: MountingHole; MountingHole_3.2mm_M3_Pad
J_STRADDLE_EDGE: PinHeader_2x38_Straddle; PinHeader_2x38_Straddle_P2.54mm
R001, R004, R005, R008, R009, R011, R013, R016, R017, R020, R022, R023, R024, R025, R026, R027, R029, R030, R031, R033, R034, R035, R036, R037, R038, R039, R042, R043, R045, R048, R049, R052, R053, R055, R058, R059, R060, R061, R063, R066, R068, R069, R071, R073, R076, R077, R079, R081, R084, R086, R087, R089, R092, R093, R096, R097, R099, R101, R104, R105, R108, R110, R111, R113, R115, R117, R118, R120, R121, R123, R125, R127, R128, R129, R132, R134, R135, R137, R138, R139, R141, R143, R144, R145, R148, R149, R152, R154, R155, R157, R158, R159, R162, R163, R165, R167, R169, R171, R172, R173, R176, R178, R180, R181, R184, R185, R187, R190, R192, R194, R196, R197, R199, R201, R202, R203, R206, R208, R209, R211, R213, R216, R217, R219, R221, R222, R223, R224, R225, R226, R227, R228, R230, R231, R233, R235, R236, R237, R238, R239, R240, R241, R243, R246, R247, R250, R251, R254, R255, R257, R258, R259, R261, R264, R265, R266, R267, R268, R270, R271, R273, R274, R275, R276, R277, R278, R279, R280, R281, R283, R286, R287, R288, R290, R292, R293, R296, R297, R300, R301, R302, R304, R305, R306, R307, R308, R309, R310, R311, R313, R315, R316, R317, R318, R319, R320: DNP; R_0805_2012Metric
R002, R065, R168, R183, R214: 91k; R_0805_2012Metric
R003, R062, R131, R150, R182, R284: 100k; R_0805_2012Metric
R006: 1.6M; R_0805_2012Metric
R007, R028, R109, R126, R153, R212, R218, R262, R282: 220k; R_0805_2012Metric
R010, R056, R107, R147, R174, R188, R272: 270k; R_0805_2012Metric
R012, R014, R102: 56k; R_0805_2012Metric
R015, R072: 470k; R_0805_2012Metric
R018, R040, R112, R119, R186, R189, R198, R215, R229, R234, R253: 180k; R_0805_2012Metric
R019, R046, R091, R094, R179, R252, R299: 300k; R_0805_2012Metric
R021, R047, R050, R161, R207, R232, R295, R312: 240k; R_0805_2012Metric
R032, R103: 82k; R_0805_2012Metric
R041, R220, R298: 110k; R_0805_2012Metric
R044: 51k; R_0805_2012Metric
R051, R067, R075, R314: 360k; R_0805_2012Metric
R054, R100: 430k; R_0805_2012Metric
R057: 5.1M; R_0805_2012Metric
R064, R140, R156, R200, R205, R269: 150k; R_0805_2012Metric
R070, R080, R106, R289: 130k; R_0805_2012Metric
R074, R114, R130, R146, R151, R204: 68k; R_0805_2012Metric
R078, R116, R122, R133, R166, R244, R249, R294: 200k; R_0805_2012Metric
R082, R191: 1M; R_0805_2012Metric
R083, R090, R177: 120k; R_0805_2012Metric
R085: 680k; R_0805_2012Metric
R088, R285: 750k; R_0805_2012Metric
R095, R248: 390k; R_0805_2012Metric
R098: 62k; R_0805_2012Metric
R124, R256: 43k; R_0805_2012Metric
R136, R175: 330k; R_0805_2012Metric
R142, R160: 75k; R_0805_2012Metric
R164, R260, R303: 160k; R_0805_2012Metric
R170, R193, R195: 620k; R_0805_2012Metric
R210: 33k; R_0805_2012Metric
R242: 510k; R_0805_2012Metric
R245: 1.1M; R_0805_2012Metric
R263: 820k; R_0805_2012Metric
R291: 2.7M; R_0805_2012Metric
RB0N, RB1N, RB2N, RB3P, RB4P, RB5P, RB6N, RB7N, RB8N, RB8P, RB9P: DNP; R_0805_2012Metric
RB0P: 270k; R_0805_2012Metric
RB1P, RB3N: 160k; R_0805_2012Metric
RB2P, RB4N: 560k; R_0805_2012Metric
RB5N: 2M; R_0805_2012Metric
RB6P: 240k; R_0805_2012Metric
RB7P: 3.9M; R_0805_2012Metric
RB9N: 360k; R_0805_2012Metric
RF0, RF1, RF2, RF3, RF4, RF5, RF6, RF7, RF8, RF9: 100k; R_0805_2012Metric
RG0N, RG1N, RG2N, RG3N, RG4N, RG5N, RG6N, RG7N, RG8N, RG9N: DNP; R_0805_2012Metric
RG0P: 14.7k; R_0805_2012Metric
RG1P: 24.9k; R_0805_2012Metric
RG2P: 35.7k; R_0805_2012Metric
RG3P: 61.9k; R_0805_2012Metric
RG4P: 17.4k; R_0805_2012Metric
RG5P: 28k; R_0805_2012Metric
RG6P: 14.3k; R_0805_2012Metric
RG7P: 34k; R_0805_2012Metric
RG8P: 21k; R_0805_2012Metric
RG9P: 18.2k; R_0805_2012Metric
U1, U2, U3: TL074; SOIC-14_3.9x8.7mm_P1.27mm

Connections:
+5V_REF: J_STRADDLE_EDGE.B35, RB0N.1, RB0P.1, RB1N.1, RB1P.1, RB2N.1, RB2P.1, RB3N.1, RB3P.1, RB4N.1, RB4P.1, RB5N.1, RB5P.1, RB6N.1, RB6P.1, RB7N.1, RB7P.1, RB8N.1, RB8P.1, RB9N.1, RB9P.1
+15V: C_U1P.2, C_U2P.2, C_U3P.2, J_STRADDLE_EDGE.B33, J_STRADDLE_EDGE.B34, U1.4, U2.4, U3.4
-15V: C_U1N.1, C_U2N.1, C_U3N.1, J_STRADDLE_EDGE.B37, J_STRADDLE_EDGE.B38, U1.11, U2.11, U3.11
ACT_0: J_STRADDLE_EDGE.A1, R001.1, R002.1, R003.1, R004.1, R005.1, R006.1, R007.1, R008.1, R009.1, R010.1, R011.1, R012.1, R013.1, R014.1, R015.1, R016.1, R017.1, R018.1, R019.1, R020.1
ACT_1: J_STRADDLE_EDGE.A2, R021.1, R022.1, R023.1, R024.1, R025.1, R026.1, R027.1, R028.1, R029.1, R030.1, R031.1, R032.1, R033.1, R034.1, R035.1, R036.1, R037.1, R038.1, R039.1, R040.1
ACT_2: J_STRADDLE_EDGE.A3, R041.1, R042.1, R043.1, R044.1, R045.1, R046.1, R047.1, R048.1, R049.1, R050.1, R051.1, R052.1, R053.1, R054.1, R055.1, R056.1, R057.1, R058.1, R059.1, R060.1
ACT_3: J_STRADDLE_EDGE.A4, R061.1, R062.1, R063.1, R064.1, R065.1, R066.1, R067.1, R068.1, R069.1, R070.1, R071.1, R072.1, R073.1, R074.1, R075.1, R076.1, R077.1, R078.1, R079.1, R080.1
ACT_4: J_STRADDLE_EDGE.A5, R081.1, R082.1, R083.1, R084.1, R085.1, R086.1, R087.1, R088.1, R089.1, R090.1, R091.1, R092.1, R093.1, R094.1, R095.1, R096.1, R097.1, R098.1, R099.1, R100.1
ACT_5: J_STRADDLE_EDGE.A6, R101.1, R102.1, R103.1, R104.1, R105.1, R106.1, R107.1, R108.1, R109.1, R110.1, R111.1, R112.1, R113.1, R114.1, R115.1, R116.1, R117.1, R118.1, R119.1, R120.1
ACT_6: J_STRADDLE_EDGE.A7, R121.1, R122.1, R123.1, R124.1, R125.1, R126.1, R127.1, R128.1, R129.1, R130.1, R131.1, R132.1, R133.1, R134.1, R135.1, R136.1, R137.1, R138.1, R139.1, R140.1
ACT_7: J_STRADDLE_EDGE.A8, R141.1, R142.1, R143.1, R144.1, R145.1, R146.1, R147.1, R148.1, R149.1, R150.1, R151.1, R152.1, R153.1, R154.1, R155.1, R156.1, R157.1, R158.1, R159.1, R160.1
ACT_8: J_STRADDLE_EDGE.A9, R161.1, R162.1, R163.1, R164.1, R165.1, R166.1, R167.1, R168.1, R169.1, R170.1, R171.1, R172.1, R173.1, R174.1, R175.1, R176.1, R177.1, R178.1, R179.1, R180.1
ACT_9: J_STRADDLE_EDGE.A10, R181.1, R182.1, R183.1, R184.1, R185.1, R186.1, R187.1, R188.1, R189.1, R190.1, R191.1, R192.1, R193.1, R194.1, R195.1, R196.1, R197.1, R198.1, R199.1, R200.1
ACT_10: J_STRADDLE_EDGE.A11, R201.1, R202.1, R203.1, R204.1, R205.1, R206.1, R207.1, R208.1, R209.1, R210.1, R211.1, R212.1, R213.1, R214.1, R215.1, R216.1, R217.1, R218.1, R219.1, R220.1
ACT_11: J_STRADDLE_EDGE.A12, R221.1, R222.1, R223.1, R224.1, R225.1, R226.1, R227.1, R228.1, R229.1, R230.1, R231.1, R232.1, R233.1, R234.1, R235.1, R236.1, R237.1, R238.1, R239.1, R240.1
ACT_12: J_STRADDLE_EDGE.A13, R241.1, R242.1, R243.1, R244.1, R245.1, R246.1, R247.1, R248.1, R249.1, R250.1, R251.1, R252.1, R253.1, R254.1, R255.1, R256.1, R257.1, R258.1, R259.1, R260.1
ACT_13: J_STRADDLE_EDGE.A14, R261.1, R262.1, R263.1, R264.1, R265.1, R266.1, R267.1, R268.1, R269.1, R270.1, R271.1, R272.1, R273.1, R274.1, R275.1, R276.1, R277.1, R278.1, R279.1, R280.1
ACT_14: J_STRADDLE_EDGE.A15, R281.1, R282.1, R283.1, R284.1, R285.1, R286.1, R287.1, R288.1, R289.1, R290.1, R291.1, R292.1, R293.1, R294.1, R295.1, R296.1, R297.1, R298.1, R299.1, R300.1
ACT_15: J_STRADDLE_EDGE.A16, R301.1, R302.1, R303.1, R304.1, R305.1, R306.1, R307.1, R308.1, R309.1, R310.1, R311.1, R312.1, R313.1, R314.1, R315.1, R316.1, R317.1, R318.1, R319.1, R320.1
GND: C_U1N.2, C_U1P.1, C_U2N.2, C_U2P.1, C_U3N.2, C_U3P.1, H1.1, H2.1, J_STRADDLE_EDGE.A17, J_STRADDLE_EDGE.A18, J_STRADDLE_EDGE.A19, J_STRADDLE_EDGE.A20, J_STRADDLE_EDGE.A21, J_STRADDLE_EDGE.A22, J_STRADDLE_EDGE.A23, J_STRADDLE_EDGE.A24, J_STRADDLE_EDGE.A25, J_STRADDLE_EDGE.A26, J_STRADDLE_EDGE.A27, J_STRADDLE_EDGE.A28, J_STRADDLE_EDGE.A29, J_STRADDLE_EDGE.A30, J_STRADDLE_EDGE.A31, J_STRADDLE_EDGE.A32, J_STRADDLE_EDGE.A33, J_STRADDLE_EDGE.A34, J_STRADDLE_EDGE.A35, J_STRADDLE_EDGE.A36, J_STRADDLE_EDGE.A37, J_STRADDLE_EDGE.A38, J_STRADDLE_EDGE.B11, J_STRADDLE_EDGE.B12, J_STRADDLE_EDGE.B13, J_STRADDLE_EDGE.B14, J_STRADDLE_EDGE.B15, J_STRADDLE_EDGE.B16, J_STRADDLE_EDGE.B17, J_STRADDLE_EDGE.B18, J_STRADDLE_EDGE.B19, J_STRADDLE_EDGE.B20, J_STRADDLE_EDGE.B21, J_STRADDLE_EDGE.B22, J_STRADDLE_EDGE.B23, J_STRADDLE_EDGE.B24, J_STRADDLE_EDGE.B25, J_STRADDLE_EDGE.B26, J_STRADDLE_EDGE.B27, J_STRADDLE_EDGE.B28, J_STRADDLE_EDGE.B29, J_STRADDLE_EDGE.B30, J_STRADDLE_EDGE.B31, J_STRADDLE_EDGE.B32, RG0N.2, RG0P.2, RG1N.2, RG1P.2, RG2N.2, RG2P.2, RG3N.2, RG3P.2, RG4N.2, RG4P.2, RG5N.2, RG5P.2, RG6N.2, RG6P.2, RG7N.2, RG7P.2, RG8N.2, RG8P.2, RG9N.2, RG9P.2, U3.10, U3.12
INV_L2_0: R002.2, R022.2, R042.2, R062.2, R082.2, R102.2, R122.2, R142.2, R162.2, R182.2, R202.2, R222.2, R242.2, R262.2, R282.2, R302.2, RB0N.2, RF0.1, RG0N.1, U1.2
INV_L2_1: R004.2, R024.2, R044.2, R064.2, R084.2, R104.2, R124.2, R144.2, R164.2, R184.2, R204.2, R224.2, R244.2, R264.2, R284.2, R304.2, RB1N.2, RF1.1, RG1N.1, U1.6
INV_L2_2: R006.2, R026.2, R046.2, R066.2, R086.2, R106.2, R126.2, R146.2, R166.2, R186.2, R206.2, R226.2, R246.2, R266.2, R286.2, R306.2, RB2N.2, RF2.1, RG2N.1, U2.2
INV_L2_3: R008.2, R028.2, R048.2, R068.2, R088.2, R108.2, R128.2, R148.2, R168.2, R188.2, R208.2, R228.2, R248.2, R268.2, R288.2, R308.2, RB3N.2, RF3.1, RG3N.1, U2.6
INV_L2_4: R010.2, R030.2, R050.2, R070.2, R090.2, R110.2, R130.2, R150.2, R170.2, R190.2, R210.2, R230.2, R250.2, R270.2, R290.2, R310.2, RB4N.2, RF4.1, RG4N.1, U3.2
INV_L2_5: R012.2, R032.2, R052.2, R072.2, R092.2, R112.2, R132.2, R152.2, R172.2, R192.2, R212.2, R232.2, R252.2, R272.2, R292.2, R312.2, RB5N.2, RF5.1, RG5N.1, U3.6
INV_L2_6: R014.2, R034.2, R054.2, R074.2, R094.2, R114.2, R134.2, R154.2, R174.2, R194.2, R214.2, R234.2, R254.2, R274.2, R294.2, R314.2, RB6N.2, RF6.1, RG6N.1, U1.13
INV_L2_7: R016.2, R036.2, R056.2, R076.2, R096.2, R116.2, R136.2, R156.2, R176.2, R196.2, R216.2, R236.2, R256.2, R276.2, R296.2, R316.2, RB7N.2, RF7.1, RG7N.1, U1.9
INV_L2_8: R018.2, R038.2, R058.2, R078.2, R098.2, R118.2, R138.2, R158.2, R178.2, R198.2, R218.2, R238.2, R258.2, R278.2, R298.2, R318.2, RB8N.2, RF8.1, RG8N.1, U2.13
INV_L2_9: R020.2, R040.2, R060.2, R080.2, R100.2, R120.2, R140.2, R160.2, R180.2, R200.2, R220.2, R240.2, R260.2, R280.2, R300.2, R320.2, RB9N.2, RF9.1, RG9N.1, U2.9
NC_U3_8: U3.8, U3.9
NC_U3_14: U3.13, U3.14
POS_L2_0: R001.2, R021.2, R041.2, R061.2, R081.2, R101.2, R121.2, R141.2, R161.2, R181.2, R201.2, R221.2, R241.2, R261.2, R281.2, R301.2, RB0P.2, RG0P.1, U1.3
POS_L2_1: R003.2, R023.2, R043.2, R063.2, R083.2, R103.2, R123.2, R143.2, R163.2, R183.2, R203.2, R223.2, R243.2, R263.2, R283.2, R303.2, RB1P.2, RG1P.1, U1.5
POS_L2_2: R005.2, R025.2, R045.2, R065.2, R085.2, R105.2, R125.2, R145.2, R165.2, R185.2, R205.2, R225.2, R245.2, R265.2, R285.2, R305.2, RB2P.2, RG2P.1, U2.3
POS_L2_3: R007.2, R027.2, R047.2, R067.2, R087.2, R107.2, R127.2, R147.2, R167.2, R187.2, R207.2, R227.2, R247.2, R267.2, R287.2, R307.2, RB3P.2, RG3P.1, U2.5
POS_L2_4: R009.2, R029.2, R049.2, R069.2, R089.2, R109.2, R129.2, R149.2, R169.2, R189.2, R209.2, R229.2, R249.2, R269.2, R289.2, R309.2, RB4P.2, RG4P.1, U3.3
POS_L2_5: R011.2, R031.2, R051.2, R071.2, R091.2, R111.2, R131.2, R151.2, R171.2, R191.2, R211.2, R231.2, R251.2, R271.2, R291.2, R311.2, RB5P.2, RG5P.1, U3.5
POS_L2_6: R013.2, R033.2, R053.2, R073.2, R093.2, R113.2, R133.2, R153.2, R173.2, R193.2, R213.2, R233.2, R253.2, R273.2, R293.2, R313.2, RB6P.2, RG6P.1, U1.12
POS_L2_7: R015.2, R035.2, R055.2, R075.2, R095.2, R115.2, R135.2, R155.2, R175.2, R195.2, R215.2, R235.2, R255.2, R275.2, R295.2, R315.2, RB7P.2, RG7P.1, U1.10
POS_L2_8: R017.2, R037.2, R057.2, R077.2, R097.2, R117.2, R137.2, R157.2, R177.2, R197.2, R217.2, R237.2, R257.2, R277.2, R297.2, R317.2, RB8P.2, RG8P.1, U2.12
POS_L2_9: R019.2, R039.2, R059.2, R079.2, R099.2, R119.2, R139.2, R159.2, R179.2, R199.2, R219.2, R239.2, R259.2, R279.2, R299.2, R319.2, RB9P.2, RG9P.1, U2.10
SCORE_0: J_STRADDLE_EDGE.B1, RF0.2, U1.1
SCORE_1: J_STRADDLE_EDGE.B2, RF1.2, U1.7
SCORE_2: J_STRADDLE_EDGE.B3, RF2.2, U2.1
SCORE_3: J_STRADDLE_EDGE.B4, RF3.2, U2.7
SCORE_4: J_STRADDLE_EDGE.B5, RF4.2, U3.1
SCORE_5: J_STRADDLE_EDGE.B6, RF5.2, U3.7
SCORE_6: J_STRADDLE_EDGE.B7, RF6.2, U1.14
SCORE_7: J_STRADDLE_EDGE.B8, RF7.2, U1.8
SCORE_8: J_STRADDLE_EDGE.B9, RF8.2, U2.14
SCORE_9: J_STRADDLE_EDGE.B10, RF9.2, U2.8
