koboshchan/pcbai/boards/ads_carrier/targeted.kicad_pcb

## KiCad design boards/ads_carrier/targeted.kicad_pcb (2026-10-05)

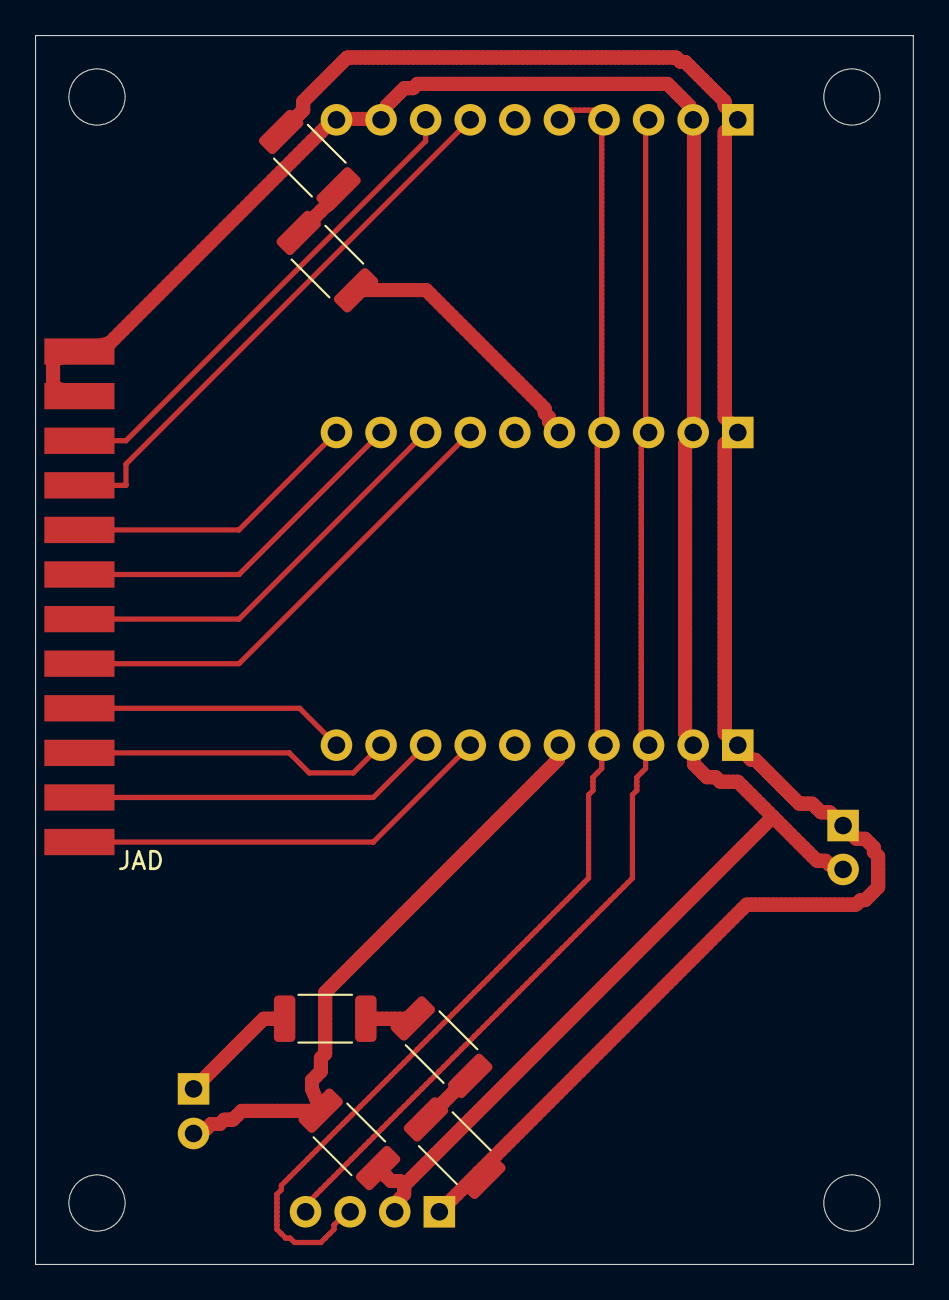
[picture p38: board targeted.kicad_pcb from above]

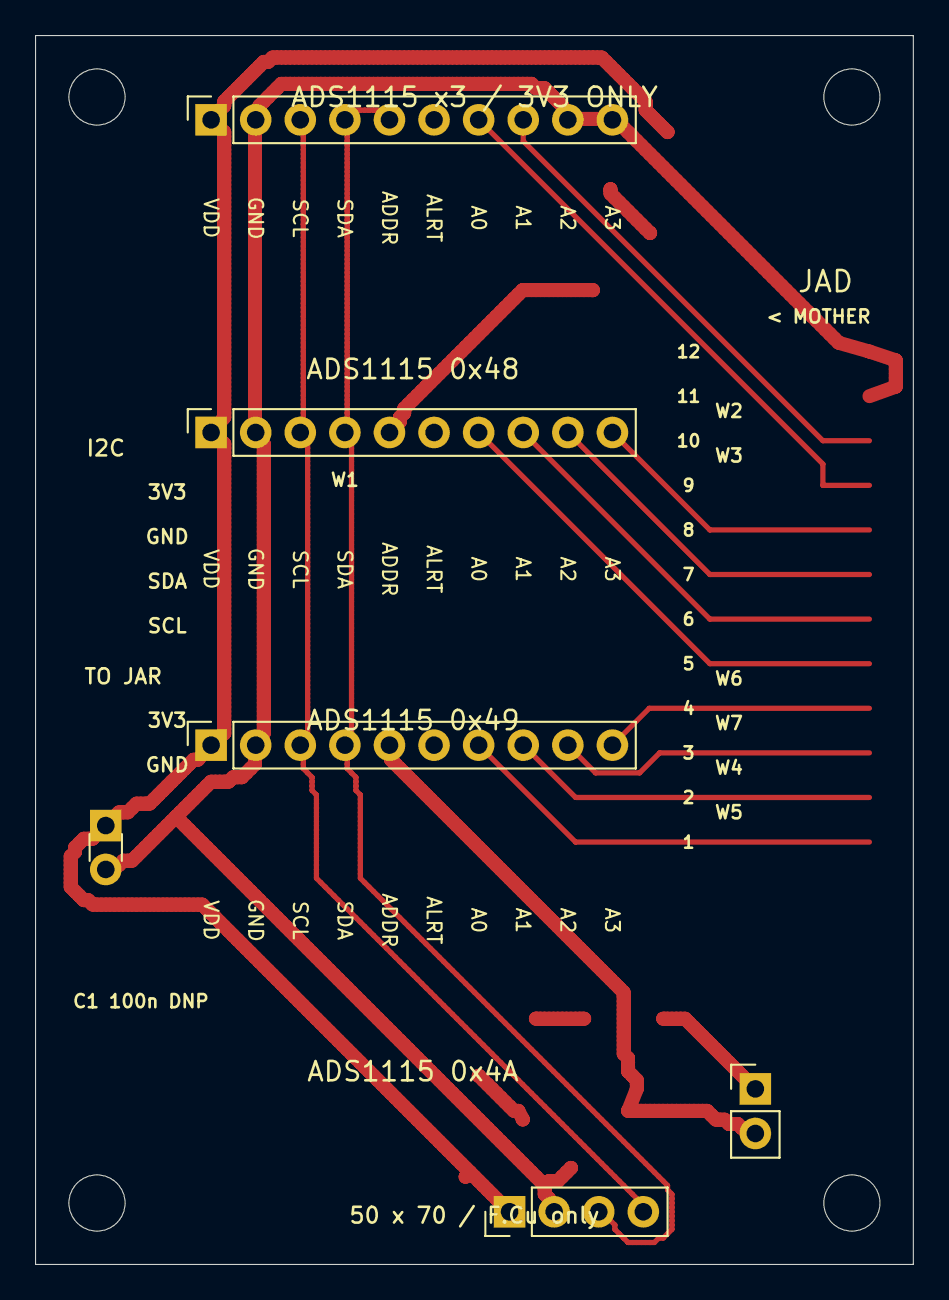
[picture p39: board targeted.kicad_pcb from below]

Board: 2 copper layers, 50.0 x 70.0 mm, 17 parts (6 on the bottom side), 20 nets.

Parts:
C1: C_Disc_D3.0mm_W1.6mm_P2.50mm
H1, H2, H3, H4: MountingHole_3.2mm_M3
JAD: Custom_1x12_Male_Edge_FCu_NOMINAL; MaleEdge_1x12_P2.54_OneFace
JAR: PinHeader_1x02_P2.54mm_Vertical
JI2C: PinHeader_1x04_P2.54mm_Vertical
JM1, JM2, JM3: PinSocket_1x10_P2.54mm_Vertical
R1, R2, R3, R4, R5, R6: 0R; R_2010_5025Metric

Connections:
3V3: R2.1, R3.2
3V3_JT1: R3.1, R4.2
3V3_JT2: C1.1, JI2C.1, JM1.1, JM2.1, JM3.1, R2.2, R5.1
3V3_JT3: JAR.1, R4.1
3V3_JT4: JM2.5, R6.2
3V3_JT5: R5.2, R6.1
ADC_0: JAD.1, JM1.7
ADC_1: JAD.2, JM1.8
ADC_2: JAD.3, JM1.9
ADC_3: JAD.4, JM1.10
ADC_4: JAD.5, JM2.7
ADC_5: JAD.6, JM2.8
ADC_6: JAD.7, JM2.9
ADC_7: JAD.8, JM2.10
ADC_8: JAD.9, JM3.7
ADC_9: JAD.10, JM3.8
GND: C1.2, JAD.11, JAD.12, JI2C.2, JM1.2, JM2.2, JM3.2, JM3.9, JM3.10, R1.2
GND_JT1: JAR.2, JM1.5, R1.1
SCL: JI2C.4, JM1.3, JM2.3, JM3.3
SDA: JI2C.3, JM1.4, JM2.4, JM3.4, JM3.5
