koboshchan/pcbai/boards/dc0/DC0_verified.kicad_pcb

## KiCad design boards/dc0/DC0_verified.kicad_pcb (2026-10-05)

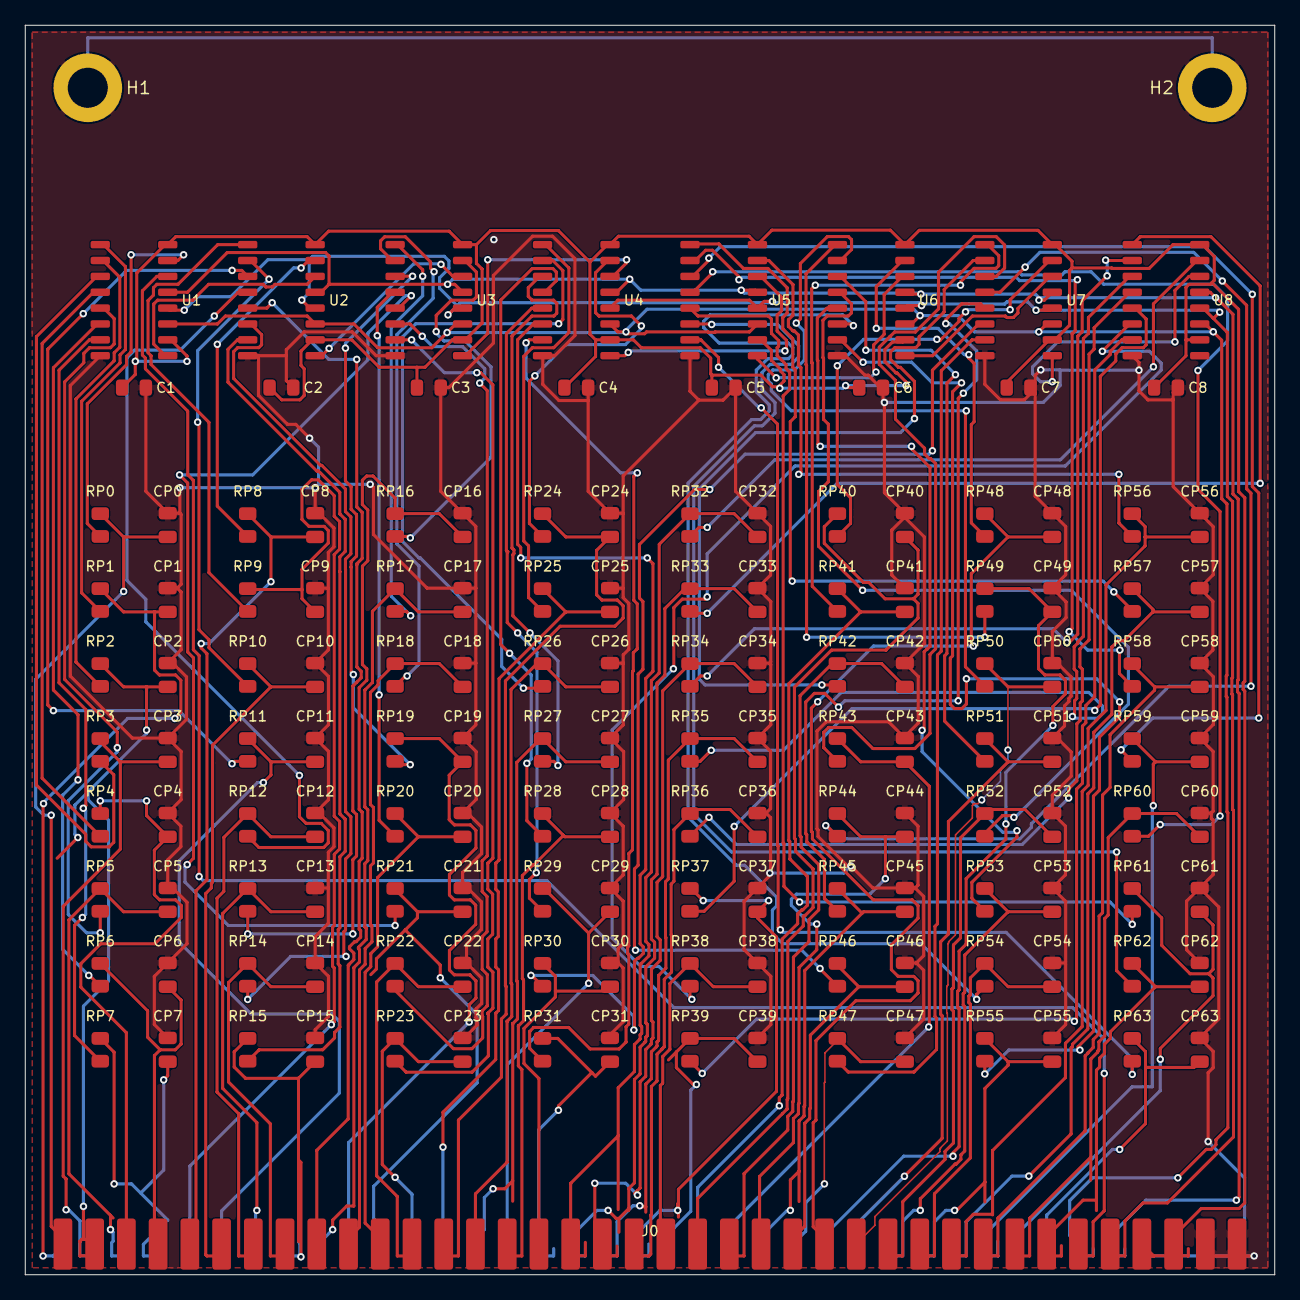
[picture p40: board DC0_verified.kicad_pcb from above]

Board: 2 copper layers, 100.0 x 100.0 mm, 147 parts (0 on the bottom side), 141 nets.

Parts:
C1, C2, C3, C4, C5, C6, C7, C8: 0.1uF; C_0805_2012Metric
CP0, CP1, CP2, CP3, CP4, CP5, CP6, CP7, CP8, CP9, CP10, CP11, CP12, CP13, CP14, CP15, CP16, CP17, CP18, CP19, CP20, CP21, CP22, CP23, CP24, CP25, CP26, CP27, CP28, CP29, CP30, CP31, CP32, CP33, CP34, CP35, CP36, CP37, CP38, CP39, CP40, CP41, CP42, CP43, CP44, CP45, CP46, CP47, CP48, CP49, CP50, CP51, CP52, CP53, CP54, CP55, CP56, CP57, CP58, CP59, CP60, CP61, CP62, CP63: 1uF; C_0805_2012Metric
H1, H2: MountingHole; MountingHole_3.2mm_M3_Pad
J0: 2x38_2.54mm_GENERIC_MANUAL_STRADDLE; Straddle2x38
RP0, RP1, RP2, RP3, RP4, RP5, RP6, RP7, RP8, RP9, RP10, RP11, RP12, RP13, RP14, RP15, RP16, RP17, RP18, RP19, RP20, RP21, RP22, RP23, RP24, RP25, RP26, RP27, RP28, RP29, RP30, RP31, RP32, RP33, RP34, RP35, RP36, RP37, RP38, RP39, RP40, RP41, RP42, RP43, RP44, RP45, RP46, RP47, RP48, RP49, RP50, RP51, RP52, RP53, RP54, RP55, RP56, RP57, RP58, RP59, RP60, RP61, RP62, RP63: 10k; R_0805_2012Metric
U1, U2, U3, U4, U5, U6, U7, U8: 74AHCT595S16-13; SOIC-16_3.9x9.9mm_P1.27mm

Connections:
+5V: C1.1, C2.1, C3.1, C4.1, C5.1, C6.1, C7.1, C8.1, J0.69, J0.71, U1.10, U1.16, U2.10, U2.16, U3.10, U3.16, U4.10, U4.16, U5.10, U5.16, U6.10, U6.16, U7.10, U7.16, U8.10, U8.16
GND: C1.2, C2.2, C3.2, C4.2, C5.2, C6.2, C7.2, C8.2, CP0.2, CP1.2, CP2.2, CP3.2, CP4.2, CP5.2, CP6.2, CP7.2, CP8.2, CP9.2, CP10.2, CP11.2, CP12.2, CP13.2, CP14.2, CP15.2, CP16.2, CP17.2, CP18.2, CP19.2, CP20.2, CP21.2, CP22.2, CP23.2, CP24.2, CP25.2, CP26.2, CP27.2, CP28.2, CP29.2, CP30.2, CP31.2, CP32.2, CP33.2, CP34.2, CP35.2, CP36.2, CP37.2, CP38.2, CP39.2, CP40.2, CP41.2, CP42.2, CP43.2, CP44.2, CP45.2, CP46.2, CP47.2, CP48.2, CP49.2, CP50.2, CP51.2, CP52.2, CP53.2, CP54.2, CP55.2, CP56.2, CP57.2, CP58.2, CP59.2, CP60.2, CP61.2, CP62.2, CP63.2, H1.1, H2.1, J0.70, J0.72, J0.73, J0.74, J0.75, J0.76, U1.8, U2.8, U3.8, U4.8, U5.8, U6.8, U7.8, U8.8
IN_0: CP0.1, J0.1, RP0.2
IN_1: CP1.1, J0.2, RP1.2
IN_2: CP2.1, J0.3, RP2.2
IN_3: CP3.1, J0.4, RP3.2
IN_4: CP4.1, J0.5, RP4.2
IN_5: CP5.1, J0.6, RP5.2
IN_6: CP6.1, J0.7, RP6.2
IN_7: CP7.1, J0.8, RP7.2
IN_8: CP8.1, J0.9, RP8.2
IN_9: CP9.1, J0.10, RP9.2
IN_10: CP10.1, J0.11, RP10.2
IN_11: CP11.1, J0.12, RP11.2
IN_12: CP12.1, J0.13, RP12.2
IN_13: CP13.1, J0.14, RP13.2
IN_14: CP14.1, J0.15, RP14.2
IN_15: CP15.1, J0.16, RP15.2
IN_16: CP16.1, J0.17, RP16.2
IN_17: CP17.1, J0.18, RP17.2
IN_18: CP18.1, J0.19, RP18.2
IN_19: CP19.1, J0.20, RP19.2
IN_20: CP20.1, J0.21, RP20.2
IN_21: CP21.1, J0.22, RP21.2
IN_22: CP22.1, J0.23, RP22.2
IN_23: CP23.1, J0.24, RP23.2
IN_24: CP24.1, J0.25, RP24.2
IN_25: CP25.1, J0.26, RP25.2
IN_26: CP26.1, J0.27, RP26.2
IN_27: CP27.1, J0.28, RP27.2
IN_28: CP28.1, J0.29, RP28.2
IN_29: CP29.1, J0.30, RP29.2
IN_30: CP30.1, J0.31, RP30.2
IN_31: CP31.1, J0.32, RP31.2
IN_32: CP32.1, J0.33, RP32.2
IN_33: CP33.1, J0.34, RP33.2
IN_34: CP34.1, J0.35, RP34.2
IN_35: CP35.1, J0.36, RP35.2
IN_36: CP36.1, J0.37, RP36.2
IN_37: CP37.1, J0.38, RP37.2
IN_38: CP38.1, J0.39, RP38.2
IN_39: CP39.1, J0.40, RP39.2
IN_40: CP40.1, J0.41, RP40.2
IN_41: CP41.1, J0.42, RP41.2
IN_42: CP42.1, J0.43, RP42.2
IN_43: CP43.1, J0.44, RP43.2
IN_44: CP44.1, J0.45, RP44.2
IN_45: CP45.1, J0.46, RP45.2
IN_46: CP46.1, J0.47, RP46.2
IN_47: CP47.1, J0.48, RP47.2
IN_48: CP48.1, J0.49, RP48.2
IN_49: CP49.1, J0.50, RP49.2
IN_50: CP50.1, J0.51, RP50.2
IN_51: CP51.1, J0.52, RP51.2
IN_52: CP52.1, J0.53, RP52.2
IN_53: CP53.1, J0.54, RP53.2
IN_54: CP54.1, J0.55, RP54.2
IN_55: CP55.1, J0.56, RP55.2
IN_56: CP56.1, J0.57, RP56.2
IN_57: CP57.1, J0.58, RP57.2
IN_58: CP58.1, J0.59, RP58.2
IN_59: CP59.1, J0.60, RP59.2
IN_60: CP60.1, J0.61, RP60.2
IN_61: CP61.1, J0.62, RP61.2
IN_62: CP62.1, J0.63, RP62.2
IN_63: CP63.1, J0.64, RP63.2
RAW_IN_0: RP0.1, U1.15
RAW_IN_1: RP1.1, U1.1
RAW_IN_2: RP2.1, U1.2
RAW_IN_3: RP3.1, U1.3
RAW_IN_4: RP4.1, U1.4
RAW_IN_5: RP5.1, U1.5
RAW_IN_6: RP6.1, U1.6
RAW_IN_7: RP7.1, U1.7
RAW_IN_8: RP8.1, U2.15
RAW_IN_9: RP9.1, U2.1
RAW_IN_10: RP10.1, U2.2
RAW_IN_11: RP11.1, U2.3
RAW_IN_12: RP12.1, U2.4
RAW_IN_13: RP13.1, U2.5
RAW_IN_14: RP14.1, U2.6
RAW_IN_15: RP15.1, U2.7
RAW_IN_16: RP16.1, U3.15
RAW_IN_17: RP17.1, U3.1
RAW_IN_18: RP18.1, U3.2
RAW_IN_19: RP19.1, U3.3
RAW_IN_20: RP20.1, U3.4
RAW_IN_21: RP21.1, U3.5
RAW_IN_22: RP22.1, U3.6
RAW_IN_23: RP23.1, U3.7
RAW_IN_24: RP24.1, U4.15
RAW_IN_25: RP25.1, U4.1
RAW_IN_26: RP26.1, U4.2
RAW_IN_27: RP27.1, U4.3
RAW_IN_28: RP28.1, U4.4
RAW_IN_29: RP29.1, U4.5
RAW_IN_30: RP30.1, U4.6
RAW_IN_31: RP31.1, U4.7
RAW_IN_32: RP32.1, U8.15
RAW_IN_33: RP33.1, U8.1
RAW_IN_34: RP34.1, U8.2
RAW_IN_35: RP35.1, U8.3
RAW_IN_36: RP36.1, U8.4
RAW_IN_37: RP37.1, U8.5
RAW_IN_38: RP38.1, U8.6
RAW_IN_39: RP39.1, U8.7
RAW_IN_40: RP40.1, U7.15
RAW_IN_41: RP41.1, U7.1
RAW_IN_42: RP42.1, U7.2
RAW_IN_43: RP43.1, U7.3
RAW_IN_44: RP44.1, U7.4
RAW_IN_45: RP45.1, U7.5
RAW_IN_46: RP46.1, U7.6
RAW_IN_47: RP47.1, U7.7
RAW_IN_48: RP48.1, U6.15
RAW_IN_49: RP49.1, U6.1
RAW_IN_50: RP50.1, U6.2
RAW_IN_51: RP51.1, U6.3
RAW_IN_52: RP52.1, U6.4
RAW_IN_53: RP53.1, U6.5
RAW_IN_54: RP54.1, U6.6
RAW_IN_55: RP55.1, U6.7
RAW_IN_56: RP56.1, U5.15
RAW_IN_57: RP57.1, U5.1
RAW_IN_58: RP58.1, U5.2
RAW_IN_59: RP59.1, U5.3
RAW_IN_60: RP60.1, U5.4
RAW_IN_61: RP61.1, U5.5
RAW_IN_62: RP62.1, U5.6
RAW_IN_63: RP63.1, U5.7
SPI_LATCH: J0.67, U1.12, U2.12, U3.12, U4.12, U5.12, U6.12, U7.12, U8.12
SPI_MOSI: J0.65, U1.14
SPI_OE: J0.68, U1.13, U2.13, U3.13, U4.13, U5.13, U6.13, U7.13, U8.13
SPI_SCK: J0.66, U1.11, U2.11, U3.11, U4.11, U5.11, U6.11, U7.11, U8.11
SR_CHAIN_1: U1.9, U2.14
SR_CHAIN_2: U2.9, U3.14
SR_CHAIN_3: U3.9, U4.14
SR_CHAIN_4: U4.9, U5.14
SR_CHAIN_5: U5.9, U6.14
SR_CHAIN_6: U6.9, U7.14
SR_CHAIN_7: U7.9, U8.14
