koboshchan/pcbai/boards/motherboard/post_crb.kicad_pcb

## KiCad design boards/motherboard/post_crb.kicad_pcb (2026-10-05)

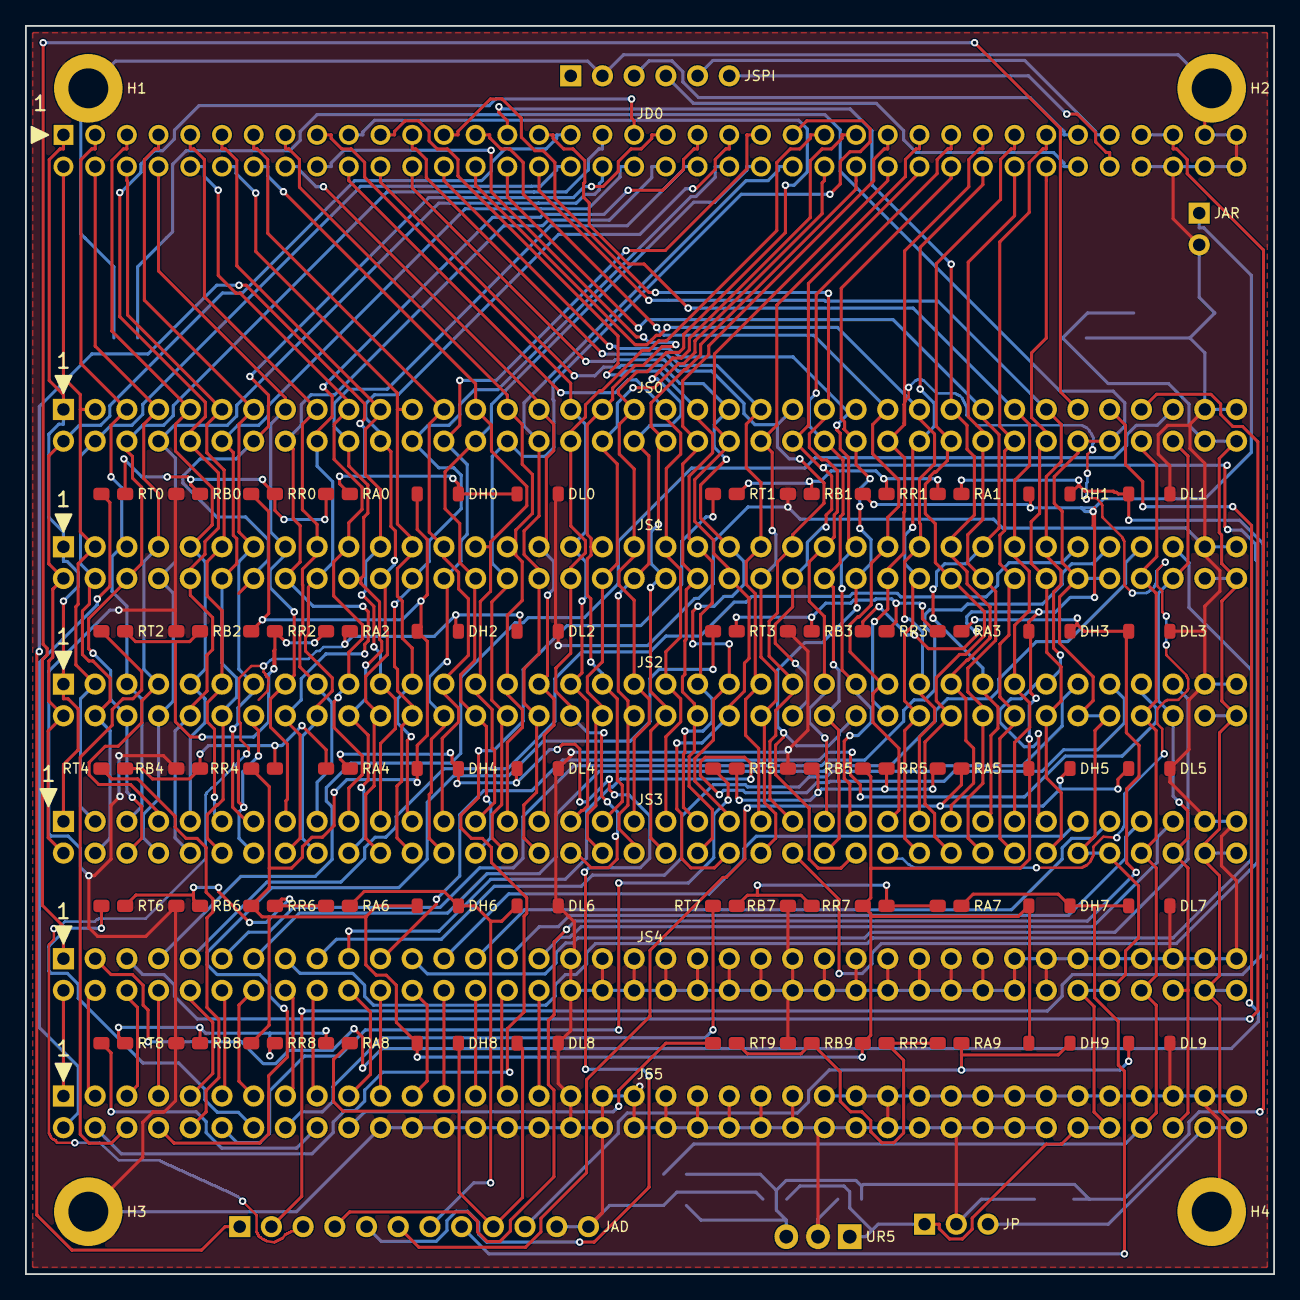
[picture p41: board post_crb.kicad_pcb from above]

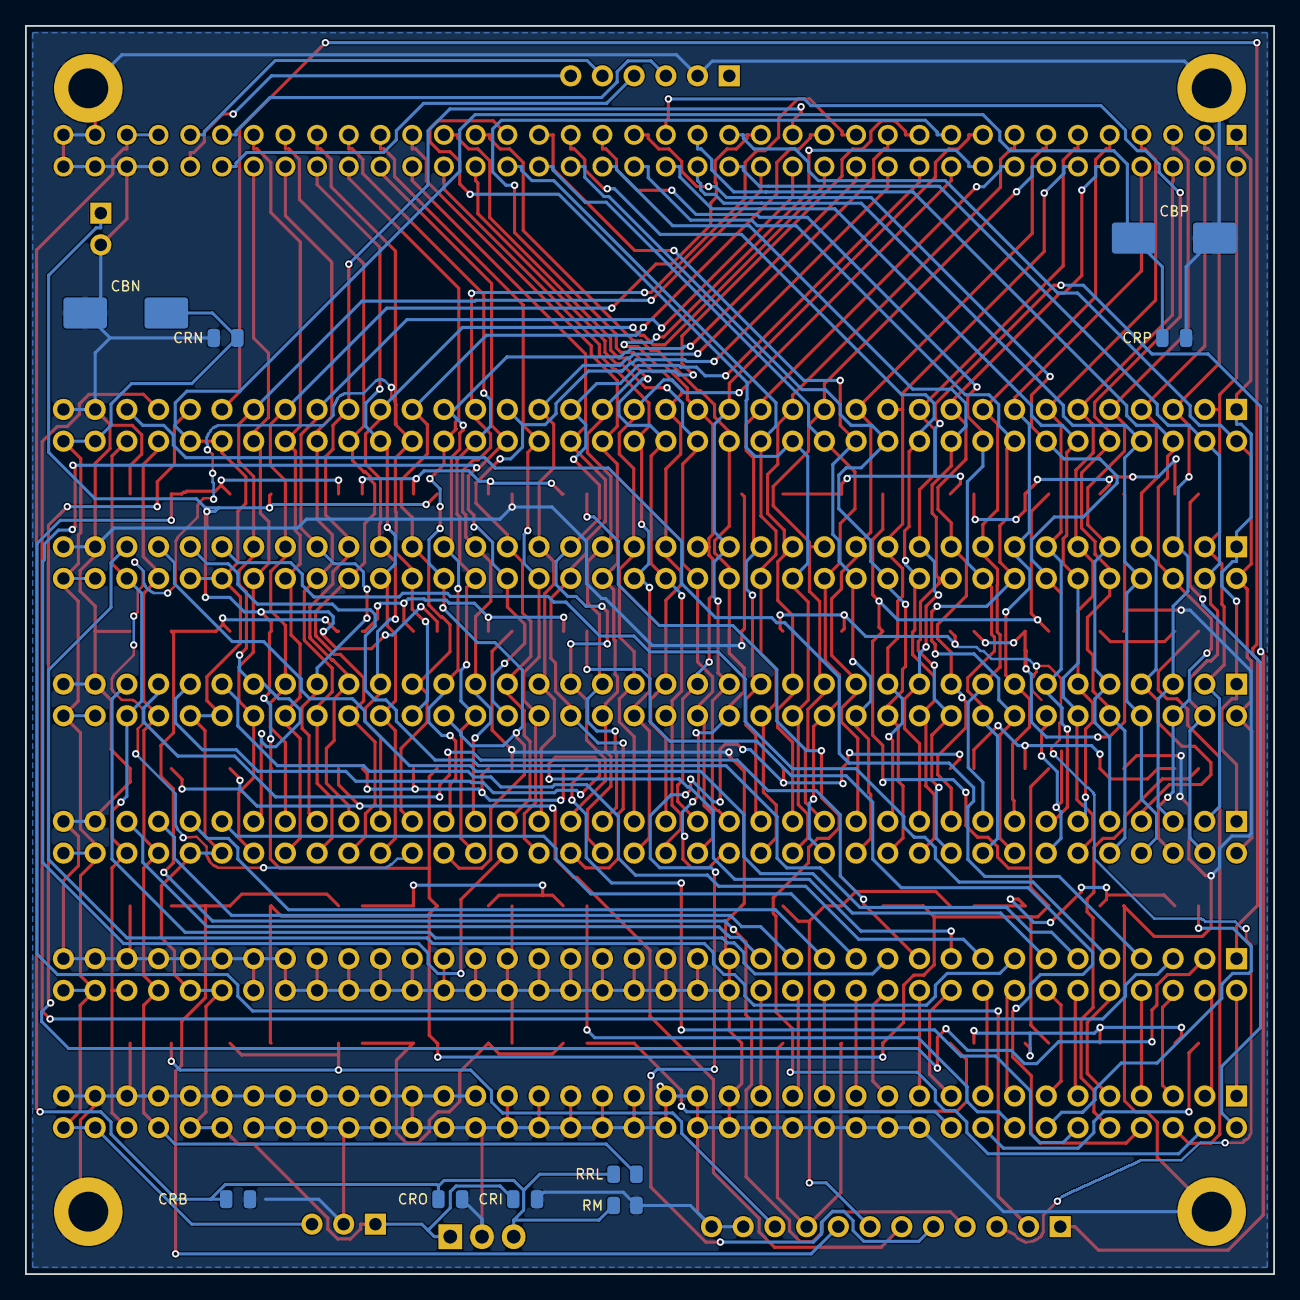
[picture p42: board post_crb.kicad_pcb from below]

Board: 2 copper layers, 100.0 x 100.0 mm, 85 parts (9 on the bottom side), 137 nets.

Parts:
CBN: 100uF; CP_Elec_8x10
CBP: 100uF; CP_Elec_8x10
CRB: 10uF; C_0805_2012Metric
CRI: 1uF; C_0805_2012Metric
CRN: 0.1uF; C_0805_2012Metric
CRO: 0.1uF; C_0805_2012Metric
CRP: 0.1uF; C_0805_2012Metric
DH0, DH1, DH2, DH3, DH4, DH5, DH6, DH7, DH8, DH9: 1N4148W; D_SOD-123
DL0, DL1, DL2, DL3, DL4, DL5, DL6, DL7, DL8, DL9: 1N4148W; D_SOD-123
H1, H2, H3, H4: MountingHole; MountingHole_3.2mm_M3_Pad
JAD: Scores_DIV_3V3_Out; PinHeader_1x12_P2.54mm_Vertical
JAR: 3V3_GND_FROM_MCU; PinHeader_1x02_P2.54mm_Vertical
JD0: 2x38_2.54mm_GENERIC_MANUAL_SOCKET; Socket2x38
JP: +15V_GND_-15V; PinHeader_1x03_P2.54mm_Vertical
JS0: Slot0: DC1A (L1 Neurons 0..3); PinSocket_2x38_P2.54mm_Vertical
JS1: Slot1: DC1B (L1 Neurons 4..7); PinSocket_2x38_P2.54mm_Vertical
JS2: Slot2: DC1C (L1 Neurons 8..11); PinSocket_2x38_P2.54mm_Vertical
JS3: Slot3: DC1D (L1 Neurons 12..15); PinSocket_2x38_P2.54mm_Vertical
JS4: Slot4: DC2 (16x Active Precision ReLU); PinSocket_2x38_P2.54mm_Vertical
JS5: Slot5: DC3 (L2 Weights + 10-Way WTA); PinSocket_2x38_P2.54mm_Vertical
JSPI: MCU_3V3_SPI_PIN1_NC; PinHeader_1x06_P2.54mm_Vertical
RA0, RA1, RA2, RA3, RA4, RA5, RA6, RA7, RA8, RA9: 1k; R_0805_2012Metric
RB0, RB1, RB2, RB3, RB4, RB5, RB6, RB7, RB8, RB9: 22k; R_0805_2012Metric
RM: 820; R_0805_2012Metric
RR0, RR1, RR2, RR3, RR4, RR5, RR6, RR7, RR8, RR9: 22k; R_0805_2012Metric
RRL: 0R; R_0805_2012Metric
RT0, RT1, RT2, RT3, RT4, RT5, RT6, RT7, RT8, RT9: 220k; R_0805_2012Metric
UR5: L7805CV; TO-220-3_Vertical

Connections:
+3V3_ADC: DH0.1, DH1.1, DH2.1, DH3.1, DH4.1, DH5.1, DH6.1, DH7.1, DH8.1, DH9.1, JAR.1, RR0.1, RR1.1, RR2.1, RR3.1, RR4.1, RR5.1, RR6.1, RR7.1, RR8.1, RR9.1
+5V: CRB.1, CRO.1, JD0.69, JD0.71, RM.1, RRL.1, UR5.3
+5V_REF: JS0.B35, JS1.B35, JS2.B35, JS3.B35, JS4.B35, JS5.B35, RRL.2
+15V: CBP.1, CRI.1, CRP.1, JP.1, JS0.B33, JS0.B34, JS1.B33, JS1.B34, JS2.B33, JS2.B34, JS3.B33, JS3.B34, JS4.B33, JS4.B34, JS5.B33, JS5.B34, UR5.1
-5V_REF: JS0.B36, JS1.B36, JS2.B36, JS3.B36, JS4.B36, JS5.B36
-15V: CBN.2, CRN.2, JP.3, JS0.B37, JS0.B38, JS1.B37, JS1.B38, JS2.B37, JS2.B38, JS3.B37, JS3.B38, JS4.B37, JS4.B38, JS5.B37, JS5.B38
ACT_0: JS4.B1, JS5.A1
ACT_1: JS4.B2, JS5.A2
ACT_2: JS4.B3, JS5.A3
ACT_3: JS4.B4, JS5.A4
ACT_4: JS4.B5, JS5.A5
ACT_5: JS4.B6, JS5.A6
ACT_6: JS4.B7, JS5.A7
ACT_7: JS4.B8, JS5.A8
ACT_8: JS4.B9, JS5.A9
ACT_9: JS4.B10, JS5.A10
ACT_10: JS4.B11, JS5.A11
ACT_11: JS4.B12, JS5.A12
ACT_12: JS4.B13, JS5.A13
ACT_13: JS4.B14, JS5.A14
ACT_14: JS4.B15, JS5.A15
ACT_15: JS4.B16, JS5.A16
ADC_0: DH0.2, DL0.1, JAD.1, RA0.2
ADC_1: DH1.2, DL1.1, JAD.2, RA1.2
ADC_2: DH2.2, DL2.1, JAD.3, RA2.2
ADC_3: DH3.2, DL3.1, JAD.4, RA3.2
ADC_4: DH4.2, DL4.1, JAD.5, RA4.2
ADC_5: DH5.2, DL5.1, JAD.6, RA5.2
ADC_6: DH6.2, DL6.1, JAD.7, RA6.2
ADC_7: DH7.2, DL7.1, JAD.8, RA7.2
ADC_8: DH8.2, DL8.1, JAD.9, RA8.2
ADC_9: DH9.2, DL9.1, JAD.10, RA9.2
GND: CBN.1, CBP.2, CRB.2, CRI.2, CRN.1, CRO.2, CRP.2, DL0.2, DL1.2, DL2.2, DL3.2, DL4.2, DL5.2, DL6.2, DL7.2, DL8.2, DL9.2, H1.1, H2.1, H3.1, H4.1, JAD.11, JAD.12, JAR.2, JD0.70, JD0.72, JD0.73, JD0.74, JD0.75, JD0.76, JP.2, JS0.A37, JS0.A38, JS1.A37, JS1.A38, JS2.A37, JS2.A38, JS3.A37, JS3.A38, JS4.A17, JS4.A18, JS4.A19, JS4.A20, JS4.A21, JS4.A22, JS4.A23, JS4.A24, JS4.A25, JS4.A26, JS4.A27, JS4.A28, JS4.A29, JS4.A30, JS4.A31, JS4.A32, JS4.A33, JS4.A34, JS4.A35, JS4.A36, JS4.A37, JS4.A38, JS4.B17, JS4.B18, JS4.B19, JS4.B20, JS4.B21, JS4.B22, JS4.B23, JS4.B24, JS4.B25, JS4.B26, JS4.B27, JS4.B28, JS4.B29, JS4.B30, JS4.B31, JS4.B32, JS5.A17, JS5.A18, JS5.A19, JS5.A20, JS5.A21, JS5.A22, JS5.A23, JS5.A24, JS5.A25, JS5.A26, JS5.A27, JS5.A28, JS5.A29, JS5.A30, JS5.A31, JS5.A32, JS5.A33, JS5.A34, JS5.A35, JS5.A36, JS5.A37, JS5.A38, JS5.B11, JS5.B12, JS5.B13, JS5.B14, JS5.B15, JS5.B16, JS5.B17, JS5.B18, JS5.B19, JS5.B20, JS5.B21, JS5.B22, JS5.B23, JS5.B24, JS5.B25, JS5.B26, JS5.B27, JS5.B28, JS5.B29, JS5.B30, JS5.B31, JS5.B32, JSPI.2, RB0.1, RB1.1, RB2.1, RB3.1, RB4.1, RB5.1, RB6.1, RB7.1, RB8.1, RB9.1, RM.2, UR5.2
IN_0: JD0.1, JS0.A1, JS1.A1, JS2.A1, JS3.A1
IN_1: JD0.2, JS0.A2, JS1.A2, JS2.A2, JS3.A2
IN_2: JD0.3, JS0.A3, JS1.A3, JS2.A3, JS3.A3
IN_3: JD0.4, JS0.A4, JS1.A4, JS2.A4, JS3.A4
IN_4: JD0.5, JS0.A5, JS1.A5, JS2.A5, JS3.A5
IN_5: JD0.6, JS0.A6, JS1.A6, JS2.A6, JS3.A6
IN_6: JD0.7, JS0.A7, JS1.A7, JS2.A7, JS3.A7
IN_7: JD0.8, JS0.A8, JS1.A8, JS2.A8, JS3.A8
IN_8: JD0.9, JS0.A9, JS1.A9, JS2.A9, JS3.A9
IN_9: JD0.10, JS0.A10, JS1.A10, JS2.A10, JS3.A10
IN_10: JD0.11, JS0.A11, JS1.A11, JS2.A11, JS3.A11
IN_11: JD0.12, JS0.A12, JS1.A12, JS2.A12, JS3.A12
IN_12: JD0.13, JS0.A13, JS1.A13, JS2.A13, JS3.A13
IN_13: JD0.14, JS0.A14, JS1.A14, JS2.A14, JS3.A14
IN_14: JD0.15, JS0.A15, JS1.A15, JS2.A15, JS3.A15
IN_15: JD0.16, JS0.A16, JS1.A16, JS2.A16, JS3.A16
IN_16: JD0.17, JS0.A17, JS1.A17, JS2.A17, JS3.A17
IN_17: JD0.18, JS0.A18, JS1.A18, JS2.A18, JS3.A18
IN_18: JD0.19, JS0.A19, JS1.A19, JS2.A19, JS3.A19
IN_19: JD0.20, JS0.A20, JS1.A20, JS2.A20, JS3.A20
IN_20: JD0.21, JS0.A21, JS1.A21, JS2.A21, JS3.A21
IN_21: JD0.22, JS0.A22, JS1.A22, JS2.A22, JS3.A22
IN_22: JD0.23, JS0.A23, JS1.A23, JS2.A23, JS3.A23
IN_23: JD0.24, JS0.A24, JS1.A24, JS2.A24, JS3.A24
IN_24: JD0.25, JS0.A25, JS1.A25, JS2.A25, JS3.A25
IN_25: JD0.26, JS0.A26, JS1.A26, JS2.A26, JS3.A26
IN_26: JD0.27, JS0.A27, JS1.A27, JS2.A27, JS3.A27
IN_27: JD0.28, JS0.A28, JS1.A28, JS2.A28, JS3.A28
IN_28: JD0.29, JS0.A29, JS1.A29, JS2.A29, JS3.A29
IN_29: JD0.30, JS0.A30, JS1.A30, JS2.A30, JS3.A30
IN_30: JD0.31, JS0.A31, JS1.A31, JS2.A31, JS3.A31
IN_31: JD0.32, JS0.A32, JS1.A32, JS2.A32, JS3.A32
IN_32: JD0.33, JS0.B1, JS1.B1, JS2.B1, JS3.B1
IN_33: JD0.34, JS0.B2, JS1.B2, JS2.B2, JS3.B2
IN_34: JD0.35, JS0.B3, JS1.B3, JS2.B3, JS3.B3
IN_35: JD0.36, JS0.B4, JS1.B4, JS2.B4, JS3.B4
IN_36: JD0.37, JS0.B5, JS1.B5, JS2.B5, JS3.B5
IN_37: JD0.38, JS0.B6, JS1.B6, JS2.B6, JS3.B6
IN_38: JD0.39, JS0.B7, JS1.B7, JS2.B7, JS3.B7
IN_39: JD0.40, JS0.B8, JS1.B8, JS2.B8, JS3.B8
IN_40: JD0.41, JS0.B9, JS1.B9, JS2.B9, JS3.B9
IN_41: JD0.42, JS0.B10, JS1.B10, JS2.B10, JS3.B10
IN_42: JD0.43, JS0.B11, JS1.B11, JS2.B11, JS3.B11
IN_43: JD0.44, JS0.B12, JS1.B12, JS2.B12, JS3.B12
IN_44: JD0.45, JS0.B13, JS1.B13, JS2.B13, JS3.B13
IN_45: JD0.46, JS0.B14, JS1.B14, JS2.B14, JS3.B14
IN_46: JD0.47, JS0.B15, JS1.B15, JS2.B15, JS3.B15
IN_47: JD0.48, JS0.B16, JS1.B16, JS2.B16, JS3.B16
IN_48: JD0.49, JS0.B17, JS1.B17, JS2.B17, JS3.B17
IN_49: JD0.50, JS0.B18, JS1.B18, JS2.B18, JS3.B18
IN_50: JD0.51, JS0.B19, JS1.B19, JS2.B19, JS3.B19
IN_51: JD0.52, JS0.B20, JS1.B20, JS2.B20, JS3.B20
IN_52: JD0.53, JS0.B21, JS1.B21, JS2.B21, JS3.B21
IN_53: JD0.54, JS0.B22, JS1.B22, JS2.B22, JS3.B22
IN_54: JD0.55, JS0.B23, JS1.B23, JS2.B23, JS3.B23
IN_55: JD0.56, JS0.B24, JS1.B24, JS2.B24, JS3.B24
IN_56: JD0.57, JS0.B25, JS1.B25, JS2.B25, JS3.B25
IN_57: JD0.58, JS0.B26, JS1.B26, JS2.B26, JS3.B26
IN_58: JD0.59, JS0.B27, JS1.B27, JS2.B27, JS3.B27
IN_59: JD0.60, JS0.B28, JS1.B28, JS2.B28, JS3.B28
IN_60: JD0.61, JS0.B29, JS1.B29, JS2.B29, JS3.B29
IN_61: JD0.62, JS0.B30, JS1.B30, JS2.B30, JS3.B30
IN_62: JD0.63, JS0.B31, JS1.B31, JS2.B31, JS3.B31
IN_63: JD0.64, JS0.B32, JS1.B32, JS2.B32, JS3.B32
SCORE_0: JS5.B1, RT0.1
SCORE_1: JS5.B2, RT1.1
SCORE_2: JS5.B3, RT2.1
SCORE_3: JS5.B4, RT3.1
SCORE_4: JS5.B5, RT4.1
SCORE_5: JS5.B6, RT5.1
SCORE_6: JS5.B7, RT6.1
SCORE_7: JS5.B8, RT7.1
SCORE_8: JS5.B9, RT8.1
SCORE_9: JS5.B10, RT9.1
SCORE_DIV_0: RA0.1, RB0.2, RR0.2, RT0.2
SCORE_DIV_1: RA1.1, RB1.2, RR1.2, RT1.2
SCORE_DIV_2: RA2.1, RB2.2, RR2.2, RT2.2
SCORE_DIV_3: RA3.1, RB3.2, RR3.2, RT3.2
SCORE_DIV_4: RA4.1, RB4.2, RR4.2, RT4.2
SCORE_DIV_5: RA5.1, RB5.2, RR5.2, RT5.2
SCORE_DIV_6: RA6.1, RB6.2, RR6.2, RT6.2
SCORE_DIV_7: RA7.1, RB7.2, RR7.2, RT7.2
SCORE_DIV_8: RA8.1, RB8.2, RR8.2, RT8.2
SCORE_DIV_9: RA9.1, RB9.2, RR9.2, RT9.2
SPI_LATCH: JD0.67, JSPI.5
SPI_MOSI: JD0.65, JSPI.3
SPI_OE: JD0.68, JSPI.6
SPI_SCK: JD0.66, JSPI.4
V_SUM_0: JS0.A33, JS4.A1
V_SUM_1: JS0.A34, JS4.A2
V_SUM_2: JS0.A35, JS4.A3
V_SUM_3: JS0.A36, JS4.A4
V_SUM_4: JS1.A33, JS4.A5
V_SUM_5: JS1.A34, JS4.A6
V_SUM_6: JS1.A35, JS4.A7
V_SUM_7: JS1.A36, JS4.A8
V_SUM_8: JS2.A33, JS4.A9
V_SUM_9: JS2.A34, JS4.A10
V_SUM_10: JS2.A35, JS4.A11
V_SUM_11: JS2.A36, JS4.A12
V_SUM_12: JS3.A33, JS4.A13
V_SUM_13: JS3.A34, JS4.A14
V_SUM_14: JS3.A35, JS4.A15
V_SUM_15: JS3.A36, JS4.A16
