koboshchan/pcbai/(commit log)

2026-09-21 feat: complete 7-PCB discrete analog MNIST neural network system with 0-DRC boards and direct pin emulator
    [bom_consolidated.csv, bom_summary.csv, consolidated_system_bom.csv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]
2026-10-02 feat(test-board): autoroute 70x100mm single-layer test board with FreeRouting and 10 wire jumpers
    - Route 70x100mm analog neural network test board strictly on F.Cu single layer (0 B.Cu tracks, 0 vias)
    - Enforce >=0.300mm trace width and >=0.500mm clearance via FreeRouting DSN/SES
    - Add 10 through-hole wire jumper hole pairs (W1-W10, 1.0mm drill, 2.0mm pad) on F.Cu for planar crossings
    - Verify complete connectivity and zero errors (0 DRC violations, 0 unconnected items)
    - Clean up intermediate/scratch routing files and update EDA .gitignore
    [daughtercard1a_weights_l1.kicad_pcb, daughtercard1b_weights_l1.kicad_pcb, daughtercard1c_weights_l1.kicad_pcb, daughtercard1d_weights_l1.kicad_pcb, daughtercard2_relu_l1.kicad_pcb, daughtercard3_weights_l2_wta.kicad_pcb, full_system_assembly.kicad_pcb, motherboard.kicad_pcb]
2026-10-03 feat: add shifter_board 4-channel ±15V to 0-5V level shifter (single layer F.Cu, 0 DRC violations, 0 unconnected)
    [shifter_board.kicad_pcb]
2026-10-03 feat(shifter_board): generate 1:1 true-scale mirrored photoresist masks for US letter size (negative cu, solder mask, negative silkscreen)
    [shifter_board.kicad_pcb]
2026-10-04 Prepare two copper layer boards with strict JLC-compatible routing rules
2026-10-04 Move CAD pipeline to kat-box and retain baseline full DRC report
2026-10-04 Add independent frozen pin-net audit and original emulator findings
2026-10-04 Use ownership-safe KiCad deletion for remote routing preparation
2026-10-04 Pause obsolete straddle-board conversion and checkpoint non-deliverable trials
    [daughtercard1a_weights_l1_unrouted.kicad_pcb, daughtercard1b_weights_l1_unrouted.kicad_pcb, daughtercard1c_weights_l1_unrouted.kicad_pcb, daughtercard1d_weights_l1_unrouted.kicad_pcb, daughtercard2_relu_l1_unrouted.kicad_pcb, daughtercard3_weights_l2_wta_unrouted.kicad_pcb, motherboard_unrouted.kicad_pcb]
2026-10-04 Resume current straddle-board conversion without electrical modifications
2026-10-04 Clarify resumed kat-box execution and unchanged-circuit authorization
2026-10-04 Test KiCad10 reference silk helper and report motherboard packing blockers
2026-10-04 Implement isolated bipolar ADC offset circuit and conservative tolerance audit
    [motherboard_adc_repaired_unrouted.kicad_pcb]
2026-10-04 Add binary MNIST conductance QAT and physical ADC corner checks
2026-10-04 renders: ADC milestone top/bottom provisional previews
2026-10-04 Prototype physical signed-group inverters with full 1184-path pin-net audit
    [daughtercard1a_weights_l1_signed_prototype_unrouted.kicad_pcb, daughtercard1b_weights_l1_signed_prototype_unrouted.kicad_pcb, daughtercard1c_weights_l1_signed_prototype_unrouted.kicad_pcb, daughtercard1d_weights_l1_signed_prototype_unrouted.kicad_pcb, daughtercard3_weights_l2_wta_signed_prototype_unrouted.kicad_pcb]
2026-10-04 Use standard SOD123 and reference header geometry with physical ADC pin audit
    [motherboard_adc_repaired_unrouted.kicad_pcb]
2026-10-04 Record final per-board fabrication quote specifications and export handoff
2026-10-04 Integrate trained differential physical netlists buffered ReLU and HCT logic repair
    [daughtercard1a_weights_l1_differential_repaired_unrouted.kicad_pcb, daughtercard1b_weights_l1_differential_repaired_unrouted.kicad_pcb, daughtercard1c_weights_l1_differential_repaired_unrouted.kicad_pcb, daughtercard1d_weights_l1_differential_repaired_unrouted.kicad_pcb, daughtercard2_relu_l1_buffered_repaired_unrouted.kicad_pcb, daughtercard3_weights_l2_wta_differential_repaired_unrouted.kicad_p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]
2026-10-04 Complete CUDA physical 1000-board MC and repair trained CAD references
2026-10-04 Checkpoint recessed straddle lands and binary routing feasibility pending grayscale
    [daughtercard1a_weights_l1_differential_repaired.kicad_pcb, daughtercard1a_weights_l1_differential_repaired_unrouted.kicad_pcb, daughtercard1b_weights_l1_differential_repaired.kicad_pcb, daughtercard1b_weights_l1_differential_repaired_unrouted.kicad_pcb, daughtercard1c_weights_l1_differential_repaired.kicad_pcb, daughtercard1c_weights_l1_differential_repaired_unrouted.kicad_pcb, daughtercard1d_wei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]
2026-10-04 Integrate 64 grayscale RC filters and isolated final motherboard power inputs
    [motherboard_adc_repaired_unrouted.kicad_pcb]
2026-10-04 Specify 50V daughtercard decoupling capacitors for fifteen volt rails
2026-10-04 Use verified KiCad ten field API for capacitor voltage specification
2026-10-04 Generate grayscale trained resistor CAD and clean daughtercard placement
    [daughtercard1a_weights_l1_differential_repaired_unrouted.kicad_pcb, daughtercard1b_weights_l1_differential_repaired_unrouted.kicad_pcb, daughtercard1c_weights_l1_differential_repaired_unrouted.kicad_pcb, daughtercard1d_weights_l1_differential_repaired_unrouted.kicad_pcb, daughtercard2_relu_l1_buffered_repaired_unrouted.kicad_pcb, daughtercard3_weights_l2_wta_differential_repaired_unrouted.kicad_p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]
2026-10-04 Train loaded grayscale6bit PWM MNIST with CUDA1000 and coupled RC ripple audit
2026-10-04 Apply requested point four millimeter pad setback and final power requirements
2026-10-04 Integrate onboard 5V linear supply and audit mandatory heatsink budget
    [motherboard_adc_repaired_unrouted.kicad_pcb]
2026-10-04 Independently validate grayscale trained resistor and opamp pad topology
2026-10-04 Checkpoint six grayscale daughtercards with zero DRC errors and opens
    [daughtercard1a_weights_l1_differential_repaired.kicad_pcb, daughtercard1a_weights_l1_differential_repaired_unrouted.kicad_pcb, daughtercard1b_weights_l1_differential_repaired.kicad_pcb, daughtercard1b_weights_l1_differential_repaired_unrouted.kicad_pcb, daughtercard1c_weights_l1_differential_repaired.kicad_pcb, daughtercard1c_weights_l1_differential_repaired_unrouted.kicad_pcb, daughtercard1d_wei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]
2026-10-04 Clarify routed render audit passes authorized fifteen volt rail rename
2026-10-04 Hide capacitor voltage field; reference-only silk on DC1a-d and DC2; DC3 silk blocked
    [daughtercard1a_weights_l1_differential_repaired.kicad_pcb, daughtercard1b_weights_l1_differential_repaired.kicad_pcb, daughtercard1c_weights_l1_differential_repaired.kicad_pcb, daughtercard1d_weights_l1_differential_repaired.kicad_pcb, daughtercard2_relu_l1_buffered_repaired.kicad_pcb, daughtercard2_relu_l1_buffered_unrouted.kicad_pcb]
2026-10-04 Record authoritative routed daughtercards and onboard power release gates
2026-10-04 Align published balance references with placed CAD and audit both snapshots
2026-10-04 Correct AHCT shared-regulator model metadata and completed nominal MC status
2026-10-04 Correct BCM power frequency and audit AHCT drive and purchasing gates
    [power_BOM_preliminary.csv]
2026-10-04 Audit common 5V rail and AHCT output diagnostics with full coupled CUDA KCL
2026-10-04 renders: populated 3D DC1a/DC1c (KiCad10 models)
2026-10-04 Record hand-installed aluminum heatsink without reopening routing gate
2026-10-04 Reserve optional coin clearance and start motherboard routing with conservative clock limits
    [motherboard_adc_repaired_unrouted.kicad_pcb, power_BOM_preliminary.csv]
2026-10-04 Refresh AHCT model-to-CAD audit and quantify bounded ADC class margins
2026-10-04 Keep power audit regulator pose synchronized with coin placement
2026-10-04 Carry final aluminum heatsink choice into clearance and thermal documentation
2026-10-04 Align power handoff with final manual aluminum cooling choice
2026-10-04 DC3 silk 0.8mm overlap preview renders (temp copy, board unchanged)
2026-10-04 Apply approved AHCT same-package sourcing and manual assembly fallback
    [power_BOM_preliminary.csv]
2026-10-04 renders: corrected 2x38 straddle header model + DC1a/DC1c renders, fit audit (0.12mm gap flagged)
2026-10-04 Document stocked SO-16 AHCT595 assembly option
2026-10-04 Spread DC3 weight columns for readable references and strictly gate reroute
    [daughtercard3_weights_l2_wta_differential_repaired.kicad_pcb, daughtercard3_weights_l2_wta_differential_repaired_unrouted.kicad_pcb, dc3.kicad_pcb, dc3_unrouted.kicad_pcb, stitch.kicad_pcb]
2026-10-04 Record validated DC3 and approved Diodes AHCT assembly decision
2026-10-04 Select approved Diodes AHCT SMT sourcing without PCB edits
    [daughtercard1a_weights_l1_differential_repaired_full_bom.csv, daughtercard1b_weights_l1_differential_repaired_full_bom.csv, daughtercard1c_weights_l1_differential_repaired_full_bom.csv, daughtercard1d_weights_l1_differential_repaired_full_bom.csv, daughtercard2_relu_l1_buffered_repaired_full_bom.csv, daughtercard3_weights_l2_wta_differential_repaired_full_bom.csv, motherboard_adc_repaired_unroute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]
2026-10-04 Document Basic 1uF regulator input bypass selection and handoff
2026-10-04 Apply approved Basic 1uF input bypass to purchasing inventories
    [motherboard_adc_repaired_unrouted_full_bom.csv, power_BOM_preliminary.csv]
2026-10-04 Document current whole BOM stock evidence and unresolved qualifications
2026-10-04 Classify Economic assembly sides and separate manual SMD BOMs
2026-10-04 Audit daughtercard single-side Economic assembly without CAD changes
2026-10-04 Move eight AHCT drivers to bottom for Economic PCBA and audit readable motherboard silk
    [motherboard_adc_repaired_unrouted.kicad_pcb]
2026-10-04 Document exact manual assembly exclusions and PWM label association caveat
2026-10-04 Move eight AHCT bypass caps to Economic bottom assembly
    [motherboard_adc_repaired_unrouted.kicad_pcb]
2026-10-04 Save honest four-pass motherboard routing checkpoint with 202 opens
    [motherboard_adc_repaired.kicad_pcb, motherboard_adc_repaired_routed_copper.kicad_pcb]
2026-10-04 Retire Economic geometry jobs and guard restored hybrid routing ownership
    [motherboard_adc_repaired.kicad_pcb, motherboard_adc_repaired_unrouted.kicad_pcb]
2026-10-04 Fit full adjacent motherboard PWM references with exact KiCad glyph collision audits
2026-10-04 Restore approved hybrid placement with adjacent exact-glyph silk and fresh routing guard
    [motherboard_adc_repaired_unrouted.kicad_pcb]
2026-10-04 Preserve reversible short motherboard references and UUID-anchored manual sourcing
    [motherboard_adc_repaired_unrouted.kicad_pcb]
2026-10-04 Isolate pre-Economic motherboard restore with reversible short references and strict audits
    [daughtercard1a_weights_l1.kicad_pcb, daughtercard1a_weights_l1_differential_repaired.kicad_pcb, daughtercard1a_weights_l1_differential_repaired_unrouted.kicad_pcb, daughtercard1a_weights_l1_signed_prototype_unrouted.kicad_pcb, daughtercard1b_weights_l1.kicad_pcb, daughtercard1b_weights_l1_differential_repaired.kicad_pcb, daughtercard1b_weights_l1_differential_repaired_unrouted.kicad_pcb, daughter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]
2026-10-04 Stage UUID-safe hybrid inventory and guarded final promotion without touching authority
2026-10-04 Prepare gated final motherboard promotion and manual AHCT source overlay
    [power_BOM_preliminary.csv]
2026-10-04 Add isolated strict-audited optional ground-plane copper repair
2026-10-04 Avoid KiCad SWIG ownership corruption during isolated copper removal
2026-10-04 Audit isolated daughtercard ground pours with strict edge gate
    [candidate.kicad_pcb, ground_candidate.kicad_pcb, source.kicad_pcb]
2026-10-04 Add isolated compact DC0 PWM split with strict identity and edge gates
    [DC0.kicad_pcb, motherboard.kicad_pcb]
2026-10-04 Validate six poured daughters with scoped approved straddle pad edge rules
    [exception_disabled.kicad_pcb, exception_threshold_0p41.kicad_pcb, ground_candidate.kicad_pcb, ordinary_pad_at_0p4.kicad_pcb, selected_pad_at_0p35.kicad_pcb, source.kicad_pcb, track_at_0p4.kicad_pcb, via_at_0p4.kicad_pcb]
2026-10-04 Restore exact split placement after session rounding and stage mother recovery
2026-10-04 Publish Basic-only MNIST candidate and full physical tolerance audit
    [value_changes.csv]
2026-10-04 Retain KiCad SWIG objects during isolated net reroute
2026-10-04 Probe narrower gap candidates while retaining strict rejection
2026-10-04 Search both track endpoints for motherboard gap repairs
2026-10-04 Probe existing net copper endpoints for legal gap connection
2026-10-04 Record isolated motherboard thermal repair with two unresolved opens
    [motherboard.kicad_pcb]
2026-10-04 Refine isolated blocker paths and KiCad ownership API compatibility
2026-10-04 Restore three original blocker tracks and repair only new ADC crossings
2026-10-04 Evidence five local ADC corridor blockers and preserve fixed surrounding copper
2026-10-04 Restore IN8 IN39 and reroute only new ADC geometry from scratch
2026-10-04 Evidence narrow last ADC path and scoped endpoint blocker restoration
2026-10-04 Fix exact ADC pad clearances and free only IN38 local PTH access
2026-10-04 Revert "Merge remote-tracking branch 'origin/main'"
    This reverts commit c20a01fb0e2551ae4f96ba645d9eef5b7a0d5011, reversing
    changes made to bfab53ef6a35c9d15fb6830a83d2a76e0756ae9c.
    [DC0.kicad_pcb, candidate.kicad_pcb, daughtercard1a_weights_l1.kicad_pcb, daughtercard1a_weights_l1_differential_repaired.kicad_pcb, daughtercard1a_weights_l1_differential_repaired_full_bom.csv, daughtercard1a_weights_l1_differential_repaired_unrouted.kicad_pcb, daughtercard1a_weights_l1_signed_prototype_unrouted.kicad_pcb, daughtercard1a_weights_l1_unrouted.kicad_pcb]
2026-10-04 Reapply "Merge remote-tracking branch 'origin/main'"
    This reverts commit a03d1cfbcb5e47f4b8e0ed5a0dcfd4ea13677785.
    [DC0.kicad_pcb, candidate.kicad_pcb, daughtercard1a_weights_l1.kicad_pcb, daughtercard1a_weights_l1_differential_repaired.kicad_pcb, daughtercard1a_weights_l1_differential_repaired_full_bom.csv, daughtercard1a_weights_l1_differential_repaired_unrouted.kicad_pcb, daughtercard1a_weights_l1_signed_prototype_unrouted.kicad_pcb, daughtercard1a_weights_l1_unrouted.kicad_pcb]
2026-10-04 Revert "Merge remote-tracking branch 'origin/main'"
    changes made to 4a93a5ac8ef35cab4c483374c944251f6a9b9f03.
    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
    [daughtercard1a_weights_l1.kicad_pcb, daughtercard1b_weights_l1.kicad_pcb, daughtercard1c_weights_l1.kicad_pcb, daughtercard1d_weights_l1.kicad_pcb, daughtercard2_relu_l1.kicad_pcb, daughtercard2_relu_l1_500.kicad_pcb, daughtercard2_relu_l1_clean_routed.kicad_pcb, daughtercard2_relu_l1_fixed_w.kicad_pcb]
2026-10-04 Document approved IN38 assembly bodge and audit isolated CRB ceramic change
    [DC0_verified.kicad_pcb, candidate_BOM.csv, post_crb.kicad_pcb, pre_crb.kicad_pcb]
2026-10-04 Retain raw strict DRC logs and portable frozen-footprint audit
2026-10-04 Add PCB-only copper connectivity extractor and physical-layer tests
2026-10-04 Handle KiCad 10 layer sets and footprint string conversion
2026-10-04 Remove emulator code (moved to koboshchan/pcb-emu)
2026-10-04 Add single-sided ADS1115 carrier and photoresist Letter mask
    [ads1115_breakout.kicad_pcb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]
2026-10-04 Document carrier wire links and single-layer export verification
2026-10-04 Flip THT assembly to B side and verify outward JAD pin mapping
    [ads1115_breakout.kicad_pcb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]
2026-10-04 Add verified top and B-side assembly renders for ADS carrier
2026-10-05 silk: orientation marks
    [DC0_verified.kicad_pcb, daughtercard1a_weights_l1_differential_repaired.kicad_pcb, daughtercard1b_weights_l1_differential_repaired.kicad_pcb, daughtercard1c_weights_l1_differential_repaired.kicad_pcb, daughtercard1d_weights_l1_differential_repaired.kicad_pcb, daughtercard2_relu_l1_buffered_repaired.kicad_pcb, daughtercard3_weights_l2_wta_differential_repaired.kicad_pcb, post_crb.kicad_pcb]
2026-10-05 Add approved four-layer DC1 universal board and validation
    [DC1a.csv, DC1b.csv, DC1c.csv, DC1d.csv, board.kicad_pcb]
2026-10-05 Add ADS carrier v3: strict DRC 0 errors/0 opens, six top-side 2010 jumpers, etch PDF
    [targeted.kicad_pcb]
2026-10-05 Remove superseded boards, routing trials and stale deliverables
    [DC0.kicad_pcb, DC0_verified.kicad_pcb, DC1a.csv, DC1b.csv, DC1c.csv, DC1d.csv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]
2026-10-05 Add exact paid v2 boards, fabrication ZIPs and ADS carrier v3
    [DC0_verified.kicad_pcb, DC1a.csv, DC1b.csv, DC1c.csv, DC1d.csv, board.kicad_pcb, daughtercard2_relu_l1_buffered_repaired.kicad_pcb, dc3_universal.kicad_pcb]
2026-10-05 Organize training and current export, overlay and emulator scripts
    [value_changes.csv]
2026-10-05 Keep current assembly PDFs, BOM inputs and final PCB renders
    [DC0_v2.csv, DC0_v2_grouped.csv, DC1a.csv, DC1a_grouped.csv, DC1b.csv, DC1b_grouped.csv, DC1c.csv, DC1c_grouped.csv]
2026-10-05 Document clean layout and current workflows; ignore generated artifacts
2026-10-09 Add isolated universal DC1 topology and exact four-card population manifests
    [DC1a.csv, DC1b.csv, DC1c.csv, DC1d.csv, dc1_universal_unrouted.kicad_pcb]
2026-10-09 Add per-card hand-solder population charts
2026-10-09 Enforce two-layer hand-solder track and via dimensions on release
2026-10-09 Complete universal DC1 with all 532 future-model resistor sites
    [DC1a.csv, DC1b.csv, DC1c.csv, DC1d.csv, dc1_universal_unrouted.kicad_pcb]
2026-10-09 Expand hand-solder population charts to all 532 sites
2026-10-20 Add RAM-loaded Pico controller for the paid MNIST stack
    Drive the actual nonmonotonic DC0 register chain with continuously replayed six-bit pulse-density frames using PIO and chained DMA. Keep OE disabled until a full frame is latched, read ten mapped ADC channels with conversion-ready timeouts, and disable outputs on errors and session exit.
    Use existing MicroPython and pyserial without replacing device files. The Mac raw-REPL scan and 100 ms zero-input measurement succeeded on the physical Pico; USB disconnected before single-pixel qualification. Python compilation and six encoding tests pass, including all 64 walking-one mappings and all 64 exact duty levels. PWM timing/ripple and hardwa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
    [encoding.py, firmware.py, host.py, test_encoding.py]
2026-10-20 Add guarded physical MNIST evaluation and simulator comparison
    Match the original cropped BOX-downsampled six-bit grayscale pipeline and validate the rounded-B DC1C-substituted 944/1000 simulator fixture before comparing each physical prediction. Gate evaluation on I2C topology, zero and walking-pixel response, finite voltage ranges, and save incremental per-image scores, timing, confusion and failure evidence without overwriting prior runs.
    Document wiring, nominal divider reconstruction, continuous-drive requirements and the actual USB blocker. All 18 host/encoding tests and Python compilation pass; preprocessing matches the simulator on 1000 randomized images. No physical accuracy run or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
    [evaluate.py, test_evaluate.py]
2026-10-20 Bracket physical MNIST evaluation with zero-input checks
    Repeat the validated zero-input measurement after all 1000 images and retain its drift from the initial sanity zero. Mark completion only after that final voltage gate passes. Persist per-measurement exceptions, including unsafe channel values, at the exact failed sample or sanity stage and stop without retrying.
    Python compilation and all 20 tests pass, including final-zero rejection and immediate mid-run abort evidence. This does not relax any ADC or score safety threshold.
    [evaluate.py, test_evaluate.py]
2026-10-20 Validate ADC conversion configuration and retain per-read evidence
    Allow the documented ADC startup interval before polling conversion readiness, and reject mux/PGA/mode readback mismatches rather than accepting a possibly wrong-channel conversion.
    Record channel, timestamp, config, raw value and zero-retry count for every successful conversion. Preserve those traces in host error messages so a failed safety gate does not erase the preceding readings. Outliers remain fail-stop and are never retried into acceptance.
    Validation: Python compileall and 23 host/encoding/evaluation/ADC tests pass. Physical zero diagnostic collected 50 reads for each of 12 channels; score6 stayed 1.684–1.686 V.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
    [firmware.py, host.py, test_adc.py]
2026-10-20 Reset Pico runtime before RAM uploads to release retained PIO programs
    Repeated raw-REPL firmware loads eventually failed StateMachine allocation with ENOMEM before the first ADC conversion. Soft-reset the interpreter before loading each trusted RAM firmware instance, and collect unreachable allocations before controller and drive setup.
    Validation: compileall and 23 tests pass. Physical clean-session zero and single-pixel gates passed, then the full 1000-image run completed with 590 correct versus 944 simulator, 403 disagreements, and 30120 traced ADC reads without retries. End-zero score1 drifted from 3.40 V to 13.55 V, so completion does not imply healthy analog hardware.
    [firmware.py, host.py]
